Senekw/chronoflow/manuscript/chronoflow.pdf

## ChronoFlow: an electricity-free, volumetric, clockwork-governed syringe infusion driver for neonatal care in low-resource settings

Design-and-simulation study — October 6, 2026

Abstract
Hospitals without reliable electricity deliver intravenous fluids and drugs to newborns by gravity drip or by hand. The only non-electric infusion devices available meter flow by pushing fluid through a restriction, so the delivered rate depends on fluid viscosity (temperature, drug) and on downstream pressure; low-cost electric pumps still need batteries and cost hundreds of dollars. We present ChronoFlow, a wind-up syringe driver that meters volume rather than pressure: a constant-force spring pushes the plunger and a rack-and-pinion drives a 3D-printed step-up gear train into a clockwork escapement whose balance wheel sets the rate. Two design problems were identified and solved by simulation. First, the mechanical power available to the escapement varies 24× across syringe sizes, clinical rates and loads (17–416 µW); a conventional lever escapement, whose impulse scales with train torque, over-banks over most of this range. Adapting the gravity-escapement principle of tower clocks with springs—a constant-force spring-arm escapement—delivers a fixed impulse energy per beat and holds the balance amplitude constant over the full range with a period error below 0.06 %. Second, a cross-spring flexure pivot was shown by a beam-column finite-element model to change stiffness by 17 % under the balance’s own weight; it was replaced by a taut-band torsion suspension made from 0.0015 in (38.1 µm) feeler-gauge steel ribbon, giving a 1.20 Hz balance with ±0.19 % orientation sensitivity and no pivot friction. Colour-coded gear cassettes provide 1, 2, 5 and 10 mL/h on a 20 mL syringe (0.4–19.5 mL/h across 5–60 mL syringes) at 0.12–1.16 µL per beat. A 20 000-sample Monte-Carlo error budget predicts that 95 % of units deliver within ±1.14 % of the set rate, compared with +45 % at 37 ◦C and −33 % at 100 mmHg back-pressure for flow-restriction pumps. A trip spring whose preload is keyed to the syringe size stops the oscillator and raises a flag at 300 mmHg occlusion (280–320 to 202–398 mmHg across syringe sizes once plunger-friction uncertainty is included) and a syringe-latch interlock prevents free-flow boluses. The 95-part assembly was modelled parametrically, checked for interferences and exported for printing; the bill of materials is $40. No physical prototype has yet been built; a bench protocol following IEC 60601-2-24 [13] is provided.

## 1 Introduction

Neonates require maintenance fluids at 60–100 mL/(kg d) and drugs such as antibiotics, dextrose and inotropes at 0.5–10 mL/h; a 10 % rate error or an uncontrolled bolus of a few millilitres is clinically significant. Electronic syringe pumps meet this need where mains power, batteries and service infrastructure exist. Where they do not, three alternatives have been described. Low-cost electromechanical pumps such as AutoSyP combine a constant-force spring with a motor and battery and reach ±4 % accuracy at a cost of goods of about $500 [1]. Non-electric flow-restriction devices (elastomeric pumps, the Springfusor, and an adjustable air-over-oil design [2]) obey Q ∝ ∆P/µ and therefore drift with fluid viscosity, temperature and back-pressure. Clockwork metering has been reported four times: a gravity-driven neonatal driver regulated by a pendulum metronome, which must sit level and still [3]; a wind-up kitchen-timer movement adapted for microfluidics [4] and its fully 3D-printed successor with a hairspring balance [5, 6], both with fixed rates set by gear choice and about an hour of running time; and a spring-driven leadscrew pump whose escapement is actuated electrically for insulin dosing [7].

The gap is a non-electric device that meters volume, works in any orientation, offers selectable clinical rates, runs for a full syringe without re-winding and has mechanical occlusion detection and free-flow protection. ChronoFlow addresses it by returning to two solutions from precision mechanics: the constant-force escapement, introduced by Denison for tower clocks whose train torque varied with wind and ice on the hands [8], and the taut-band suspension of galvanometers, which removes pivot friction and most positional error.

## 2 Design

### 2.1 Architecture and metering principle

Figure 1a–b shows the machine. Two constant-force springs (44.5 N total, 2 × 5 lbf) pull a carriage toward the syringe nozzle. The plunger load—syringe friction of 1.5–4.5 N plus pressure times bore area, up to 26.9 N for a 60 mL syringe at the 300 mmHg trip—absorbs part of this force; the excess back-drives a module-1 rack and 12-tooth pinion through a 5 × 5 × 5 × 2.5 = 312.5 step-up train and a plug-in rate cassette to a 15-tooth escape wheel. The escapement releases one half-tooth per beat of the balance, so the plunger advance per beat is fixed by geometry:

∆x =

πmz0

2Ze Nfixed rc

=

π · 1 · 12
2 · 15 · 312.5 · rc
mm, | (1)

which is 4.0 µm (1.16 µL on a BD 20 mL syringe) for the unity cassette. Because the metered quantity is displacement, viscosity, temperature and downstream pressure do not enter the rate until the occlusion trip point (Fig. 1c–d). The spring force is constant over the 95 mm travel, so runtime is set only by syringe volume (2–20 h per 20 mL fill) and the device never needs re-winding mid-infusion. A one-way click on the rack-pinion shaft lets the carriage be pulled back freely, so loading a syringe is the winding action (4.2 J stored, about eleven times the 0.37 J the escapement dissipates in 20 h).

### 2.2 Constant-force spring-arm escapement

Power delivered to the escapement is P = Fexcess v. With Fexcess between 17.6 N (60 mL syringe at its 300 mmHg occlusion trip) and 43.0 N (free-running 5 mL syringe) and v spanning the 1–10 mL/h cassettes, P ranges from 17 µW to 416 µW; after a train efficiency of 0.95×0.92⁶ = 0.58 (seven meshes in total: the rack mesh at 0.95 and six printed gear meshes at 0.92—four step-up, two cassette; the escape wheel shares the cassette output shaft) the escape-wheel torque spans 19–476 µN m, a 24× range. In a lever escapement the impulse energy delivered to the balance is proportional to this torque, so the balance amplitude scales as √
Te; our dynamic model (Section 3) shows it exceeding the 1.2 rad banking limit over most of the operating range (Fig. 2b–c). Stalling at the low end or over-banking at the high end are both failures of rate.
The spring-arm escapement (Fig. 2a) separates the two energy flows. Each escape-wheel tooth cocks one of two impulse arms against a printed flexure until a latch engages (phases 1–2). The train is then locked and any excess torque simply sits on the lock. When the balance passes, its impulse pin trips the latch (phase 3) and the arm delivers a fixed energy Eimp = 1.2 µJ over a 15◦ arc; the wheel then advances one half-pitch, re-cocks the opposite arm and relocks, the surplus train energy being dissipated in the locking impact. Train torque only has to exceed the re-cock minimum Tmin = Eimp/(ηlift π/Ze) = 9.5 µN m. The simulation confirms constant amplitude (0.59 rad at Q = 150) and a period error of 0.06 % from the slightly asymmetric impulse window across the whole torque range (Fig. 2c–d). Because the balance’s air damping cannot be known before a prototype exists, Q was swept from 40 to 800: amplitude settles between 0.31 and 0.99 rad and the period error between 0.45 and 0.01 % (Fig. 2e), a fixed offset that trim calibration absorbs.
The beat-level model takes Eimp and the latch cost as given; a mechanism-level analysis (Fig. 3, analysis_arm_mechanism.py) now predicts both from the specified parts and follows the escape wheel through a beat. The impulse energy is computed forward: a music-wire torsion spring of


Figure 1: A spring-driven, clockwork-governed syringe driver meters volume, so the delivered rate is independent of fluid temperature and back-pressure. (a) Labelled render of the parametric CAD assembly with a BD 20 mL syringe at 85 % fill and the 10 mL/h cassette. (b) Energy and metering chain; the left arrow follows energy from the spring to the balance, the right arrow follows the rate constraint back from the balance to the plunger. (c) Steady-state flow error versus fluid temperature for a flow-restriction pump calibrated at 20 ◦C (water viscosity from the Vogel equation) and for ChronoFlow (oscillator temperature coefficient −1.8 × 10−4 K−1
). (d) Flow error versus downstream back-pressure; ChronoFlow stops and flags at the 300 mmHg trip point. Green band: ±5 % clinical tolerance.

k = 1 × 10−4 N m/rad on the arm pivot, pre-loaded to 26.3

- by the latch, drives the arm (pivot-totip 59 mm) against the impulse pin on the hub (r = 6.2 mm); integrating the tip force through the pin’s circular path over the 15◦
impulse arc, with the cos φ work factor and a sliding loss µ = 0.15, gives Eimp = 1.20 µJ for an arm unwinding of 27 mrad, consistent with the value the beat model had assumed. The force droops by 6 % over the arc (this is the sense in which the impulse is “constant”); the energy changes by 3.9 % per degree of preload, so a 0.1 mm latch-position tolerance biases it by 1.4 % per build, beat-to-beat release scatter (5 µm) by 0.07 %, and µ between 0 and 0.3 by ±1.3 %. The printed 0.8 mm PETG flexure of earlier revisions is unsuitable for the opposite reason to the one given in revision 4: its stiffness, 3EI/L³
r

2 = 0.0149 N m/rad, is 150× higher than the wire spring’s, so to deliver 1.2 µJ it would need a preload of only 17 mrad—less than the 27 mrad stroke—and its force would pass through zero before the end of the impulse; it cannot act as a constant-force element, and the CAD now carries wire springs on the arm pivots. Unlatching costs µN d with a latch load of 2.7 mN over 0.3 mm: 0.10–0.35 µJ for µ = 0.1–0.4 (9–29 % of the impulse; the beat-level model had assumed 0.12 µJ). Re-running the beat simulation about the forward value, over Eimp ± 10 % and this unlatch range, moves the period error only between 0.050 and 0.108 % (Fig. 3d), a bias within the trim range.
Two consequences for the wheel itself are less benign. First, the wheel force on the locked tooth, Te/rw = 1.6–40 mN, exceeds the 8.9 mN arm force at the pallet above 107 µN m, i.e. over most of


Figure 2: A constant-force spring-arm escapement keeps balance amplitude and rate independent of the 24× variation in train torque that defeats a conventional lever escapement. (a) Working principle: a wheel tooth cocks a spring-loaded impulse arm (1), a latch holds it while the wheel is locked (2), the balance pin trips the latch and receives a fixed impulse (3). (b) Simulated balance angle θ(t) for both escapements at the minimum and maximum operating torques (19 and 476 µN m; RK4, Q = 150); dashed lines mark the banking limit. (c) Steady amplitude and (d) period error relative to the free oscillator versus escape-wheel torque; shaded band: operating range. Ticks at zero mark torques below the spring-arm re-cock minimum. (e) Spring-arm amplitude and period error versus the balance quality factor Q.

the operating map, so the wheel cannot be held by the arm during impulse: a separate detent locks the wheel. Its release is now a drawn linkage (Fig. 7b): each arm carries a tail behind its pivot (16 and 14 mm, ending just beyond and just short of the wheel axis so that the two tails, which move in opposite directions, turn a common release star the same way); the star turns on a stub axle coaxial with the escape shaft below the wheel, and its third arm pushes the L-tail of the detent lever, whose pivot sits tangentially beside the locking pin so that the pin withdraws radially. First-order kinematics of the drawn proportions give a pin withdrawal of 0.83–0.94 mm against the 0.6 mm needed to clear the tooth tips—a margin of 1.4–1.6 that is a bench-tuning item. Second, the surplus energy per beat, Teπ/Ze − Eimp/ηlift, is 2–98 µJ and arrives at the detent as kinetic energy of the wheel and the cassette gears reflected to it (Jeff 825–3670 g mm²
). The timing budget is set by the single wheel, not by the alternating arms: although each arm has a full period to be re-cocked, the wheel must complete its half-pitch run—detent release at the end of the impulse, free arc, cocking arc, re-lock—before the next beat, 0.416 s later, so the budget is half a period minus the impulse time, 0.36 s (revision 4 had used the full period). Integrating the wheel through the free and cocking arcs gives a re-cock-and-lock time of 0.06–0.14 s, a margin of 2.5× at the 1 mL/h cassette minimum and 3.2–4.0× for the other cassettes (Fig. 3a). A rigid steel-pin-on-PETG detent would see 2–14 N per impact and Hertz stresses of 35–92 MPa, beyond the 50 MPa PETG yield over most of the range, 1.7 × 10⁵
times per 20 h infusion. The detent is therefore carried on a 0.8 × 4 × 8 mm PETG flexure (k ≈ 2000 N/m), which limits the impact to 0.09–0.63 N and 7–19 MPa with 0.09–0.31 mm of deflection (Fig. 3b–c). The restitution and friction of these contacts are the inputs the model cannot supply; protocol step 2 measures them.


Figure 3: Mechanism-level analysis of the spring-arm escapement over the 24× torque range.
(a) Time for the escape wheel to run half a pitch, re-cock the arm and lock, against the budget of one beat interval (half a period) minus the impulse time; thick segments mark each cassette’s own torque range, Jeff is the wheel plus reflected cassette inertia. (b) Surplus energy per beat arriving at the detent and the resulting peak lock force for a rigid steel-pin-on-PETG stop and for the 2000 N/m flexure detent. (c) Per-beat energy ledger at the minimum, a mid-range and the maximum torque. (d) Period error from the beat-level simulation about the forward-model impulse energy, for Eimp ± 10 % and unlatch work spanning µ = 0.1–0.4.

### 2.3 Taut-band balance

The oscillator (Fig. 4a) is a printed PETG ring (62 mm outer diameter, 7.4 g, I = 5.2 × 10−6 kg m² )
clamped at the midpoint of a 2 mm-wide spring-steel ribbon cut from a 0.0015 in (t = 38.1 µm) feeler-gauge blade, held at both ends and pre-tensioned to T0 = 1 N by a steel coil spring. Each 22 mm half-band is a torsion spring [9] of stiffness

khalf =

GJ
Lh

+

T w²

12Lh

, J =

1

3wt³

(
1 − 0.63 t
w

)
, | (2)

giving k = 2.95 × 10−4 N m/rad and f0 = 1.20 Hz. Because k ∝ t
3
, the ribbon thickness is the dominant uncertainty: feeler stock is held to about ±2.5 µm, which alone would move f0 by ±9 %, far beyond any trim-weight range (an earlier revision modelled a 40 µm ribbon, 6 % off the true stock). Regulation is therefore two-stage. Both end clamps are adjustable (Fig. 7e): the upper clamp block is screwed through two M3 slots in a steel hanger plate bolted through the deck, and the lower clamp slides on guide pins in matching slots of a bracket that also carries the screwed spring-seat block of the tensioner, so the two are moved symmetrically and each half-band length Lh can be set between 18 and 26.5 mm while the hub stays centred; with k = khalf(Lup)+khalf(Llow) evaluated with each half’s actual length, symmetric adjustment to 18.4–26.1 mm re-centres f0 for


Figure 4: A taut-band suspension gives a friction-free 1.2 Hz balance whose rate is insensitive to orientation, temperature and fatigue. (a) Construction: feeler-gauge ribbon clamped to the deck and to a spring-loaded tension clamp, balance ring clamped at mid-span. (b) Balance frequency versus radial position of the four trim nuts; the dashed line is the target for the unity cassette and the band is ±0.5 %.
(c) Frequency change between the band-horizontal and band-vertical positions for the taut band, compared with the computed first-order change of a 0.05 mm cross-spring flexure pivot under the same balance weight.
(d) Peak ribbon shear stress versus amplitude; shaded band: amplitudes reached for Q = 40–800. (e) Rate drift versus ambient temperature.

any ribbon between 35.6 and 40.6 µm (coarse, set once per ribbon). Adjusting one clamp alone would halve the sensitivity (1.1 % per mm against 2.2 %) and the same slot would then cover only 36.6–39.4 µm, so one-sided adjustment is not sufficient; four M3 brass nuts in radial slots (23–29 mm) then regulate the frequency by −2.4 to +3.1 % (Fig. 4b), exactly as a clock is regulated, with a nominal set point of 26.4 mm.
Gravity enters only through the tension term: with the band vertical, the fixed-clamp half-band carries T0 ± mg while the tensioner fixes the other at T0. Because the tension term is 10 % of k and mg ≪ T0, the frequency shifts by only ±0.19 % between the upright and inverted positions (Fig. 4c). An alternative two-leaf cross-spring flexure pivot [10], analysed with an Euler–Bernoulli beam-column finite-element model including geometric stiffness, changed rotational stiffness by 17 % under the same balance weight (the governing scale is EI/L² ≈ 0.1 N, not the Euler load) and was rejected. Peak shear stress at the 1.2 rad banking limit is 166 MPa against a conservative fully-reversed fatigue limit of 350 MPa (Fig. 4d), and the temperature coefficient, combining the shear-modulus drift of steel with the thermal expansion of the ring, is −1.8 × 10−4 K−1
(Fig. 4e).

### 2.4 Rate cassettes, safety functions and structure

A plug-in cassette carries two gear pairs with constant tooth sums (z1 + z2 = z3 + z4 = 66, 33 mm
centres): (33, 33, 33, 33), (44, 22, 33, 33), (33, 33, 55, 11) and (44, 22, 55, 11) give speed-up ratios of 1, 2, 5 and 10 and hence 10, 5, 2 and 1 mL/h on a 20 mL BD syringe; other syringe sizes scale with bore area (Fig. 5a). The cassette is a visible, colour-coded object, so the set rate can be confirmed at a glance and cannot drift. Because the carriage speed is set by the cassette alone, the escape-wheel torque depends only on the cassette and on the excess force Fspring − Fplunger; the operating map was therefore evaluated over every syringe size, cassette and back-pressure from zero to the trip (80 cells). The torque exceeds the re-cock minimum of 9.5 µN m by at least 2.0× in every cell, the worst being the 60 mL syringe on the 1 mL/h cassette at its 300 mmHg trip (Fig. 5b). This map is what forced the drive spring from the 30 N of the first revision to 44.5 N: at 30 N the 60 mL trip left only 3.1 N excess, 3.4 µN m at the slowest cassette, and the escapement would have stalled before the occlusion flag was raised (two cells stalled, four below 1.7×). The per-beat volume is 0.12–1.16 µL (Fig. 5c).
Three safety functions are mechanical. (i) The occlusion trip (Fig. 6; CAD in Fig. 7c–d) is snap-acting. The pusher head rides on a 8 mm steel stem backed by a 3 N/mm compression spring whose preload is set by a spacer keyed to each syringe cradle insert, so the setting follows the syringe size automatically. When the plunger reaction exceeds the preload the stem retracts; a trip pin on its end collar stands 0.15 mm behind the tail of a sear, a printed plate on a vertical pivot whose hook lip overlaps a collar on a separate flag rod by 0.9 mm. The sear’s lever ratio (hook arm 9, tail arm 2 mm) is 4.5, so the lip clears the collar after a further 0.20 mm: the sensing travel is 0.15 + 0.9/4.5 = 0.35 mm, and it is a geometric property of the modelled parts rather than an assumption. The flag rod, driven by its own 2 N spring, then rises 6 mm and does three things: it exposes the red flag; its lift collar frees a torsion-sprung rocker on the carriage top whose short end drives a 2 mm steel capture pin 2.2 mm down into a slot in the stem top; and its head lifts a frame-mounted rail that runs the length of the carriage travel on two parallel-motion cranks, so the rail translates by the same 6 mm wherever the carriage is. A drop rod from the rail passes through the deck and raises a two-pin fork (pins at 80 and 100◦
, r = 18 mm) around a balance spoke, confining the balance to ±0.05 rad—below the 6
- unlock angle—so the escapement cannot unlock, ticking stops and pressure cannot rise further. Defining the trip at 0.35 mm rather than at a full 3 mm of stem travel matters: over 3 mm the spring force would rise by 9 N (+235 mmHg on a 20 mL syringe, and enough to take the 60 mL case below the re-cock minimum before the flag appeared); over 0.35 mm it rises by 1.05 N, and the spacer preload is set 1.05 N below the intended trip force so that the sear releases at 300 mmHg × A + Ffriction: trip forces 6.1, 8.6, 14.5, 18.3 and 26.9 N from spacer preloads of 5.0, 7.6, 13.4, 17.2 and 25.8 N (1.7–8.6 mm) for the 5, 10, 20, 30 and 60 mL syringes. The operating-map margins above are therefore unchanged by the trip. The slot’s forward wall is cut 0.35 mm short of the pin, so that after the sensing travel it is flush with the pin and the 0.35 mm of spring compression stored at the trip (0.04–0.20 mL of syringe volume, 60 mL largest) cannot advance the plunger when the blockage clears; this is checked on the solids rather than asserted: posing the tripped assembly with the stem advanced by 0.1 and 0.2 mm produces pin–stem interference (0.08 and 0.24 mm³
), while the armed and tripped poses are interference-free, and rotating the balance by ±0.04 rad inside the raised fork is free but ±0.08 rad is blocked. Ideally, then, the captured stem prevents release of the trip-spring displacement; the Boolean tests establish geometric restraint in the checked poses, not zero displacement under pin– slot clearance, deformation, wear or capture delay, so the residual displacement and the total release bolus (including the elastic volume stored in the line and syringe at 300 mmHg) require measurement against the 0.2 mL target (protocol step 5). Reset is part of loading (Fig. 7c): the LOAD/RUN lever lifts the rack-pinion click so the carriage can be pulled fully back to receive the new syringe, and in the last 12 mm of that travel the flag head runs under a frame-mounted reset ramp (6 mm drop over 6 mm, then flat) that presses the rod down: the chamfered hook collar pushes the sear lip aside and the sear snaps back over it on its return spring, the lift collar turns the rocker back and raises the capture pin out of the stem slot, and the rail settles onto the head. The Boolean check confirms the geometry: at the loading position the tripped flag head intersects the ramp (the ramp drives it down) while the armed head is clear. A force trip senses friction as well as pressure, so the pressure at which it fires carries the friction uncertainty: for ±1.5 N of plunger glide-force variation (lot, speed, dwell) the 300 mmHg setting fires between 280 and 320 mmHg on the 60 mL syringe but between 202 and 398 mmHg on the 5 mL syringe, whose bore is five times smaller. These bands are the disclosed occlusion-alarm range; tightening them for the small syringes requires measuring glide force per syringe lot and shimming the spacer, which the validation protocol includes. (ii) The LOAD/RUN lever opens the syringe flange latch and lifts the rack-pinion click together, so the carriage can only be moved by hand when the syringe is unlatched and a fast-forwarded pusher

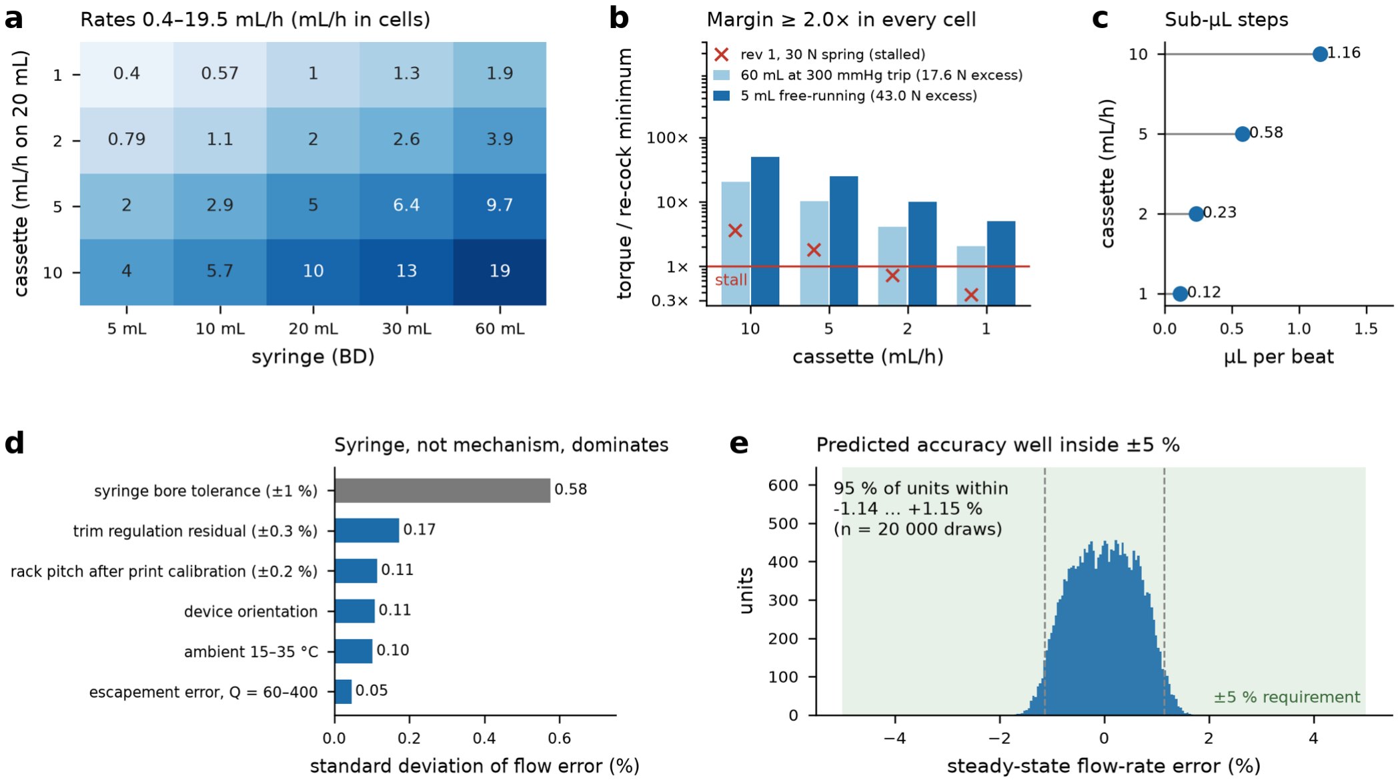
[picture p8: figure]

Figure 5: Four plug-in cassettes cover neonatal rates with torque margin and sub-microlitre resolution; the predicted error is dominated by the syringe, not the mechanism. (a) Flow rate for each cassette and BD syringe size. (b) Escape-wheel torque relative to the arm re-cock minimum at the two extremes of the syringe × cassette × pressure map (60 mL syringe at its 300 mmHg trip; 5 mL syringe free-running); crosses show the first revision’s 30 N spring, which stalled. (c) Volume delivered per beat. (d) Standard deviation of flow error contributed by each Monte-Carlo input. (e) Distribution of steady-state flow error over 20 000 draws; dashed lines mark the central 95 %.

slides the whole syringe rather than expelling fluid. (iii) The balance beats behind a window at 1.2 Hz; silence means stopped.
The most heavily loaded teeth are the rack and 12-tooth pinion: Lewis bending stress [11] at 44.5 N on an 8 mm face is 22.7 MPa against about 50 MPa PETG yield (safety factor 2.2; widening the stage-1 face to 10 mm would restore 2.75). Torque falls 5× per stage (267, 49, 9.0, 1.7 mN m), so the remaining printed gears are lightly loaded; shafts are 3 mm steel pins in printed bores.

## 3 Methods

Parametric design. All dimensions, tooth counts and oscillator parameters live in one module (design_params.py); the CAD (cad_model.py, CadQuery 2.8) derives shaft positions from gear centre distances, phases every mesh so that a wheel tooth faces a pinion gap, and exports STEP, glTF and per-part STL. The gear train is posed with the carriage: every gear is rotated by the rack displacement through the seven meshes (the displacement being trimmed by < 0.03 mm so that the escape wheel sits at a locked tooth). A pairwise interference check (bounding-box prefilter, OpenCascade Boolean common) is run over all 4 465 part pairs in twelve poses—carriage at full, half and empty syringe, armed and tripped, balance at rest and at ±0.6 rad. Overlaps are compared against an explicit list of 28 named part pairs, each with a physical reason and a volume cap (pressfit pins, threaded screws, the drawn 0.1 mm penetration of a locked tooth, the tooth-tip overlap of the unshifted 12-tooth pinions, ≤ 0.7 mm³

); anything else above 0.05 mm³ is a fault. The earlier
keyword whitelist (any pair containing “pin”, “shaft” or “axle”) and single pose were replaced in this revision; the multi-pose check found and fixed three real collisions in revision 4 (rack against the cradle at the empty-syringe position, the trip rail’s rear post against the carriage at full travel, and the capture-pin rocker against its boss in the tripped pose) and, in this revision, placed the


Figure 6: Snap-action occlusion trip: the trip force is defined by a 0.35 mm sensing travel set by the sear geometry, and the stem is captured so stored spring compression cannot become a bolus. (a) Armed, sensing and tripped states (schematic; the modelled parts are in Fig. 7c–d): spacer-set preload, 0.35 mm stem retraction turns the sear, 6 mm flag-rod release drops the capture pin into the stem slot and lifts the rail and balance fork. (b) Trip-spring force versus stem travel for three syringe sizes; the sear releases at 0.35 mm (+1.05 N, pre-compensated in the spacer); the grey band is the 3 mm direct-travel design of the previous revision. (c) Per-syringe spacer preload, trip force, firing band for ±1.5 N plunger-friction uncertainty, and the displacement stored at the sear if the stem were not captured.

detent-release and reset parts (the tripped pose is taken at 85 % fill, since at the fully retracted loading position the ramp has by construction reset the trip); the last run reports zero faults in all twelve poses (results/interference_report.json). All 95 exported STL meshes are watertight (the carriage rack previously ran a partial last tooth past its end and produced a self-intersecting profile).

Escapement dynamics. The balance obeys I

¨θ = −kθ − c

˙θ + τ (θ, ˙θ) with c = Iω0/Q, integrated by fourth-order Runge–Kutta at ∆t = 0.2 ms. For the lever model the per-beat wheel energy Teπ/Ze is split into an impulse fraction (0.70) applied over a 30◦
lift arc and an unlocking fraction
(0.12) opposing motion over 6

◦
. For the spring-arm model the impulse energy is fixed at Eimp over 15◦
starting 3
- before equilibrium, with a fixed 0.12 µJ latch-tripping cost; the escapement stalls if Te < Tmin. A reversal of the balance while the pin is inside the engagement window is treated as a fault. Period is measured over steady-state zero crossings. The mechanism-level model (analysis_arm_mechanism.py) integrates the wheel, Jeffφ¨ = Te − Tcock(φ) − cφ˙, from the unlock to the lock over the free arc and a 0.1 rad cocking arc, with Jeff the wheel plus every upstream gear reflected by its speed ratio squared; lock forces use F =

√
2Ekstop and Hertz line contact for a 1 mm steel pin on PETG (E∗ = 2.2 GPa).

Table 1: Predicted performance of ChronoFlow (BD 20 mL syringe unless stated) and bill of materials.

Quantity | Value
Rates (cassettes 1/2/5/10) | 1, 2, 5, 10 mL/h; 0.4–19.5 mL/h across 5–60 mL syringes
Resolution | 0.12–1.16 µL per beat, 2.4 beats s−1
Oscillator | 1.2017 Hz; coarse Lh 18–26.5 mm, trim −2.4/+3.1 %; orientation ±0.19 %;
| −1.8 × 10−4 K−1
Escapement | amplitude 0.59 rad (Q = 150), period error 0.06 % (0.05–0.11 % over Eimp ±
| 10 %, µ 0.1–0.4); torque margin ≥ 2.0× over 5 syringes × 4 cassettes × 0–
| 300 mmHg; forward-model impulse 1.20 µJ; re-cock + lock ≤ 0.14 s vs 0.36 s
| beat budget (≥ 2.5×); detent impact ≤ 0.63 N, 19 MPa, 0.31 mm with flexure
| detent
Accuracy (Monte-Carlo, n = 20 000) | 95 % of units within −1.14 to +1.15 %; 99th percentile |error| 1.36 %
Restriction-pump compara- tor | +45 % at 37 ◦C; −23 % at 10 ◦C; −33 % at 100 mmHg back-pressure
Occlusion trip | 300 mmHg nominal; snap-action sear at 0.35 mm sensing travel (from the sear
| geometry), spacer preload keyed to cradle insert (5.0–25.8 N, trip 6.1–26.9 N);
| fires at 280–320 (60 mL) to 202–398 mmHg (5 mL) for ±1.5 N friction; stem
| captured by a pin in a slot (geometric restraint verified by solid Booleans;
| residual displacement to be measured)
Energy | 4.2 J stored per wind; 0.37 J consumed in 20 h
Structure | rack-pinion tooth stress 22.7 MPa (SF 2.2); band stress 166 MPa vs 350 MPa
| limit
Parts, cost | 95 parts, ≈420 g PETG, BOM ≈ $40; zero interference faults in 12 poses;
| 95/95 STL meshes watertight

Oscillator. Band stiffness follows Timoshenko’s thin-strip torsion with the tension term; the cross-spring pivot comparison uses a 60-element Euler–Bernoulli beam-column model per leaf (elastic plus geometric stiffness), with the balance rotating rigidly about the crossing point and gravity resolved onto the two leaves.

Error budget. 20 000 Monte-Carlo draws combine a uniform syringe bore-area spread of ±1 % (an assumption: ISO 7886-1 [14] specifies the capacity tolerance of the finished syringe, not the within-lot bore distribution, and manufacturer bore data were not available to us; systematic differences between syringe models and design revisions are absorbed by the per-model cradle insert and calibration, and the protocol measures the within-lot bore spread of ten syringes per lot—with ±2 or ±3 % spread the central 95 % band would widen to about ±2.1 and ±3.2 %, still inside the ±5 % requirement), trim regulation residual (±0.3 %), rack pitch after print-scale calibration (±0.2 %), ambient temperature (15–35 ◦C), orientation (±0.19 %) and the escapement error for Q uniformly in 60–400 after calibration at the mean.

Comparators. Flow-restriction pumps are modelled as Q ∝ (Pdrive −Pback)/µ(T) with water viscosity from the Vogel equation [12] (µ = 0.02939 exp[507.88/(T −149.3)] mPa s) and drive pressures of 300 and 500 mmHg.

## 4 Results

Table 1 collects the predicted performance. Two results carry the design. First, the escapement study (Fig. 2) shows that the conventional lever escapement is unusable across the clinical range—its amplitude passes the banking limit at about 40 µN m, below the mid-point of the operating band— whereas the spring-arm escapement holds 0.59 rad from the re-cock minimum upward with a period error of 0.06 %. Second, the suspension study (Fig. 4) shows that the taut band reduces orientation sensitivity by a factor of about forty relative to a cross-spring pivot of the same leaf stock, while keeping the ribbon stress at 47 % of the fatigue limit at the banking amplitude. The system-level consequences (Fig. 5) are a rate set entirely by integers (tooth counts) and one calibrated frequency, a torque margin above the re-cock threshold at every rate, and a predicted accuracy distribution whose width is set mainly by the syringe bore tolerance that every syringe pump shares.
Against flow-restriction pumps the difference is categorical rather than incremental (Fig. 1c–d): a restriction pump calibrated at 20 ◦C over-delivers by 45 % at body temperature and loses a third of its rate against 100 mmHg of venous or catheter back-pressure, whereas ChronoFlow drifts by less than 0.4 % over 10–40 ◦C and is unaffected by back-pressure until it trips.
The CAD model (Fig. 7) is complete at the part level: deck and bottom plates, pillars, rails, cradle with flange latch and barrel clamp, carriage with integrated rack, the pusher stem with keyed spacer, trip spring, sear, flag rod, rocker and capture pin, the trip rail with its cranks, drop rod and balance fork, the reset ramp, spring drum, the four-stage train, cassette, escape wheel, two impulse arms with wire torsion springs, release tails and latch, the release star and the radially acting wheel detent, and the balance with band, slotted clamps and tensioner. The model is built in two states (armed and tripped), the capture function and the reset are demonstrated on the solids (Fig. 7c–d), and the two operating links that revision 4 left undrawn—arm-to-detent release and the trip reset—are now parts.

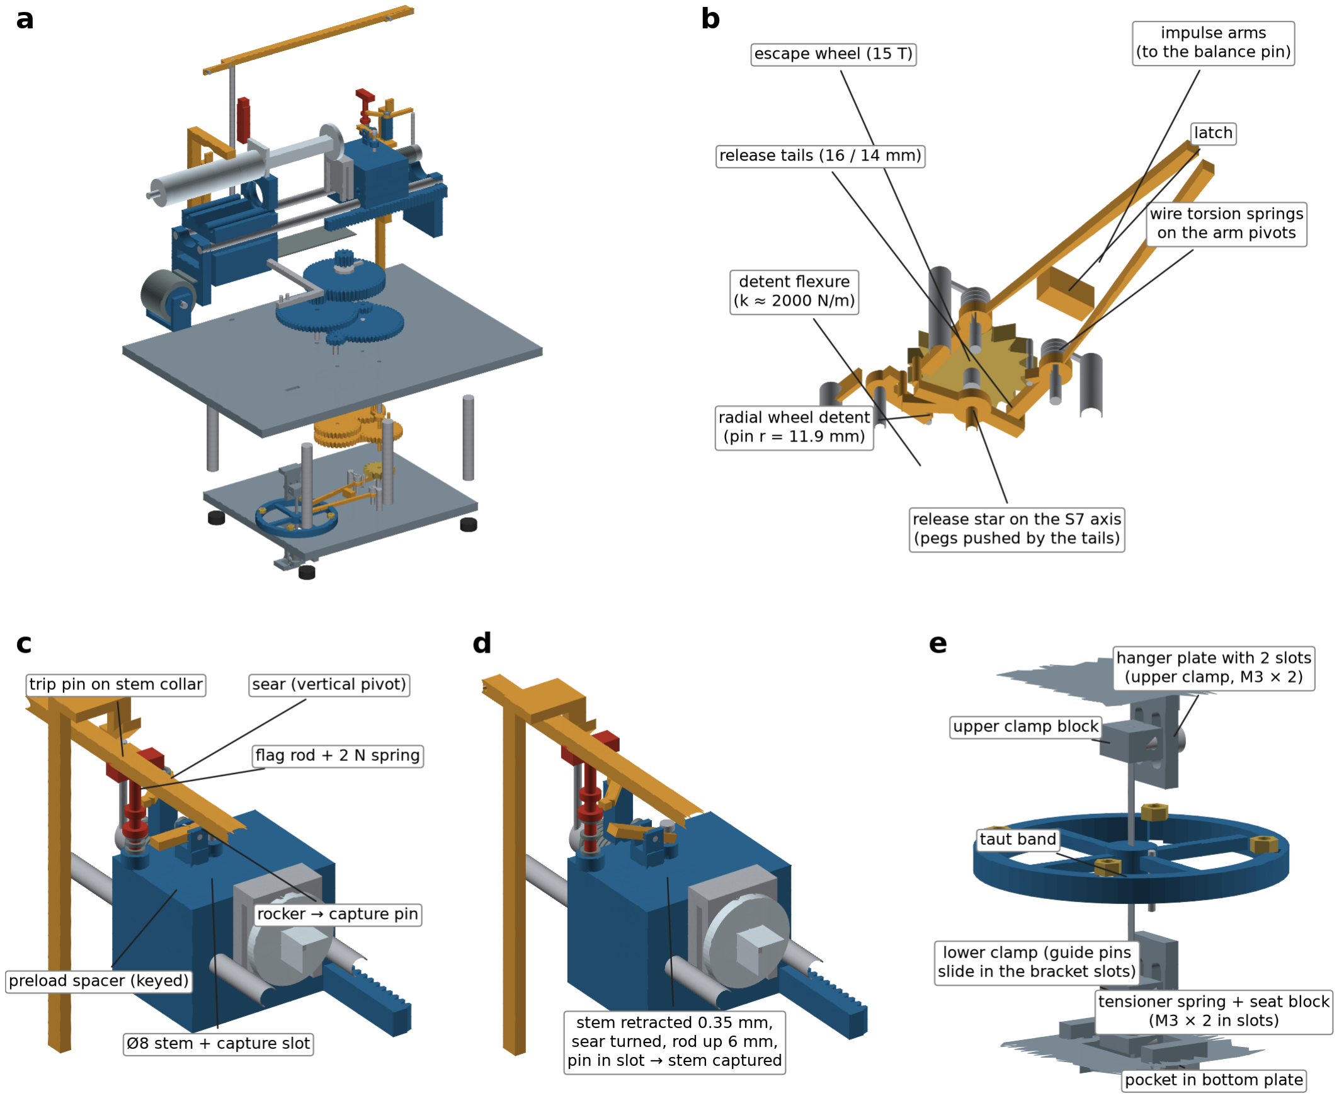
[picture p9: figure]

Figure 7: The 95-part assembly, including the snap-action occlusion trip with its reset ramp, the detent-release linkage and the adjustable band clamps, is modelled and interference-checked in twelve poses. (a) Exploded view with parts separated along the vertical axis. (b) Escapement module with the deck removed: cassette, escape wheel, impulse arms with wire torsion springs and release tails, release star on the escape axis, radially acting compliant wheel detent, balance with stop fork and slotted clamp hanger. (c) Occlusion trip on the carriage, armed: keyed spacer and trip spring behind the stem, trip pin on the end collar, sear on its vertical pivot holding the flag-rod collar, rocker and capture pin over the stem; the reset ramp is visible ahead of the flag head. (d) The same parts in the tripped pose: stem retracted 0.35 mm, sear turned, flag rod up 6 mm, capture pin in the stem slot, rail lifted. (e) Band clamps: slotted hanger plate with M3 screws for the upper clamp, slotted bracket with guide pins and screwed spring-seat block for the tensioner, both covering Lh 18–26.5 mm.

## 5 Discussion

ChronoFlow converts two precision-mechanics solutions—the constant-force escapement and the taut-band suspension—into a printable, electricity-free infusion driver whose predicted accuracy is limited by the syringe rather than by the fluid, the temperature, the back-pressure or the orientation of the device. Every safety function is mechanical and visible, and the rate is a physical object a nurse can hold and verify.
Several limitations follow from the fact that this is a design-and-simulation study. All performance figures are model predictions; the models are physics-based but unvalidated until the bench protocol below is executed. The balance quality factor in air and the efficiency of printed gear meshes are the least certain inputs; both were swept and both affect margin rather than rate. The spring-arm escapement geometry in the CAD is a representative embodiment whose latch, arm and detent proportions will need iteration on the bench, as horological escapements invariably do; the detent-release linkage and the reset ramp are drawn but their first-order kinematic margins (1.4–1.6 on pin withdrawal) are small. The mechanism-level analysis predicts the impulse energy from a specified spring rather than assuming it, but its contact parameters (latch and tip friction, detent restitution) are inputs the bench must supply, and the stem capture is a geometric restraint whose residual displacement under clearance, deformation and wear is unmeasured. Standalone reproduction of every figure was re-tested in this revision: the analysis scripts fall back to a bundled copy of the plotting helpers when the authoring environment is absent. The occlusion trip must be set per syringe size, which is a training requirement, and rates between cassettes require an additional printed cassette (any tooth set with sums of 66 can be made). The 0.12–1.16 µL pulsatility is small compared with a 50 µL gravity-drip drop, but very low-rate inotrope infusions below 0.5 mL/h would be better served by a 5 mL syringe.

Validation protocol. (1) Measure the ribbon thickness with a micrometer (±1 µm) and set the clamp post to the Lh the stiffness model gives for that thickness; print the balance, clamp the ribbon and measure f0 with a 240 fps camera or light gate; set trims; measure Q from the free-decay envelope; repeat band-horizontal, clamp-up and clamp-down (acceptance ±0.3 %). (2) Drive the escape wheel through the cassette with hanging weights emulating 17.6 and 43 N excess (the 60 mLat-trip and 5 mL-free-running corners of the operating map); verify re-cocking within one beat interval at the 1 mL/h cassette and constant amplitude by video tracking; measure the impulse energy from the balance’s amplitude decay with the arm disengaged versus engaged, and the detent-release margin by shimming the arm tails; tune the torsion-spring preload (latch position) and the detent pin radius. (3) Gravimetric flow test per IEC 60601-2-24 on a 1 mg balance logged every 30 s for 2 h per cassette; compute trumpet curves (acceptance: mean error ±5 %, trumpet ±10 % at 2 min). (4) Repeat at 0, 100 and 200 mmHg back-pressure and with 10 % dextrose at 20 and 37 ◦C (expected change < 1 %). (5) Occlusion, for each syringe size with its cradle insert: measure plunger glide force on a load cell at the cassette speed (five syringes per lot), then clamp the line and record trip pressure against the predicted band (280–320 to 202–398 mmHg for 60 mL to 5 mL; shim the spacer if the lot’s glide force differs from nominal by more than 0.5 N), time to trip, the stem position after trip (dial gauge: residual creep of the captured stem under clearance and deformation), the total bolus on release (< 0.2 mL, line compliance plus any residual stem displacement), and the reset at full retraction. Measure the bore of ten syringes per lot (bore gauge) to replace the assumed ±1 % area spread. (6) Orientation and vibration (expected < 0.5 %). (7) Seven-day continuous run and 200 load/unload cycles.

## Data and code availability

The parametric CAD (STEP, glTF, STL), the analysis code that reproduces every figure and number in this paper, the interference checker and the interactive viewer are provided in the accompanying repository.

## References

[1] Juarez A, Maynard K, Skerrett E, Molyneux E, Richards-Kortum R, Dube Q, Oden ZM. AutoSyP: a low-cost, low-power syringe pump for use in low-resource settings. Am J Trop Med Hyg 2016;95(4):964–969. doi:10.4269/ajtmh.16-0285.
[2] Guelig D, Bauer J, Wollen A, Schiller C, Sherman-Konkle J, Roche A, Weyrauch K, Eisenstein
M. Design of a novel, adjustable flow rate, reusable, electricity-free, low-cost syringe infusion pump. ASME J Med Devices 2017;11(4):041006. doi:10.1115/1.4037935.
[3] Sung C, Kamath RR, Cui Y, Ouyang C, Carstens E, Ramos RF, Oden ZM. Design of a novel mechanical syringe pump for neonatal care in low-resource settings. In: 2011 IEEE Global Humanitarian Technology Conference; 2011. p. 78–83. doi:10.1109/GHTC.2011.21.
[4] Han W, Kim S, Shin S, Yang SY, Choi S, Shin JH. Wind-up precision pump for portable microfluidics. Sens Actuators B Chem 2021;347:130592. doi:10.1016/j.snb.2021.130592.
[5] Park SB, Shin JH. Fully 3D-printed, nonelectric, spring-powered syringe pump for operating microfluidic devices. Sens Actuators B Chem 2024;405:135289. doi:10.1016/j.snb.2024.135289.
[6] Park SB, Shin JH. Open-source spring-driven syringe pump with 3D-printed components for microfluidic applications. HardwareX 2024;19:e00550. doi:10.1016/j.ohx.2024.e00550.
[7] Pooke F, Payne M, Holder-Pearson L, Heaton D, Campbell J, Chase JG. Low-cost, low-power, clockwork syringe pump. HardwareX 2023;16:e00469. doi:10.1016/j.ohx.2023.e00469.
[8] Denison EB. A Rudimentary Treatise on Clocks, Watches and Bells. London: John Weale; 1850 (gravity escapement, ch. on remontoires and gravity escapements).
[9] Timoshenko SP, Goodier JN. Theory of Elasticity, 3rd ed. New York: McGraw-Hill; 1970. § 109, torsion of a thin rectangular strip.
[10] Haringx JA. The cross-spring pivot as a constructional element. Appl Sci Res 1949;A1:313–332. doi:10.1007/BF02120338.
[11] Lewis W. Investigation of the strength of gear teeth. Proc Engineers’ Club of Philadelphia 1893;10:16–23.
[12] Vogel H. Das Temperaturabhängigkeitsgesetz der Viskosität von Flüssigkeiten. Phys Z 1921;22:645–646.
[13] IEC 60601-2-24:2012. Medical electrical equipment — Part 2-24: Particular requirements for the basic safety and essential performance of infusion pumps and controllers. Geneva: International Electrotechnical Commission; 2012.
[14] ISO 7886-1:2017. Sterile hypodermic syringes for single use — Part 1: Syringes for manual use. Geneva: International Organization for Standardization; 2017.
