Senekw/chronoflow/figures/analysis/fig2_escapement.png

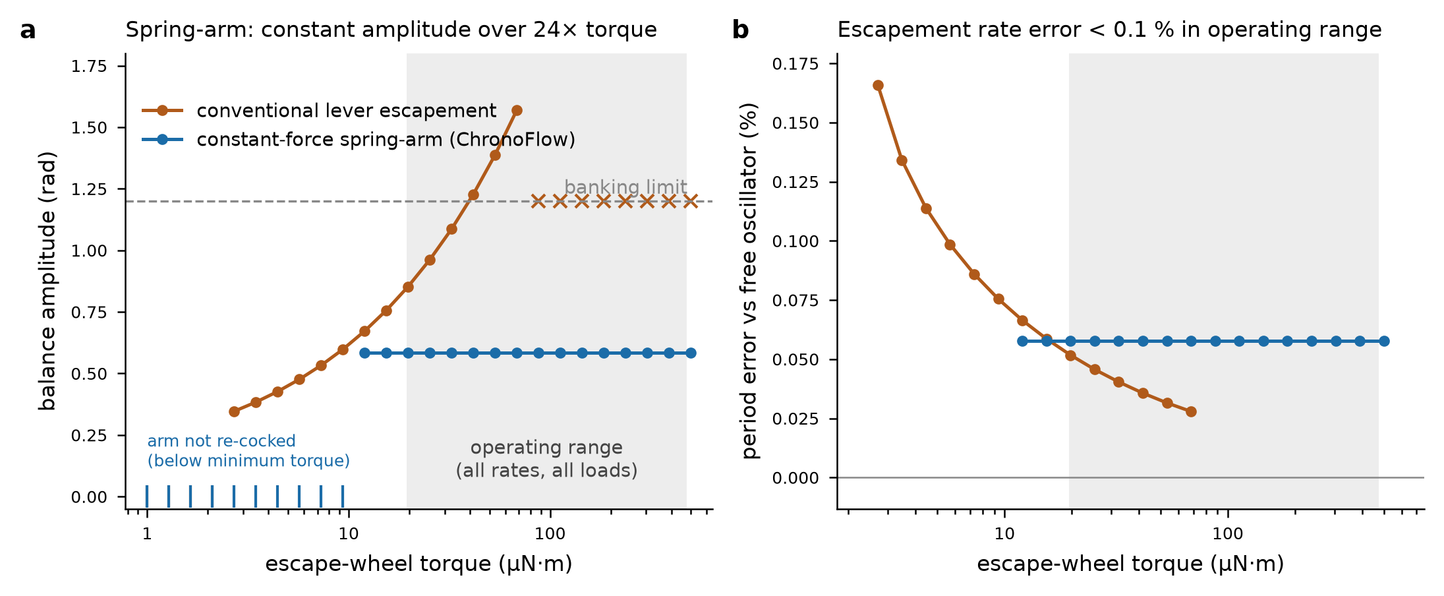
figures/analysis/fig2_escapement.png
