Senekw/chronoflow/figures/analysis/fig3_accuracy_comparison.png

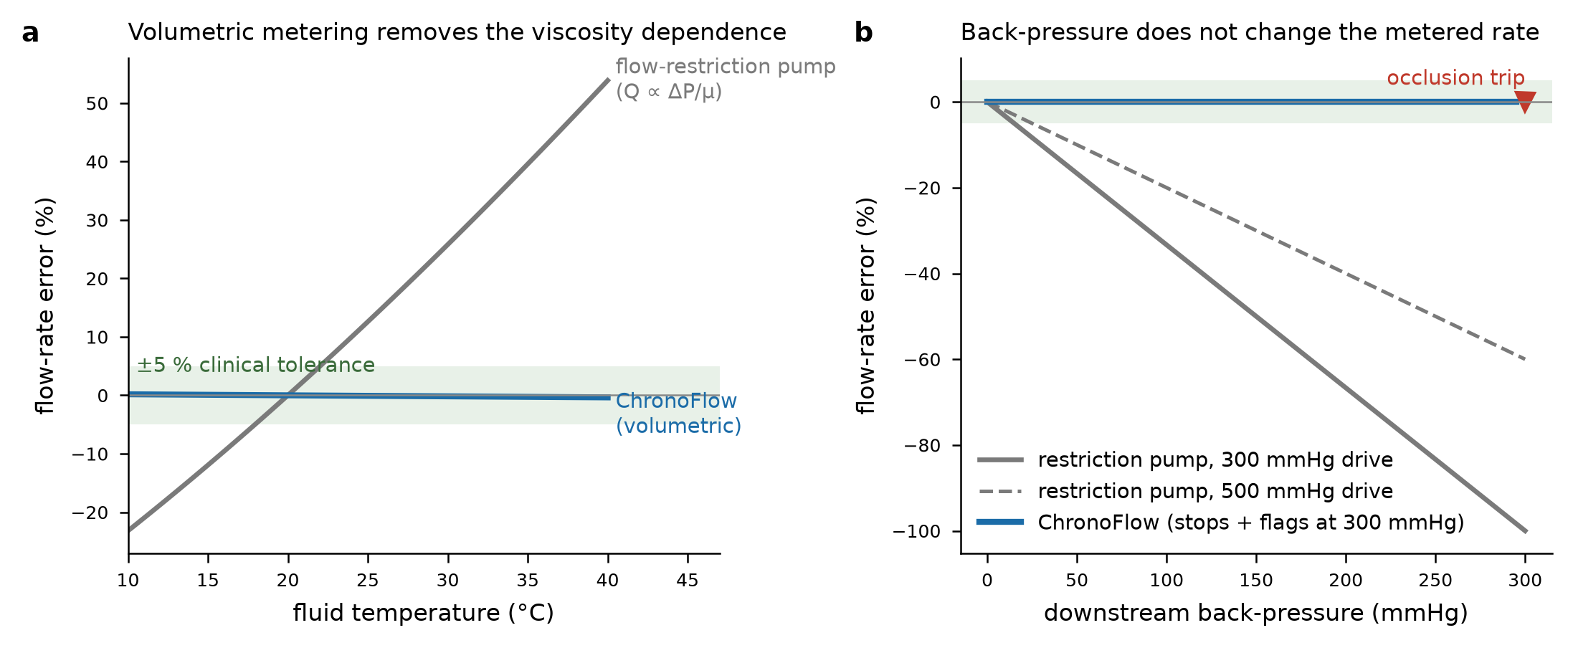
figures/analysis/fig3_accuracy_comparison.png
