Senekw/chronoflow/figures/analysis/fig4_error_budget.png

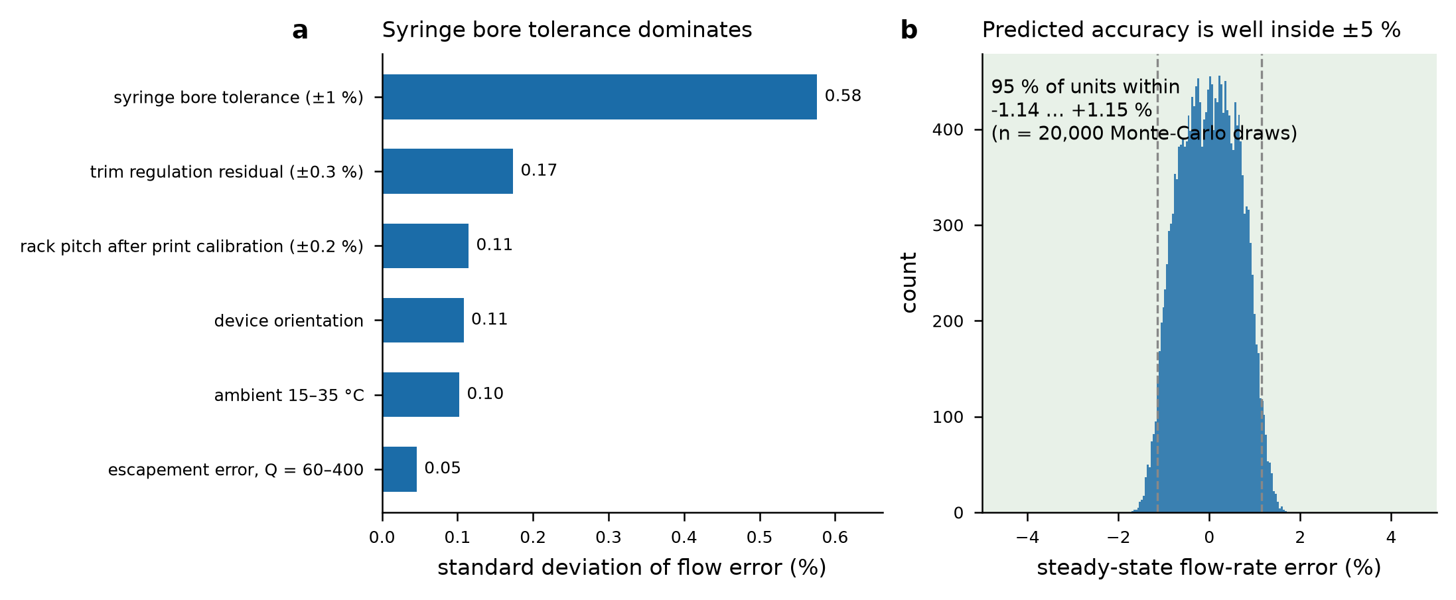
figures/analysis/fig4_error_budget.png
