Senekw/chronoflow/figures/renders/escapement_closeup.png

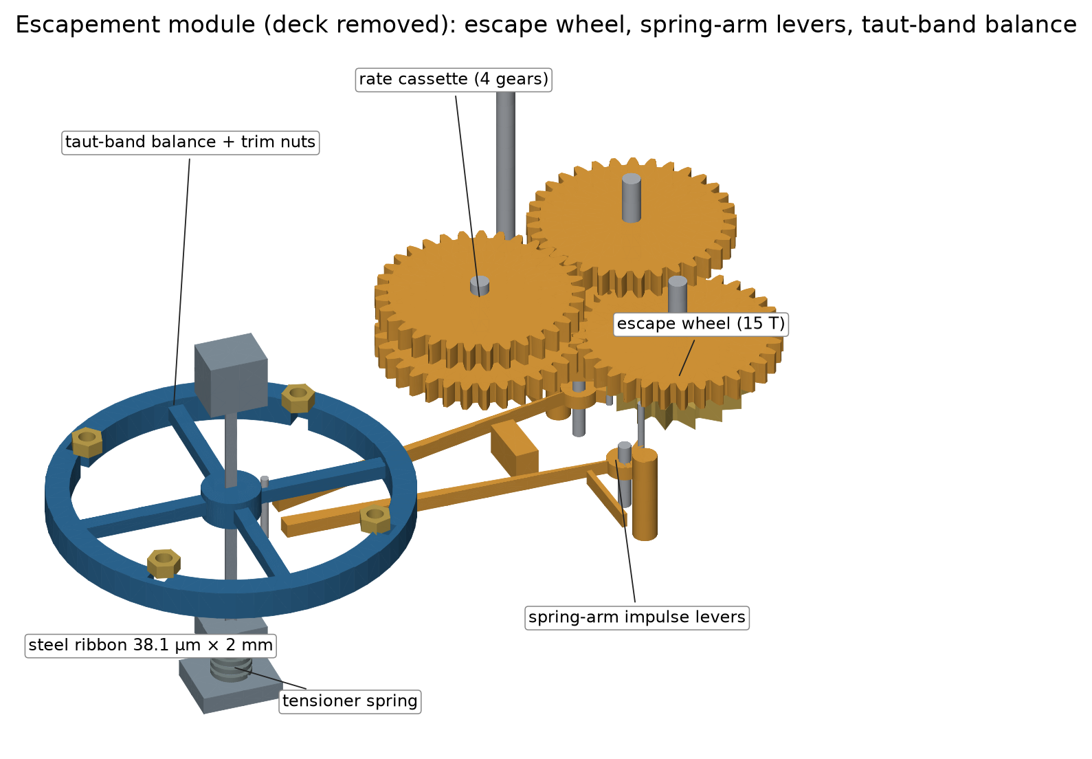
figures/renders/escapement_closeup.png
