Senekw/chronoflow/figures/renders/exploded_view.png

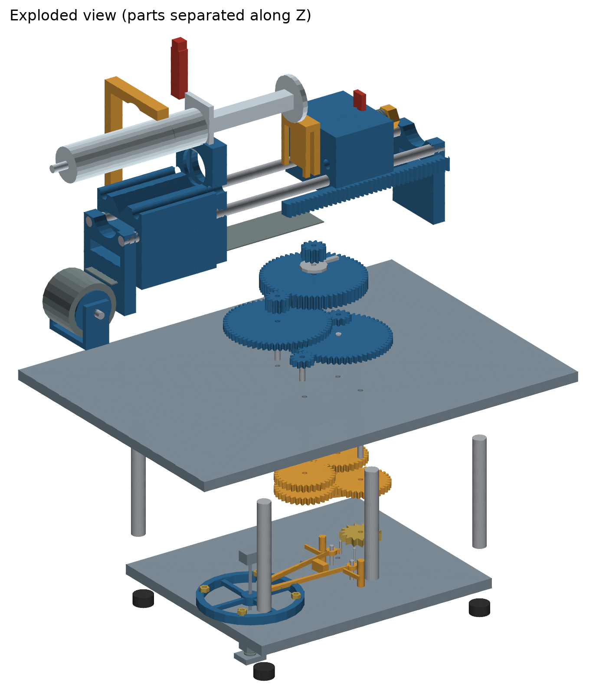
figures/renders/exploded_view.png
