Senekw/chronoflow/figures/renders/fig1_a.png

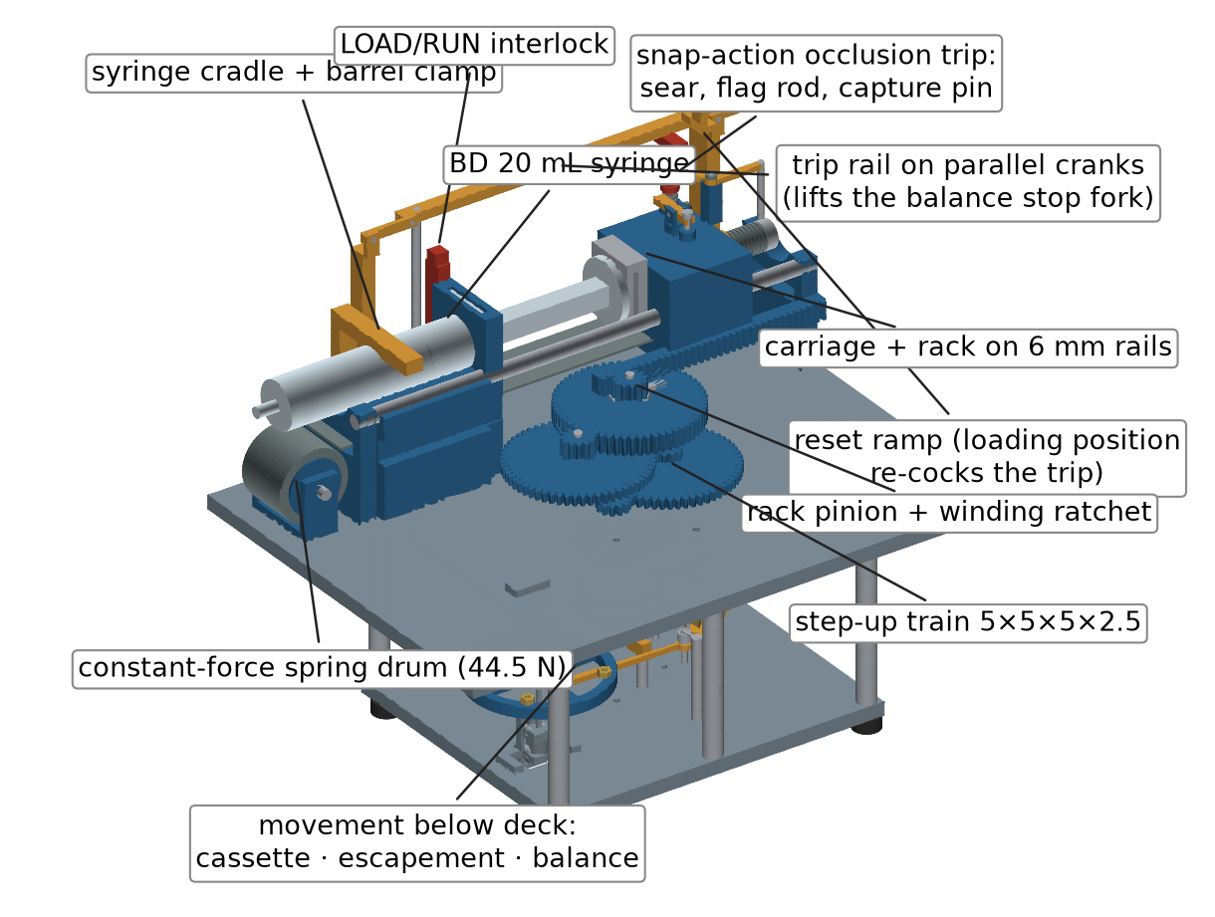
figures/renders/fig1_a.png
