Senekw/chronoflow/figures/renders/fig1_labeled_overview.png

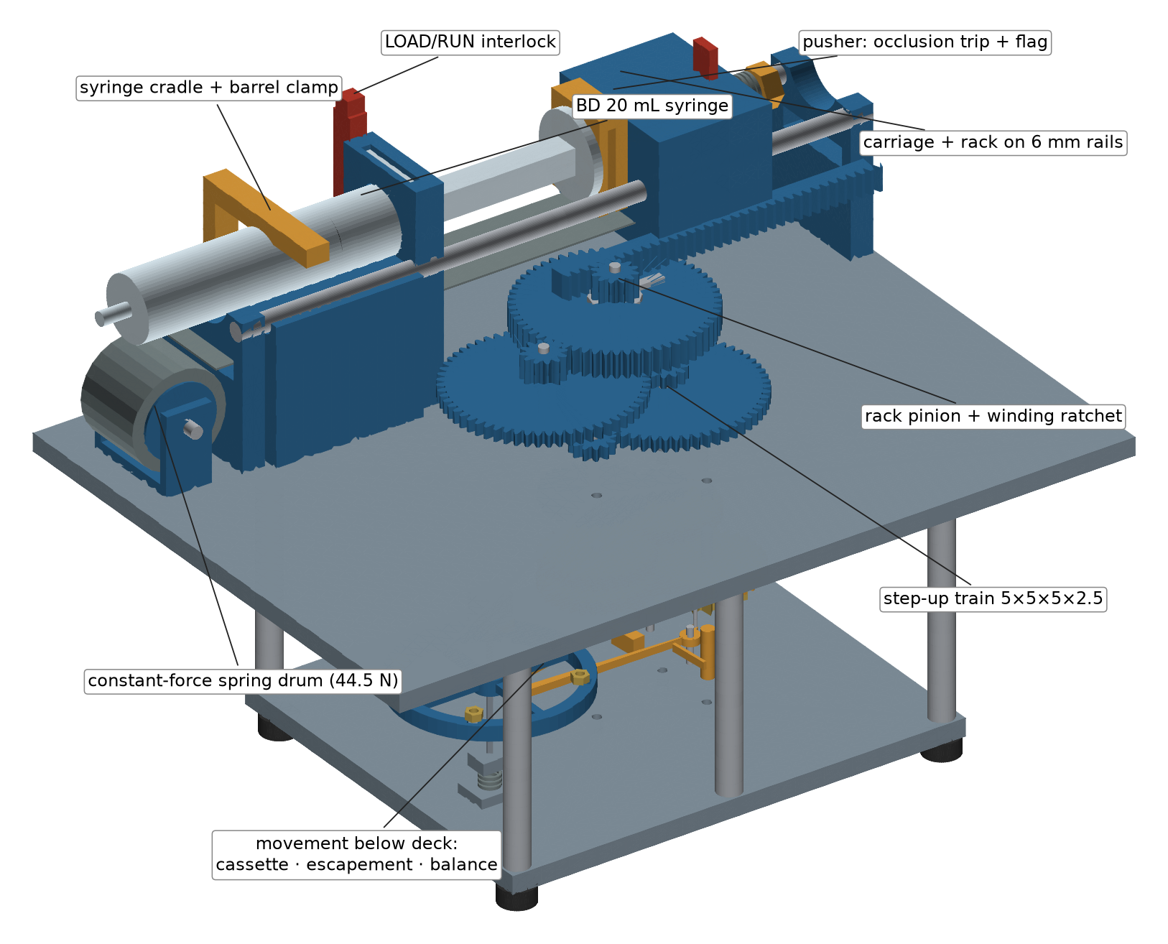
figures/renders/fig1_labeled_overview.png
