Senekw/chronoflow/figures/renders/fig5_a.png

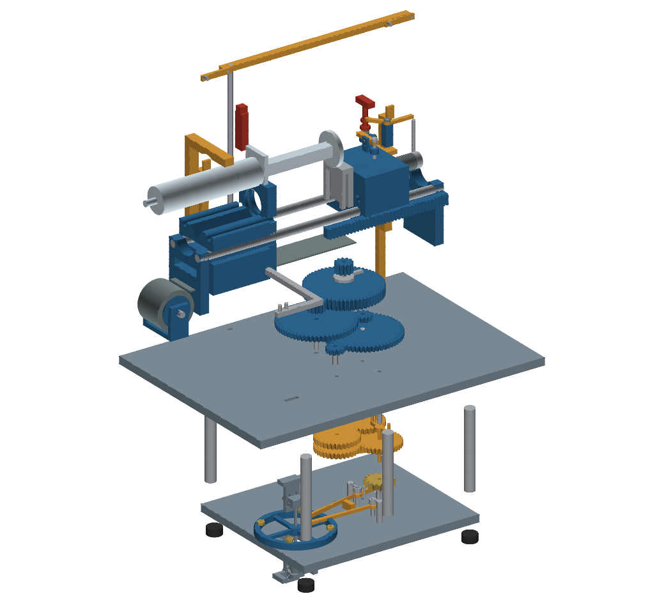
figures/renders/fig5_a.png
