Senekw/chronoflow/figures/renders/fig5_b.png

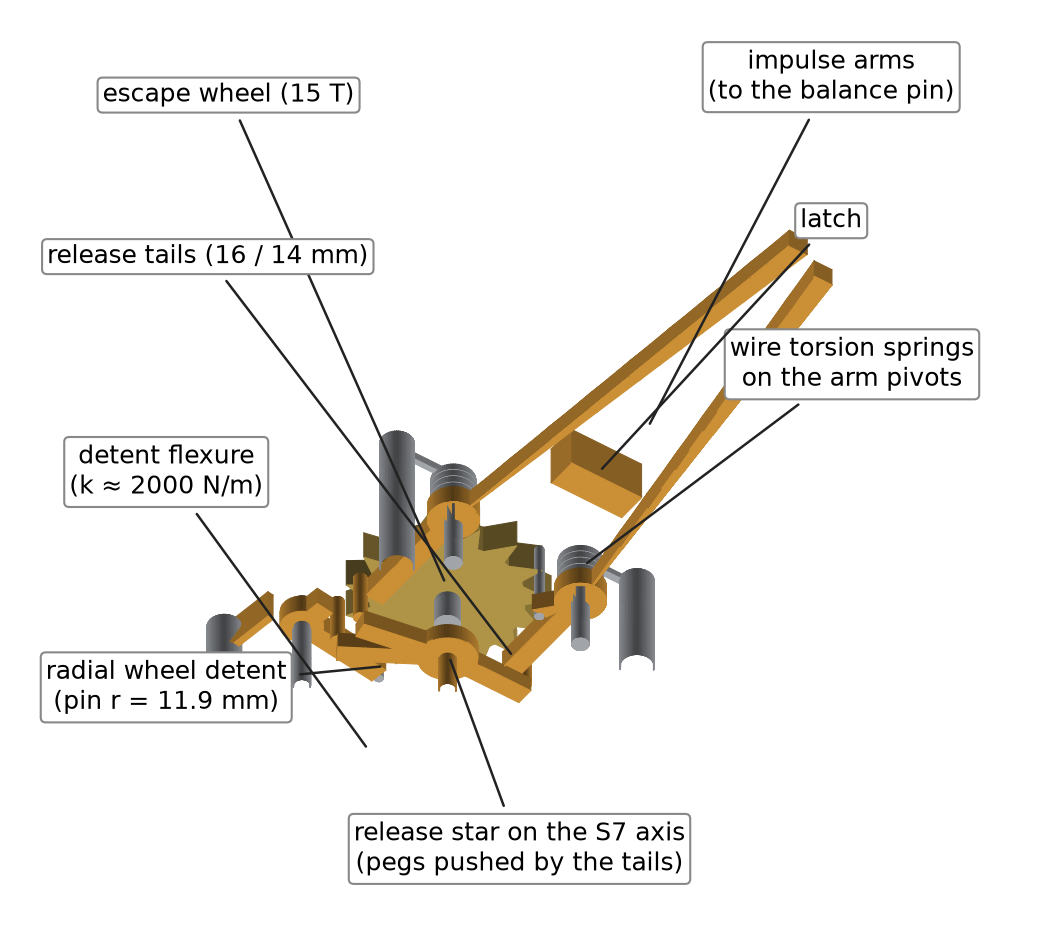
figures/renders/fig5_b.png
