Senekw/chronoflow/figures/renders/fig5_c.png

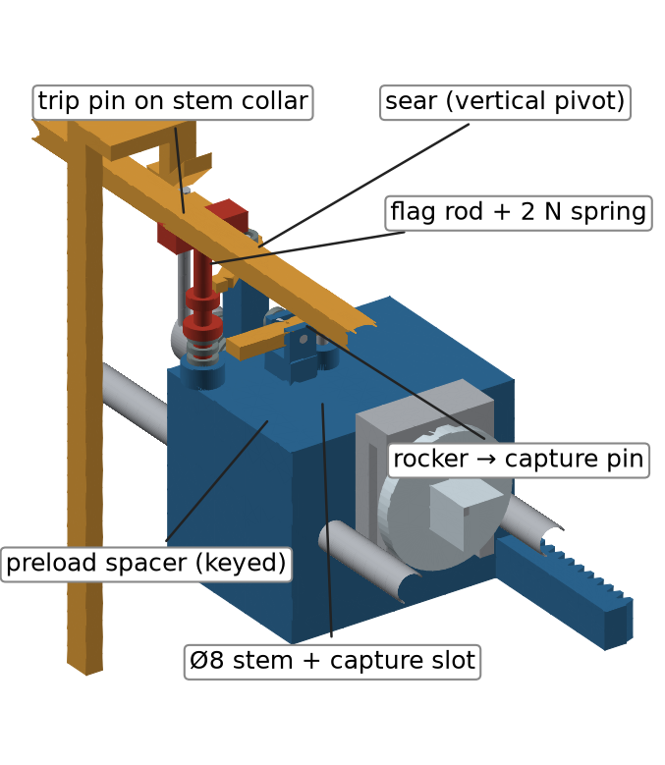
figures/renders/fig5_c.png
