Senekw/chronoflow/figures/renders/fig5_d.png

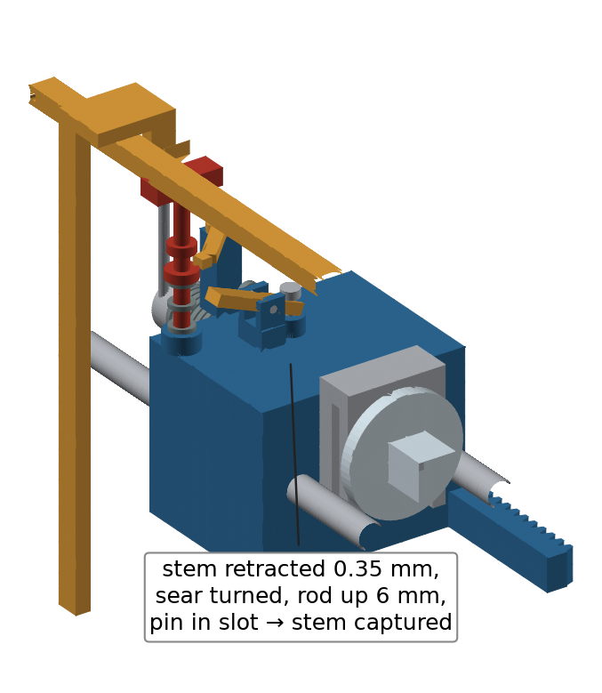
figures/renders/fig5_d.png
