Senekw/chronoflow/figures/renders/fig5_e.png

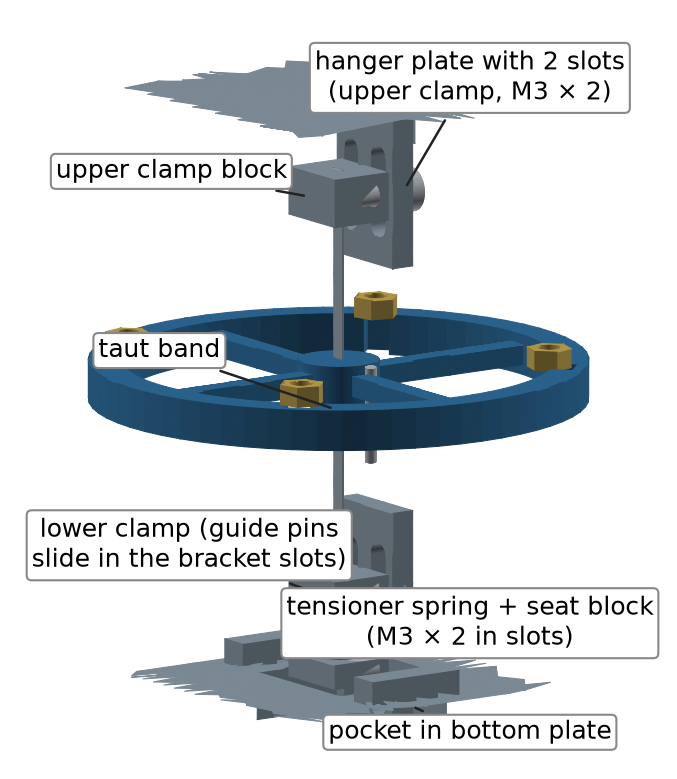
figures/renders/fig5_e.png
