Senekw/chronoflow/figures/renders/iso_overview.png

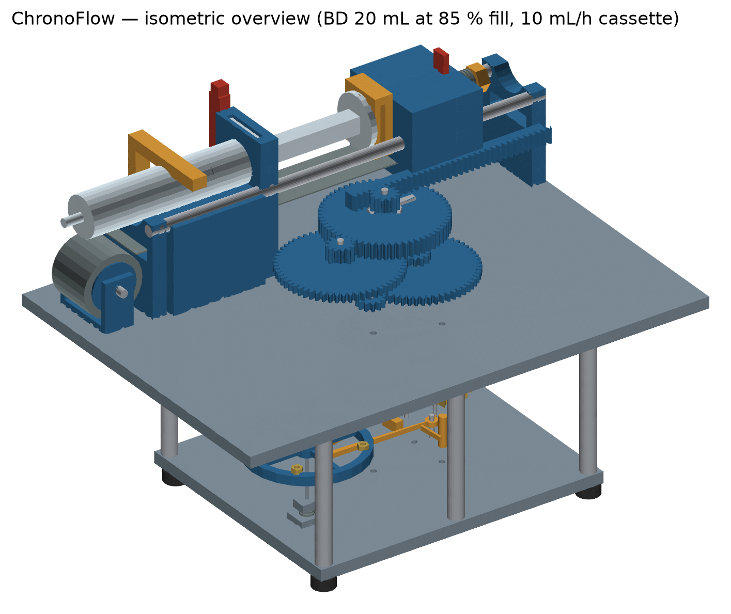
figures/renders/iso_overview.png
