Senekw/chronoflow/figures/renders/iso_rear.png

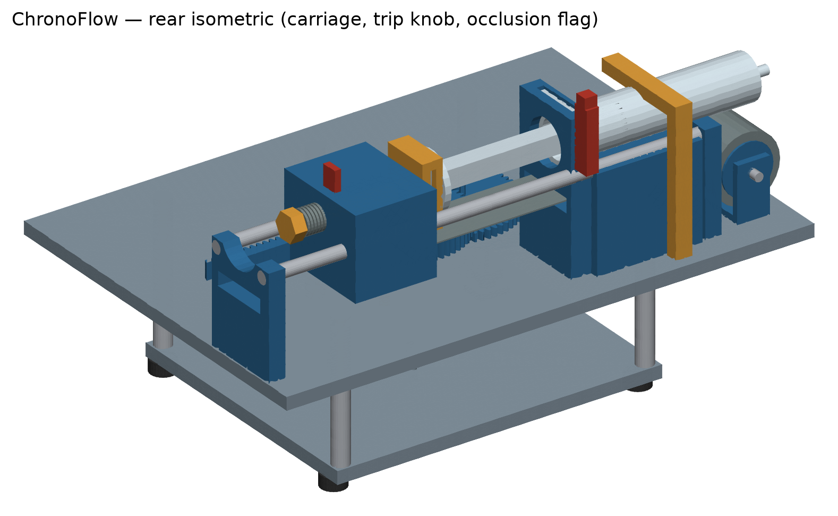
figures/renders/iso_rear.png
