Senekw/chronoflow/figures/renders/movement_front.png

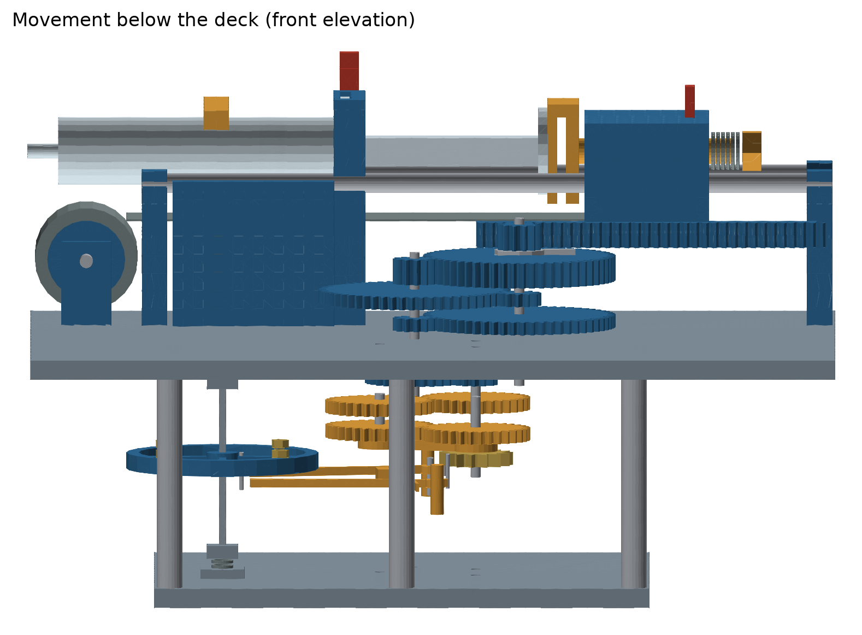
figures/renders/movement_front.png
