Senekw/chronoflow/figures/renders/movement_side.png

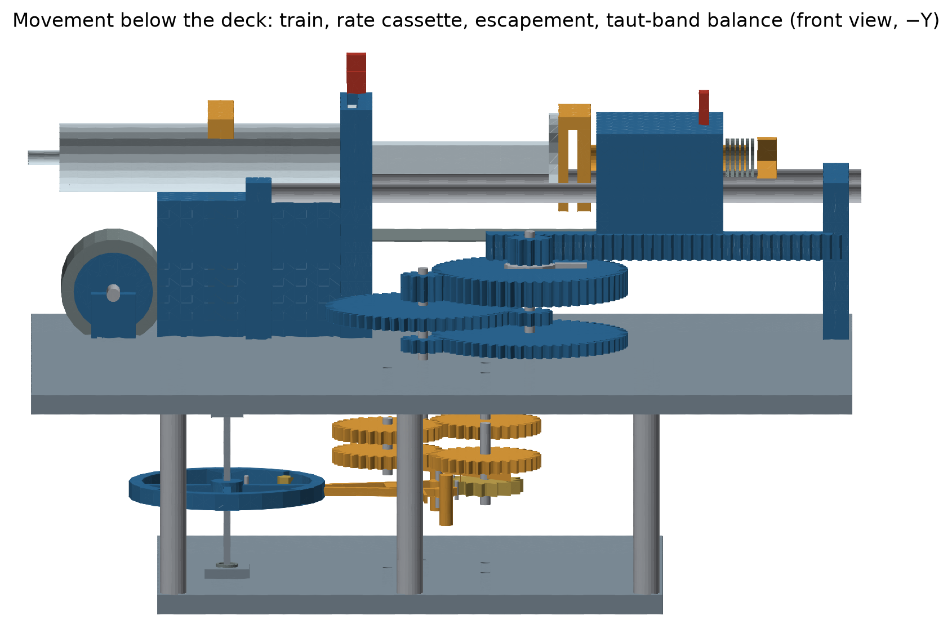
figures/renders/movement_side.png
