Senekw/chronoflow/figures/renders/top_view.png

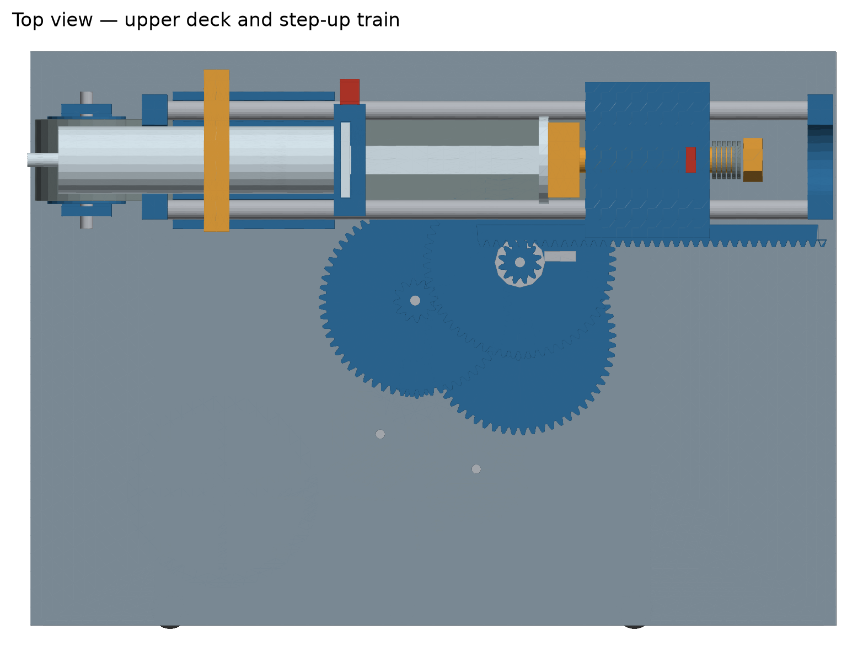
figures/renders/top_view.png
