Senekw/chronoflow/cad/stl/wheel_detent_flexure.stl

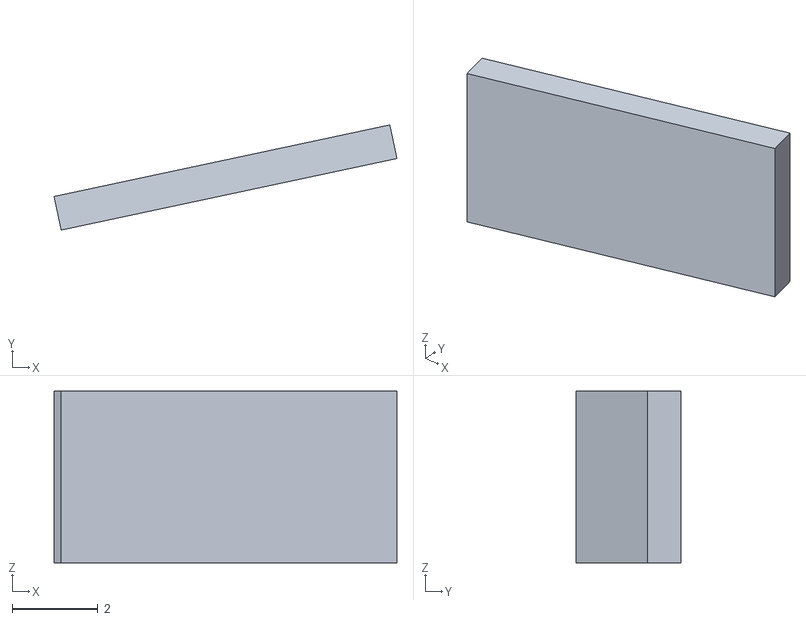
[picture p27: CAD file, 2026-10-06]
cad/stl/wheel_detent_flexure.stl
7.99 x 2.45 x 4.00
