Senekw/chronoflow/cad/stl_tripped/wheel_detent_post.stl

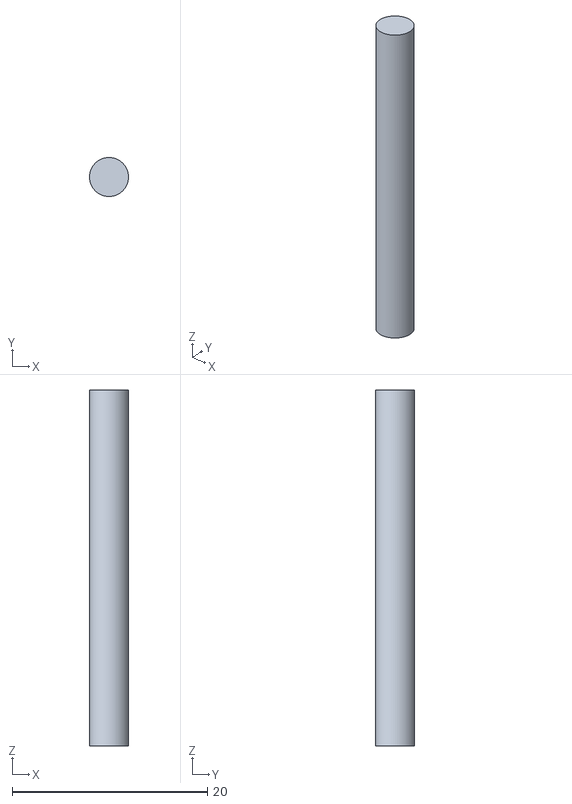
[picture p28: CAD file, 2026-10-06]
cad/stl_tripped/wheel_detent_post.stl
4.00 x 4.00 x 36.5
