Senekw/chronoflow/cad/stl/release_star_axle.stl

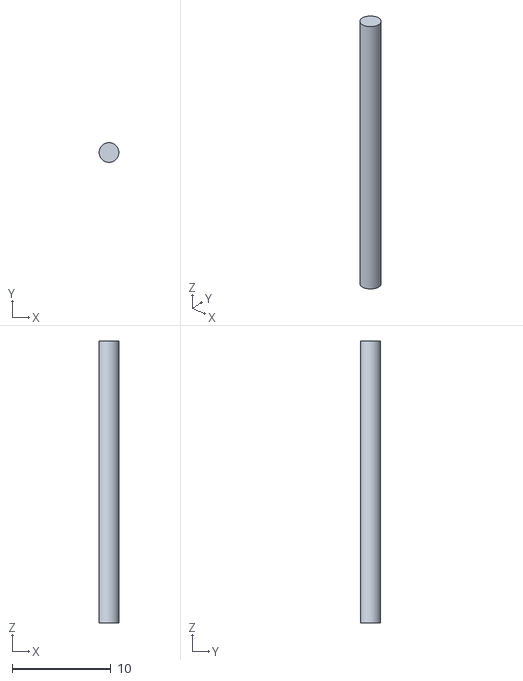
[picture p29: CAD file, 2026-10-06]
cad/stl/release_star_axle.stl
2.00 x 2.00 x 28.5
