Senekw/chronoflow/cad/stl_tripped/trip_reset_ramp.stl

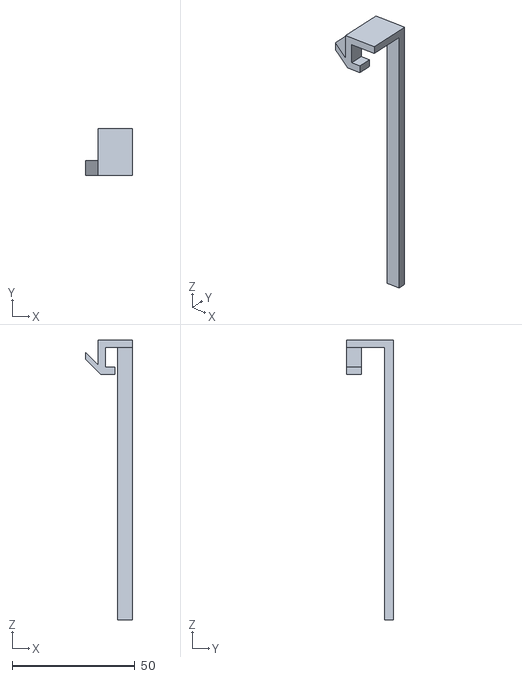
[picture p30: CAD file, 2026-10-06]
cad/stl_tripped/trip_reset_ramp.stl
19.0 x 19.0 x 114.0
