Senekw/chronoflow/cad/stl/wheel_detent.stl

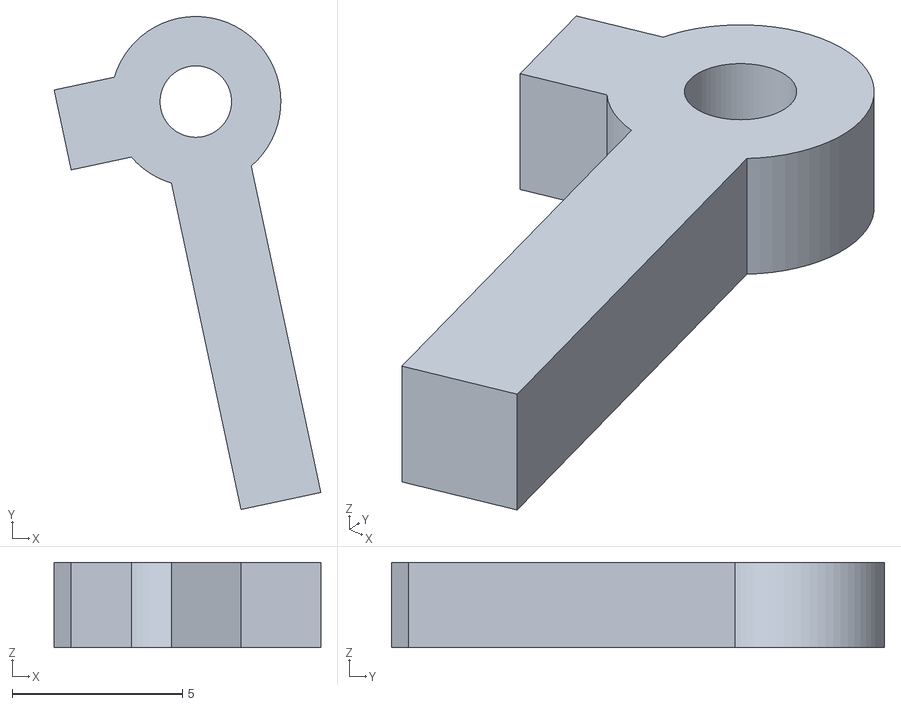
[picture p31: CAD file, 2026-10-06]
cad/stl/wheel_detent.stl
7.84 x 14.5 x 2.50
