Senekw/chronoflow/cad/stl_tripped/release_star_pegs.stl

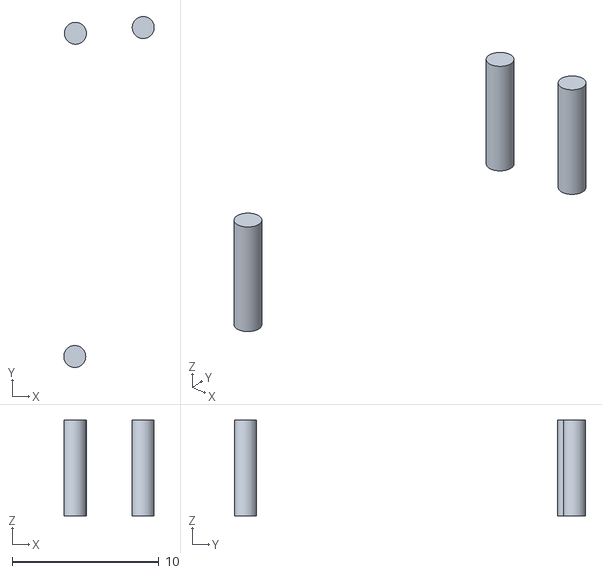
[picture p32: CAD file, 2026-10-06]
cad/stl_tripped/release_star_pegs.stl
6.16 x 23.9 x 6.50
