Senekw/chronoflow/cad/stl/impulse_arm_B.stl

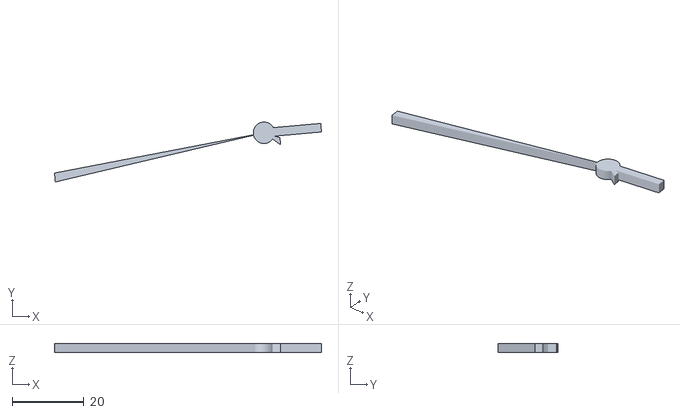
[picture p33: CAD file, 2026-10-06]
cad/stl/impulse_arm_B.stl
74.5 x 16.7 x 2.50
