Senekw/chronoflow/cad/stl_tripped/release_star.stl

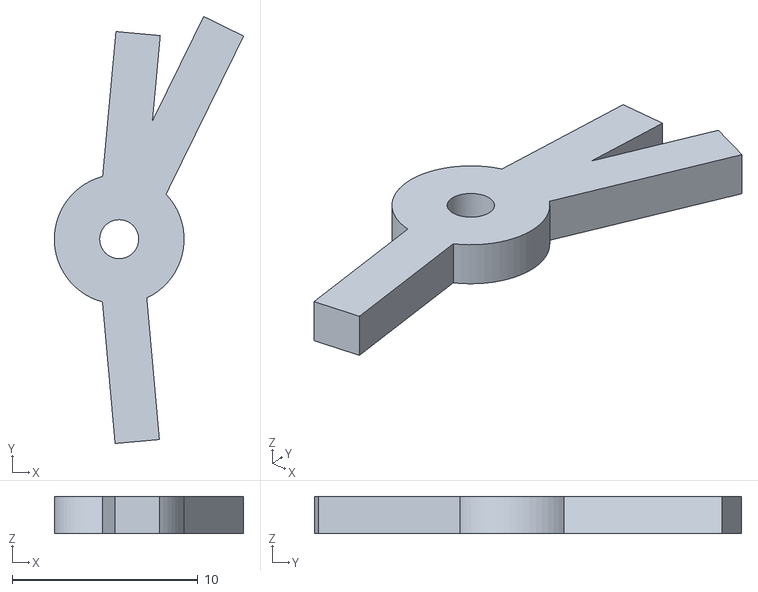
[picture p34: CAD file, 2026-10-06]
cad/stl_tripped/release_star.stl
10.2 x 23.0 x 2.00
