Senekw/chronoflow/cad/stl/flag_rod_occlusion_flag.stl

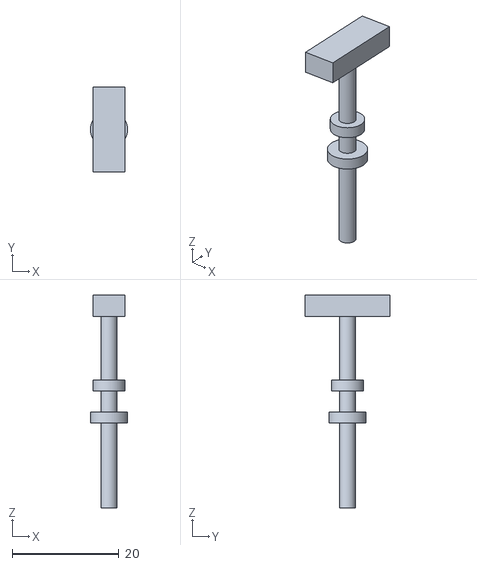
[picture p35: CAD file, 2026-10-06]
cad/stl/flag_rod_occlusion_flag.stl
7.00 x 16.0 x 40.0
