Senekw/chronoflow/cad/stl_tripped/impulse_arm_B_torsion_spring.stl

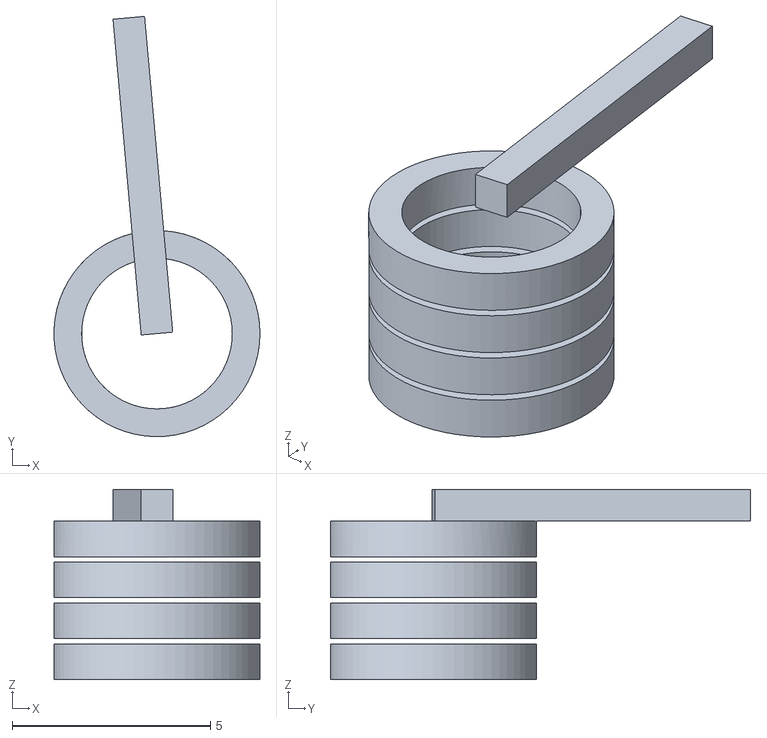
[picture p36: CAD file, 2026-10-06]
cad/stl_tripped/impulse_arm_B_torsion_spring.stl
5.20 x 10.6 x 4.80
