Senekw/chronoflow/cad/stl/wheel_detent_pin.stl

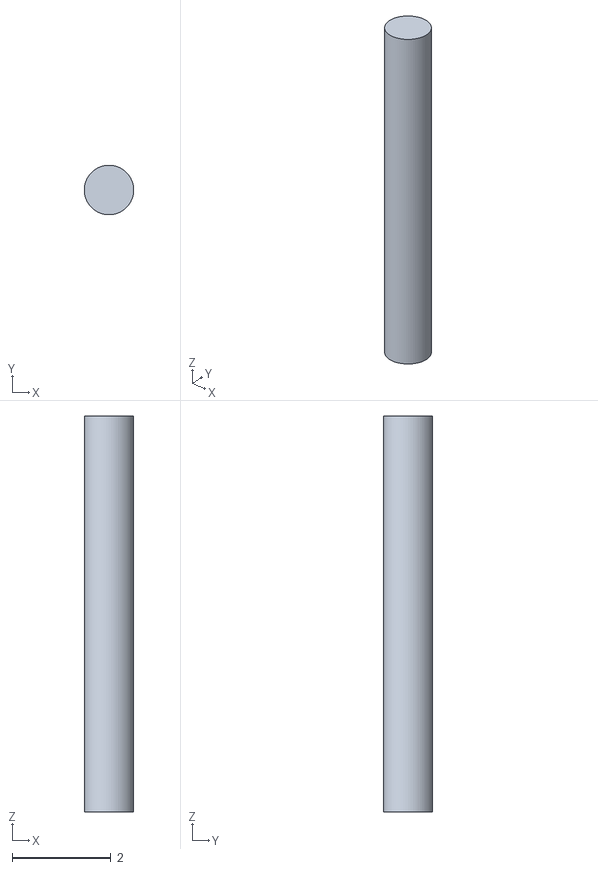
[picture p37: CAD file, 2026-10-06]
cad/stl/wheel_detent_pin.stl
0.999 x 1 x 8.00
