Senekw/chronoflow/cad/stl/impulse_arm_A.stl

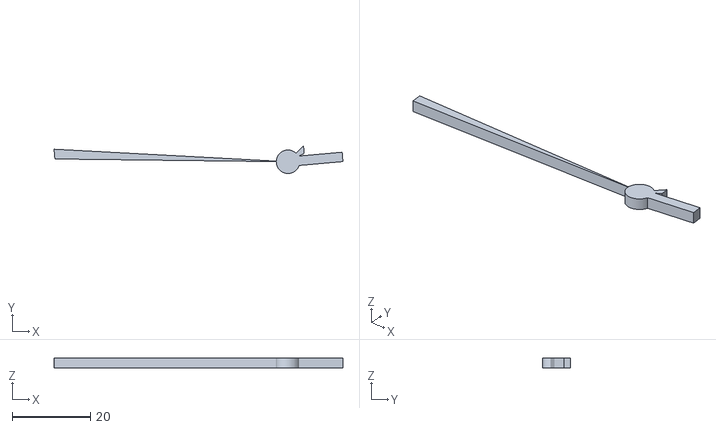
[picture p38: CAD file, 2026-10-06]
cad/stl/impulse_arm_A.stl
73.8 x 7.15 x 2.50
