Senekw/chronoflow/cad/stl_tripped/impulse_arm_A_post.stl

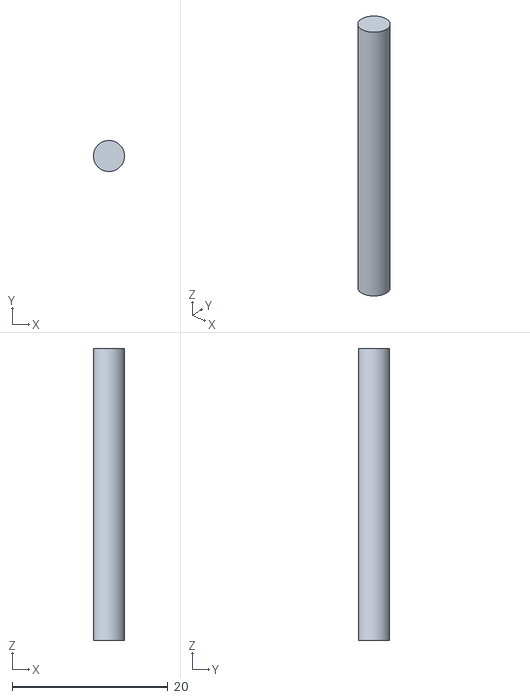
[picture p39: CAD file, 2026-10-06]
cad/stl_tripped/impulse_arm_A_post.stl
4.00 x 4.00 x 37.5
