Senekw/chronoflow/cad/stl_tripped/wheel_detent_pivot_pin.stl

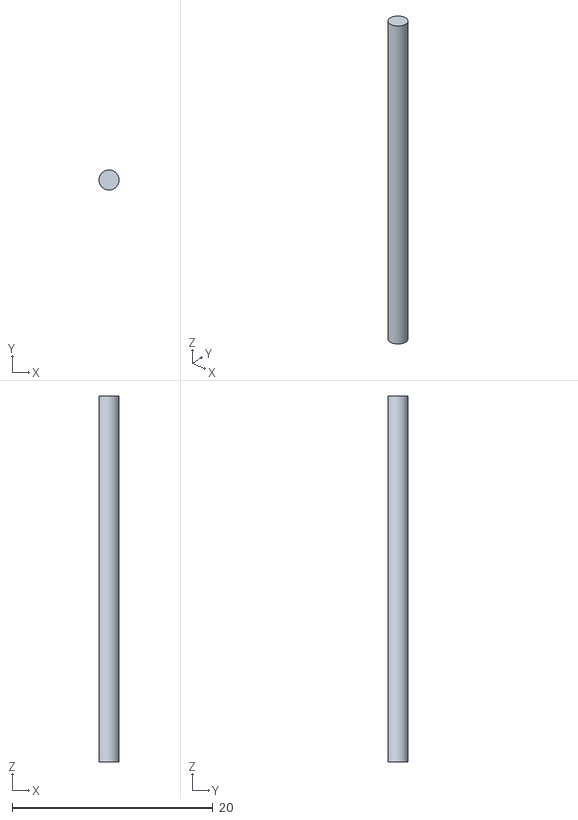
[picture p40: CAD file, 2026-10-06]
cad/stl_tripped/wheel_detent_pivot_pin.stl
2.00 x 2.00 x 36.5
