Senekw/chronoflow/cad/stl/impulse_arm_B_post.stl

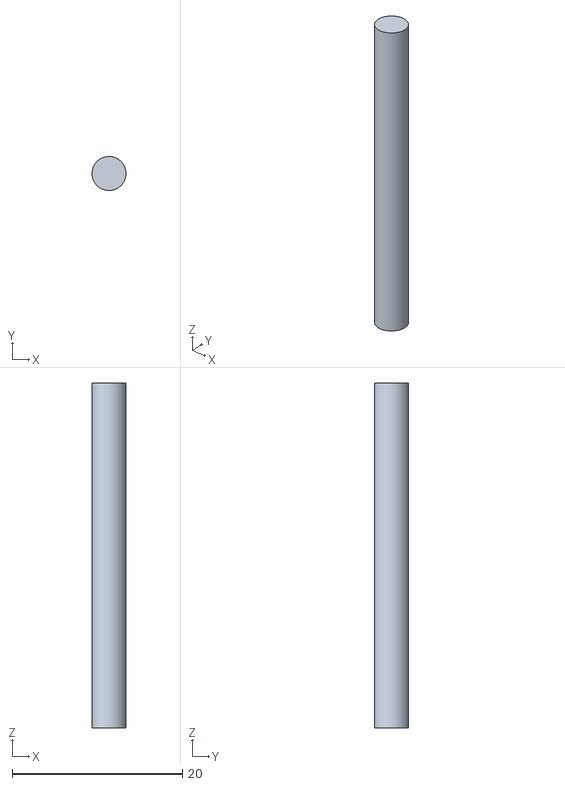
[picture p41: CAD file, 2026-10-06]
cad/stl/impulse_arm_B_post.stl
4.00 x 4.00 x 40.5
