Senekw/chronoflow/cad/stl/cassette_g1_33T.stl

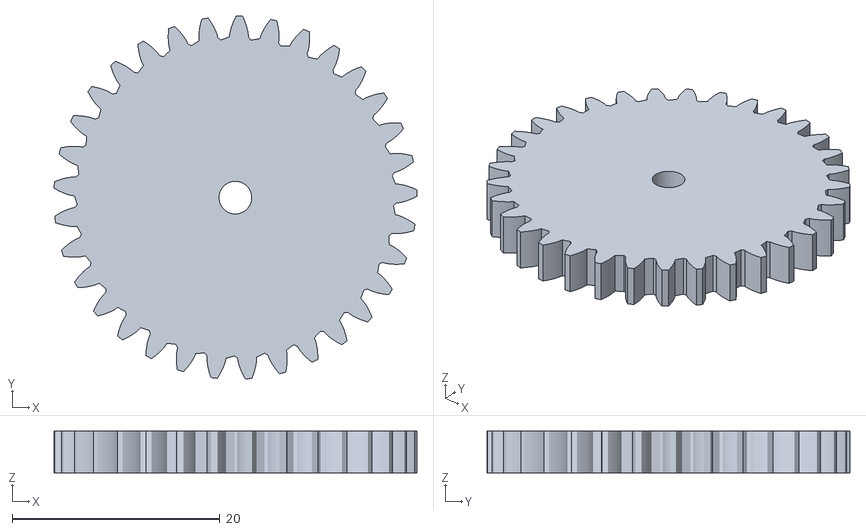
[picture p42: CAD file, 2026-10-03]
cad/stl/cassette_g1_33T.stl
35.0 x 35.0 x 4.00
