Senekw/chronoflow/cad/stl_tripped/W3_60T.stl

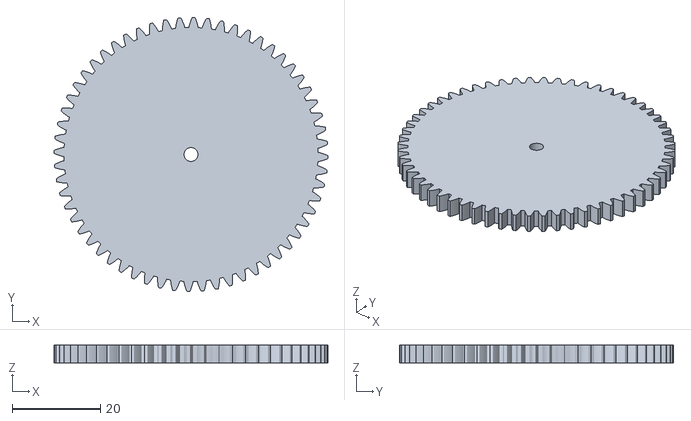
[picture p43: CAD file, 2026-10-03]
cad/stl_tripped/W3_60T.stl
62.0 x 62.0 x 4.00
