Senekw/chronoflow/cad/stl/balance_tensioner_seat.stl

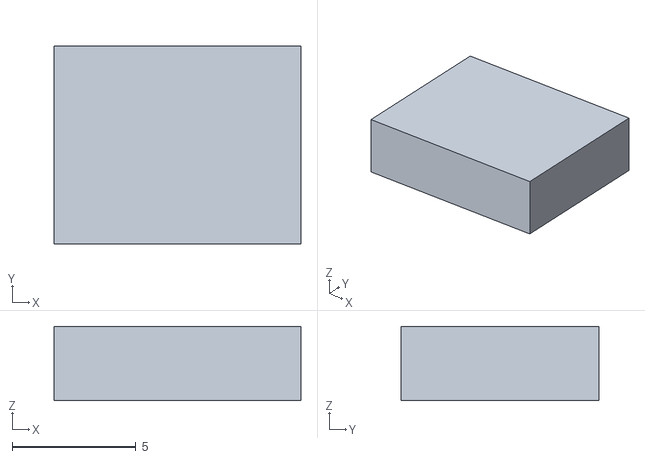
[picture p44: CAD file, 2026-10-03]
cad/stl/balance_tensioner_seat.stl
10.0 x 8.00 x 3.00
