Senekw/chronoflow/cad/stl_tripped/rocker_boss.stl

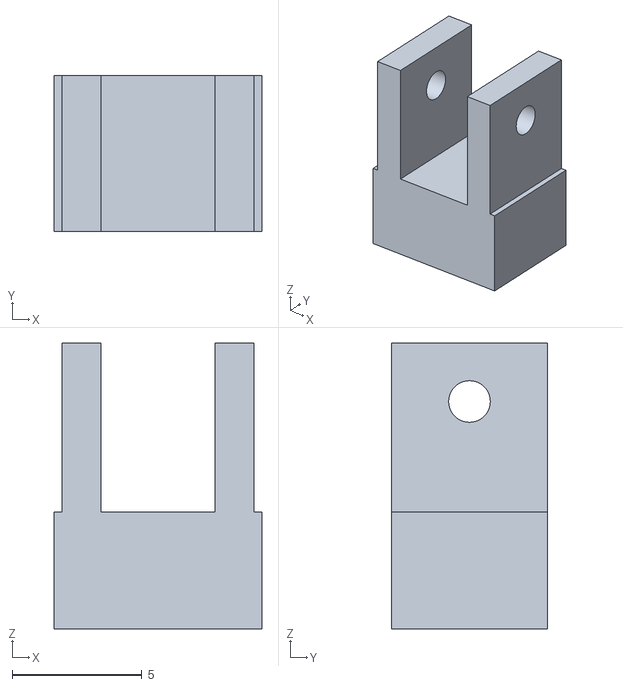
[picture p45: CAD file, 2026-10-03]
cad/stl_tripped/rocker_boss.stl
8.00 x 6.00 x 11.0
