Senekw/chronoflow/cad/stl/trip_rail_cranks.stl

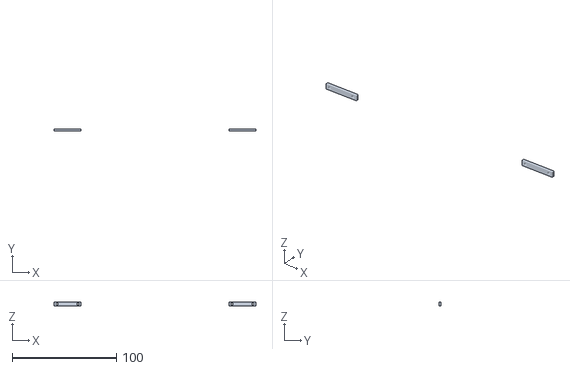
[picture p46: CAD file, 2026-10-03]
cad/stl/trip_rail_cranks.stl
194.0 x 2.00 x 4.00
