Senekw/chronoflow/cad/stl/P3_12T.stl

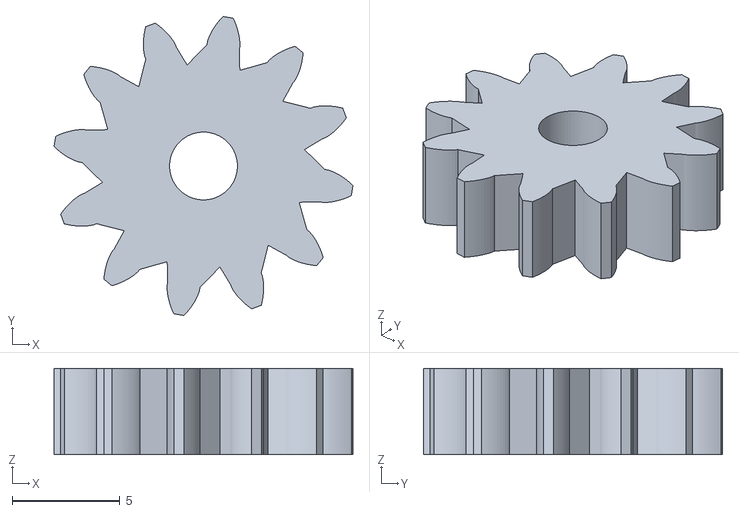
[picture p47: CAD file, 2026-10-03]
cad/stl/P3_12T.stl
13.9 x 13.9 x 4.00
