Senekw/chronoflow/cad/stl_tripped/sear_pivot_pin.stl

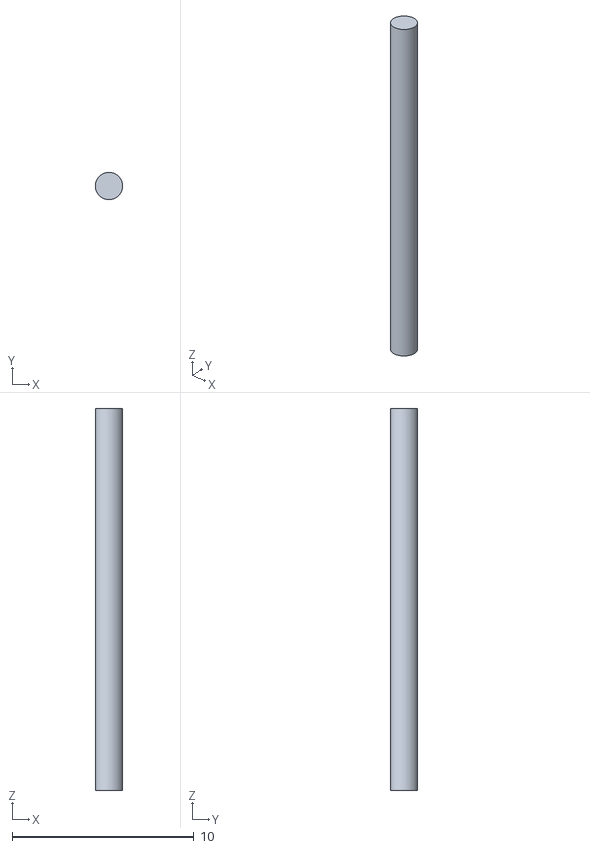
[picture p48: CAD file, 2026-10-03]
cad/stl_tripped/sear_pivot_pin.stl
1.50 x 1.50 x 21.0
