Senekw/chronoflow/cad/stl/occlusion_trip_spring.stl

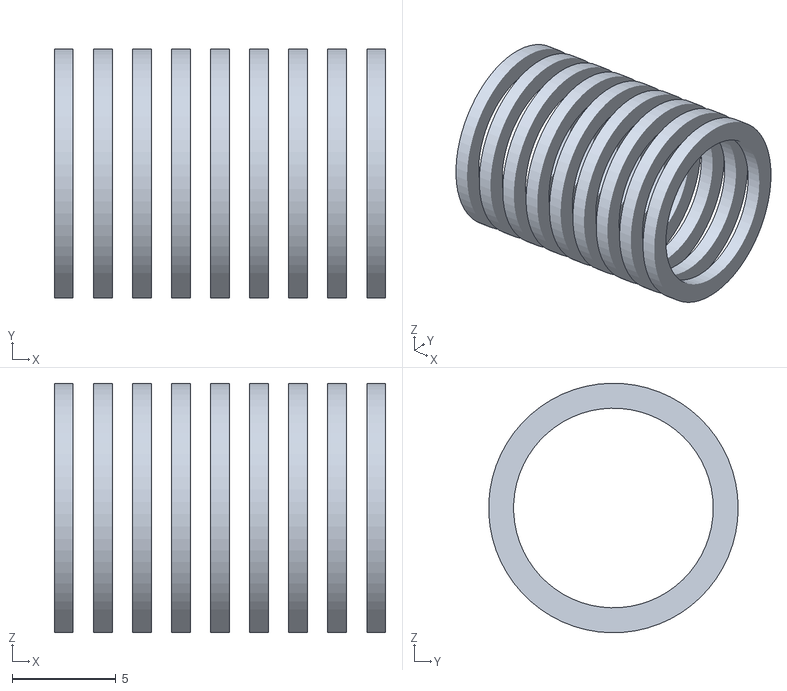
[picture p49: CAD file, 2026-10-03]
cad/stl/occlusion_trip_spring.stl
15.9 x 12.0 x 12.0
