Senekw/chronoflow/cad/stl_tripped/trip_rail.stl

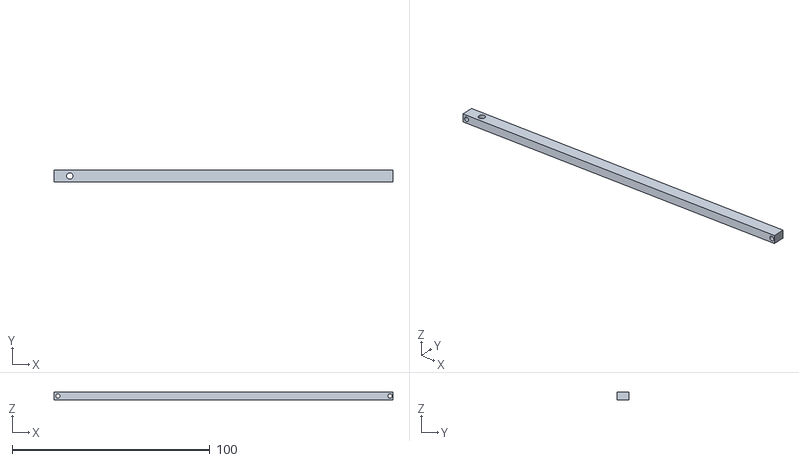
[picture p50: CAD file, 2026-10-03]
cad/stl_tripped/trip_rail.stl
171.5 x 6.00 x 4.00
