Senekw/chronoflow/cad/stl/sear_boss.stl

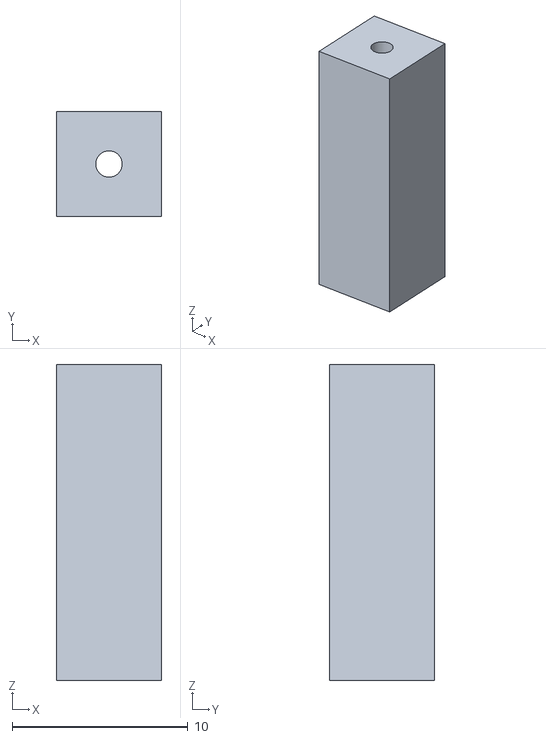
[picture p51: CAD file, 2026-10-03]
cad/stl/sear_boss.stl
6.00 x 6.00 x 18.0
