Senekw/chronoflow/cad/stl_tripped/balance_tensioner_guide.stl

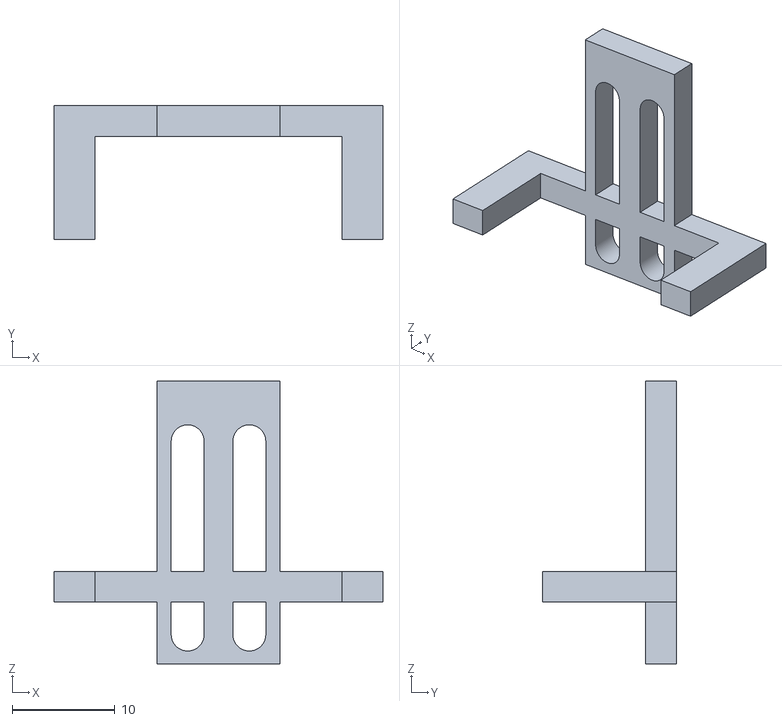
[picture p52: CAD file, 2026-10-03]
cad/stl_tripped/balance_tensioner_guide.stl
32.0 x 13.0 x 27.5
