Senekw/chronoflow/cad/stl_tripped/sear_return_spring.stl

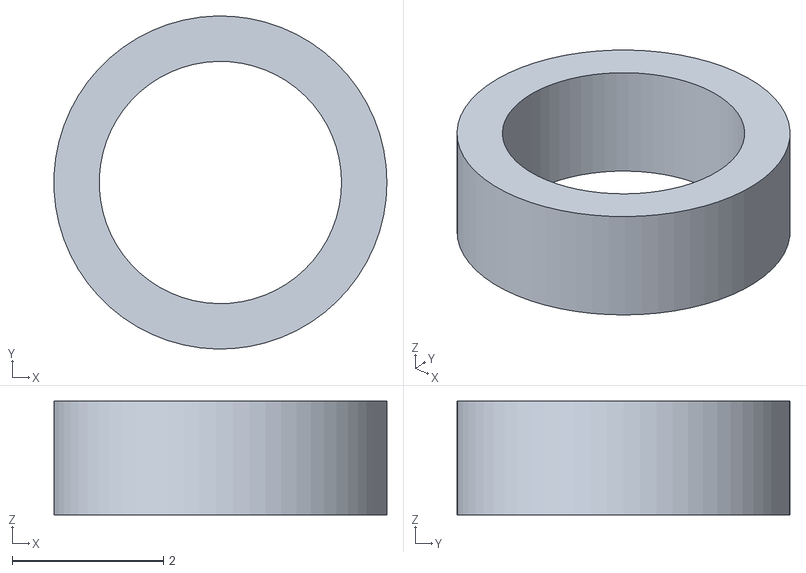
[picture p53: CAD file, 2026-10-03]
cad/stl_tripped/sear_return_spring.stl
4.40 x 4.40 x 1.50
