Senekw/chronoflow/cad/stl_tripped/trip_rail_posts.stl

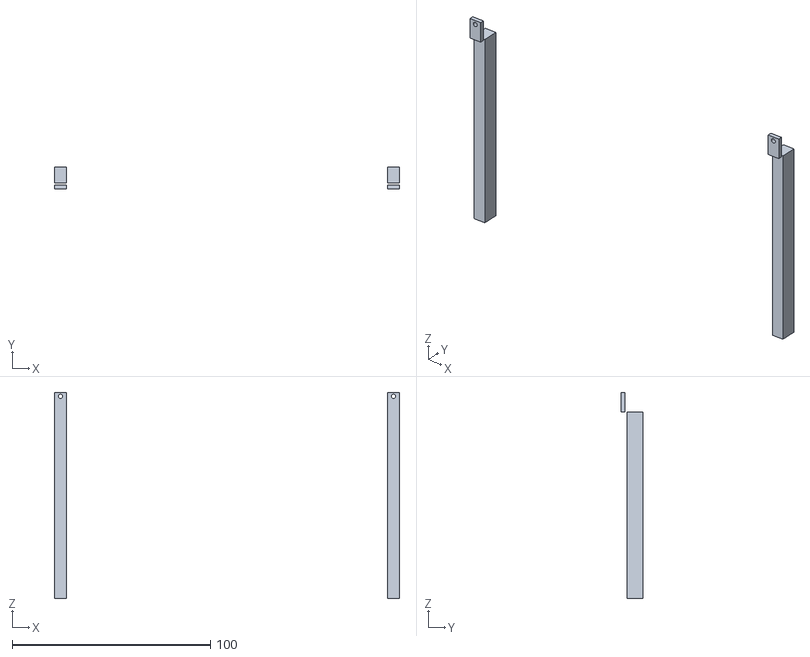
[picture p54: CAD file, 2026-10-03]
cad/stl_tripped/trip_rail_posts.stl
174.0 x 11.0 x 104.0
