Senekw/chronoflow/cad/stl/escape_wheel_15T.stl

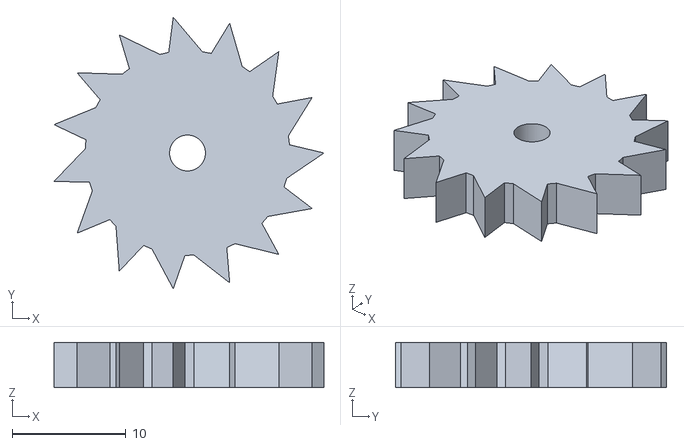
[picture p55: CAD file, 2026-10-03]
cad/stl/escape_wheel_15T.stl
23.7 x 23.9 x 4.00
