Senekw/chronoflow/cad/stl_tripped/stem_capture_pin.stl

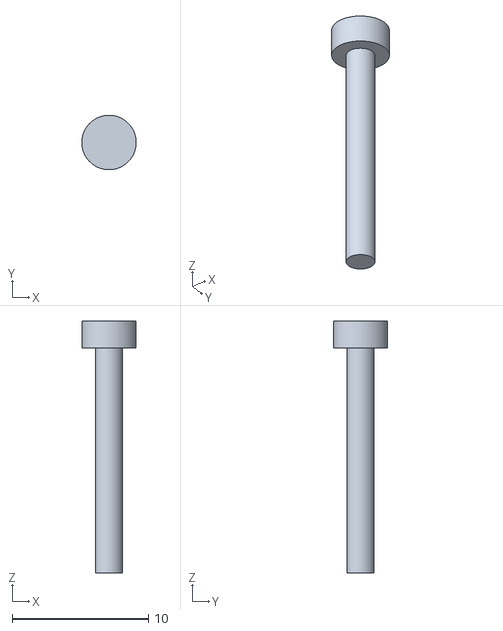
[picture p56: CAD file, 2026-10-03]
cad/stl_tripped/stem_capture_pin.stl
4.00 x 4.00 x 18.5
