Senekw/chronoflow/cad/stl_tripped/rocker_pivot_pin.stl

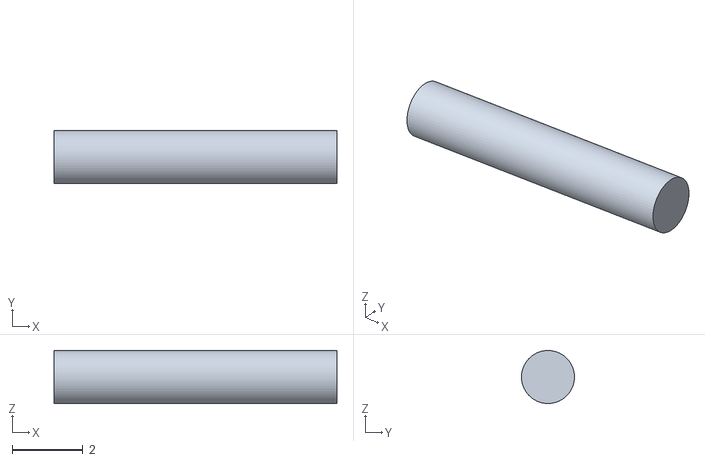
[picture p57: CAD file, 2026-10-03]
cad/stl_tripped/rocker_pivot_pin.stl
8.00 x 1.50 x 1.50
