Senekw/chronoflow/cad/stl_tripped/drop_rod_balance_stop_fork.stl

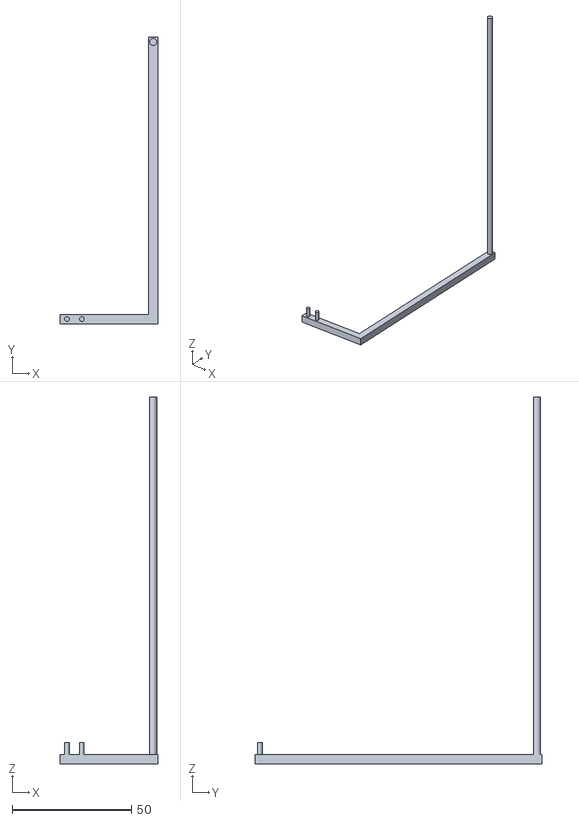
[picture p58: CAD file, 2026-10-03]
cad/stl_tripped/drop_rod_balance_stop_fork.stl
41.1 x 120.3 x 154.0
