Senekw/chronoflow/cad/stl/balance_lower_clamp.stl

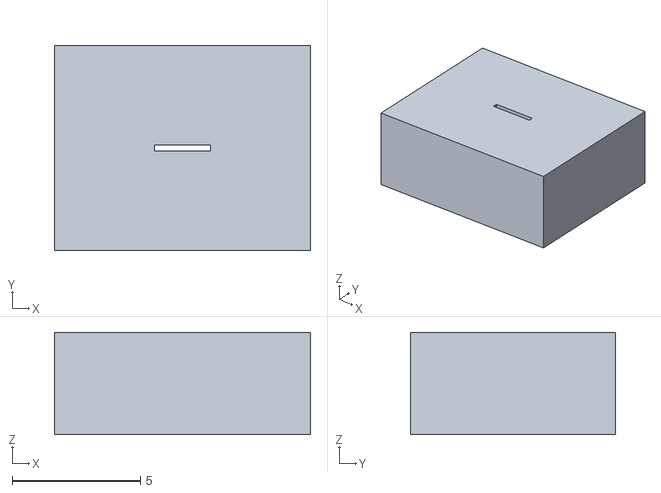
[picture p59: CAD file, 2026-10-03]
cad/stl/balance_lower_clamp.stl
10.0 x 8.00 x 4.00
