Senekw/chronoflow/cad/stl_tripped/balance_upper_post.stl

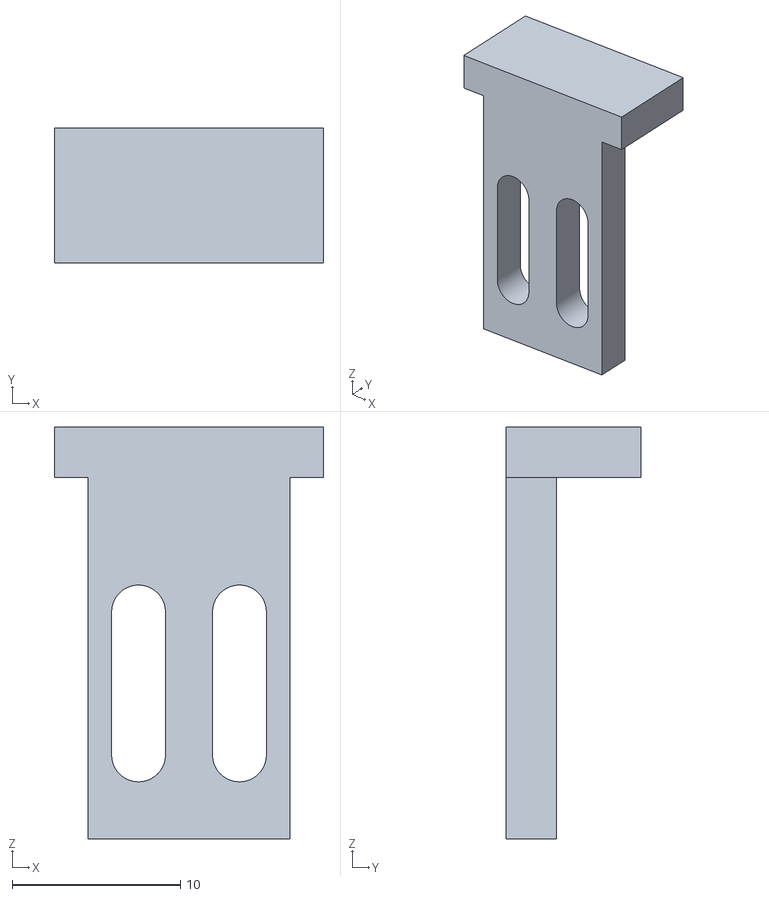
[picture p60: CAD file, 2026-10-03]
cad/stl_tripped/balance_upper_post.stl
16.0 x 8.00 x 24.5
