Senekw/chronoflow/cad/stl_tripped/trip_rail_cranks.stl

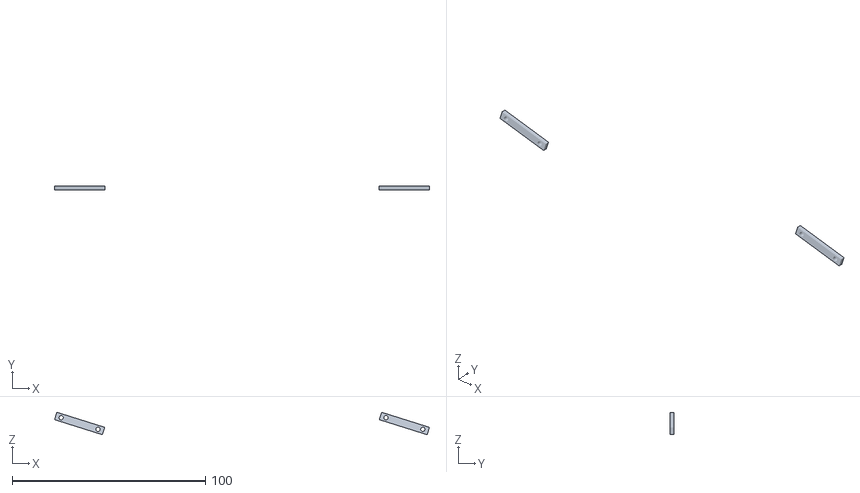
[picture p61: CAD file, 2026-10-03]
cad/stl_tripped/trip_rail_cranks.stl
194.0 x 2.00 x 11.6
