Senekw/chronoflow/cad/stl_tripped/rocker_torsion_spring.stl

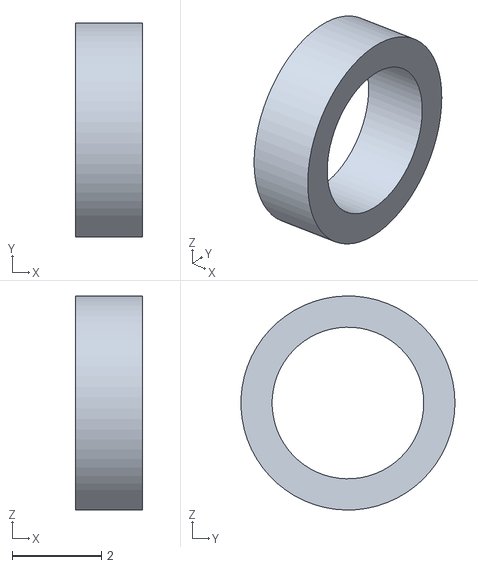
[picture p62: CAD file, 2026-10-03]
cad/stl_tripped/rocker_torsion_spring.stl
1.50 x 4.80 x 4.80
