Senekw/chronoflow/cad/stl/flag_rod_guide.stl

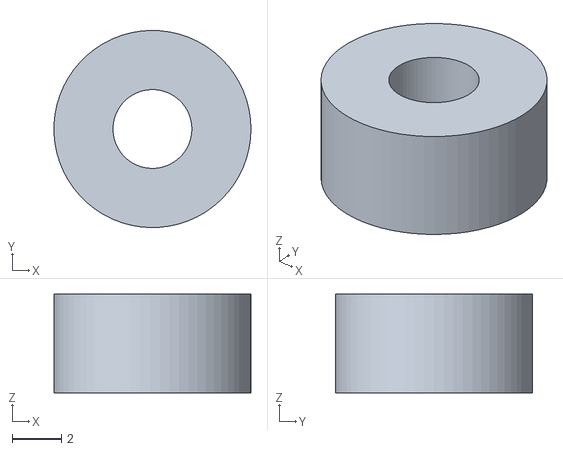
[picture p63: CAD file, 2026-10-03]
cad/stl/flag_rod_guide.stl
8.00 x 8.00 x 4.00
