Senekw/chronoflow/cad/stl_tripped/balance_tensioner.stl

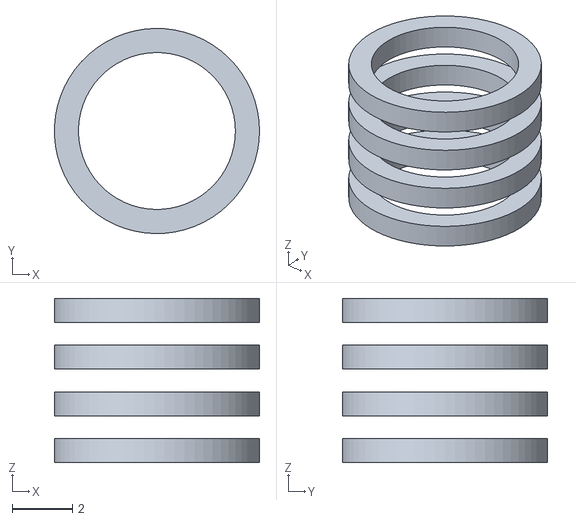
[picture p64: CAD file, 2026-10-03]
cad/stl_tripped/balance_tensioner.stl
6.80 x 6.80 x 5.45
