Senekw/chronoflow/cad/stl/W1_60T.stl

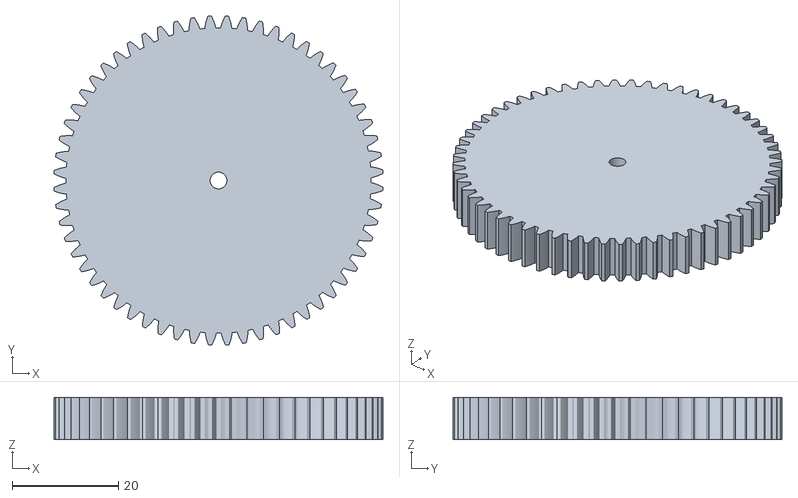
[picture p65: CAD file, 2026-10-03]
cad/stl/W1_60T.stl
61.9 x 61.9 x 8.00
