Senekw/chronoflow/cad/stl_tripped/trip_rail_pivot_pins.stl

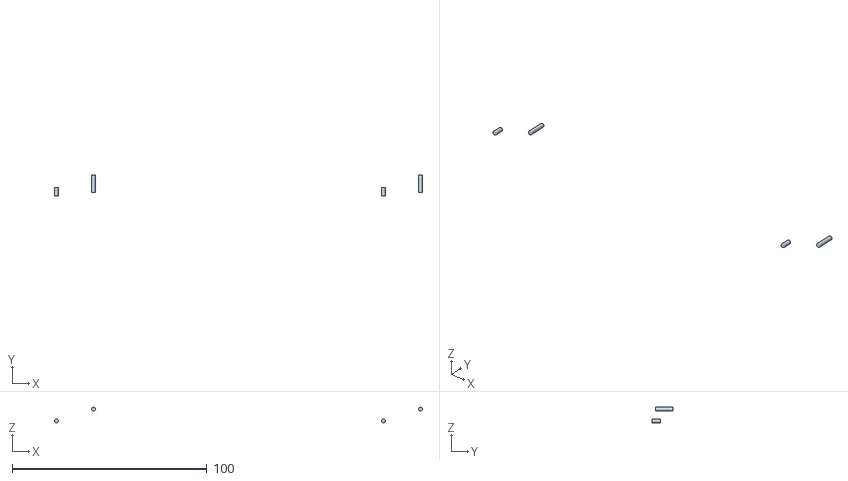
[picture p66: CAD file, 2026-10-03]
cad/stl_tripped/trip_rail_pivot_pins.stl
189.1 x 11.0 x 8.00
