Senekw/chronoflow/cad/stl/P1_12T.stl

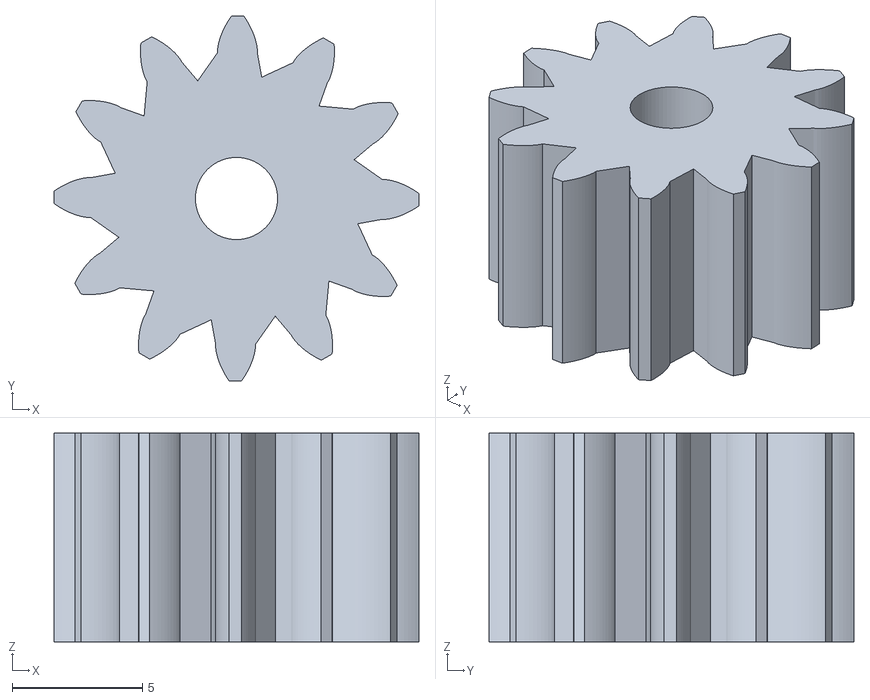
[picture p67: CAD file, 2026-10-03]
cad/stl/P1_12T.stl
14.0 x 14.0 x 8.00
