Senekw/chronoflow/cad/stl/deck_plate.stl

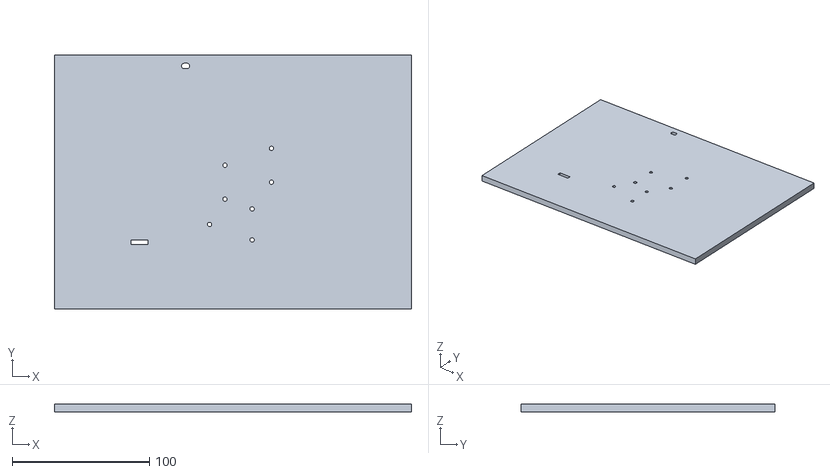
[picture p68: CAD file, 2026-10-03]
cad/stl/deck_plate.stl
260.0 x 185.0 x 6.00
