Senekw/chronoflow/cad/stl/bottom_plate.stl

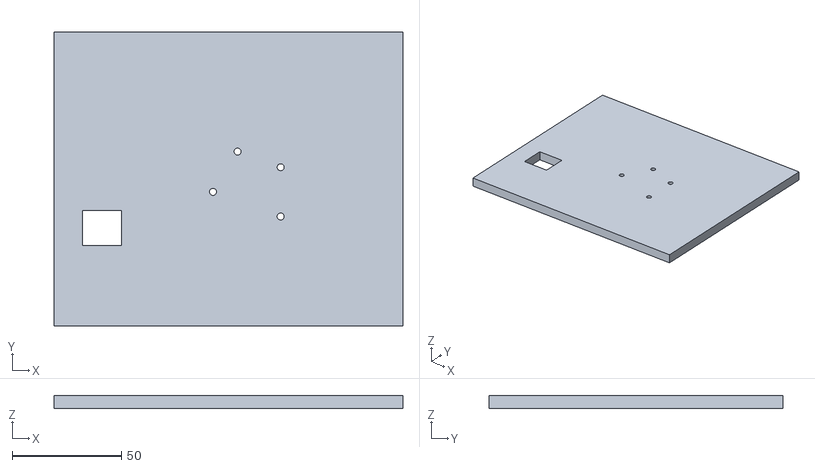
[picture p69: CAD file, 2026-10-03]
cad/stl/bottom_plate.stl
160.0 x 135.0 x 6.00
