Senekw/chronoflow/cad/stl/trip_sear.stl

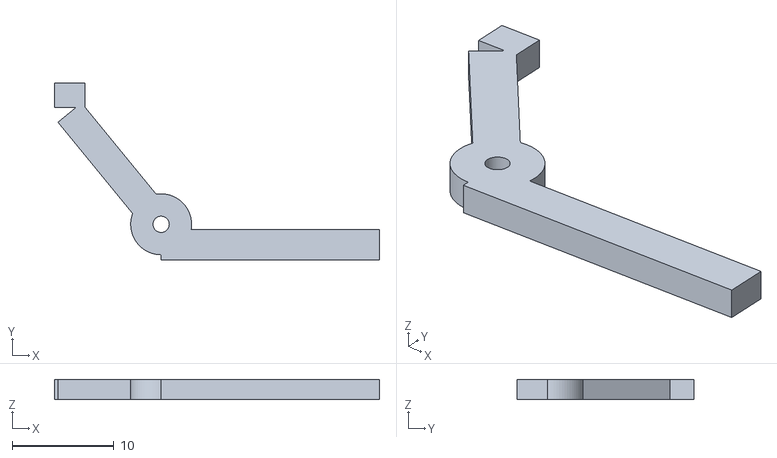
[picture p70: CAD file, 2026-10-03]
cad/stl/trip_sear.stl
32.0 x 17.4 x 2.00
