Senekw/chronoflow/cad/stl/carriage_rack.stl

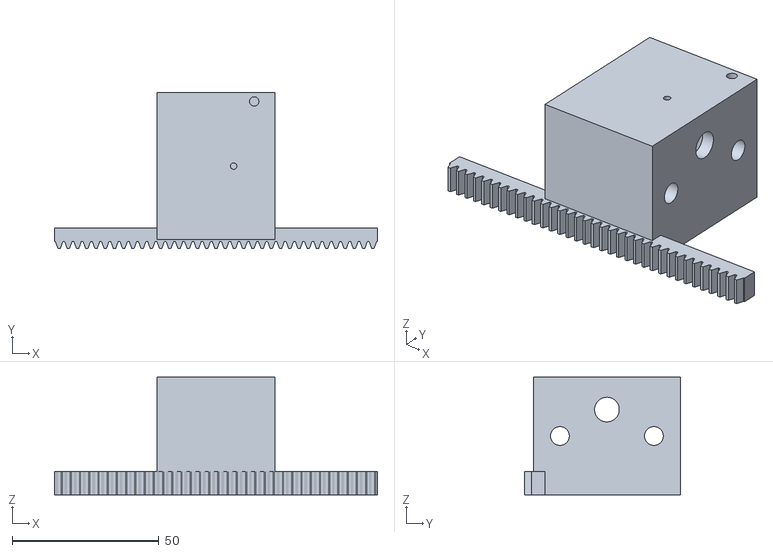
[picture p71: CAD file, 2026-10-03]
cad/stl/carriage_rack.stl
110.0 x 53.0 x 40.0
