Senekw/chronoflow/cad/stl/trip_preload_spacer_4_5_mm.stl

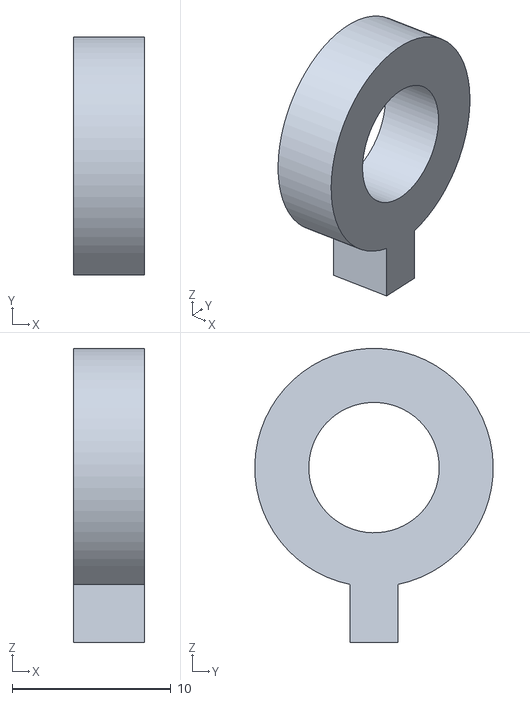
[picture p72: CAD file, 2026-10-03]
cad/stl/trip_preload_spacer_4_5_mm.stl
4.48 x 15.0 x 18.5
