Senekw/chronoflow/cad/stl_tripped/flag_spring.stl

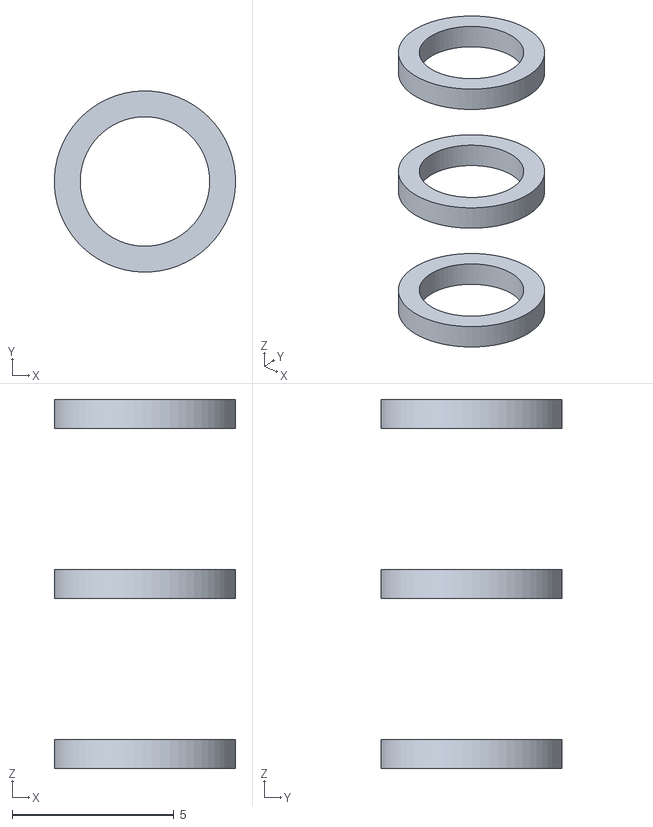
[picture p73: CAD file, 2026-10-03]
cad/stl_tripped/flag_spring.stl
5.60 x 5.60 x 11.4
