Senekw/chronoflow/cad/stl_tripped/plunger.stl

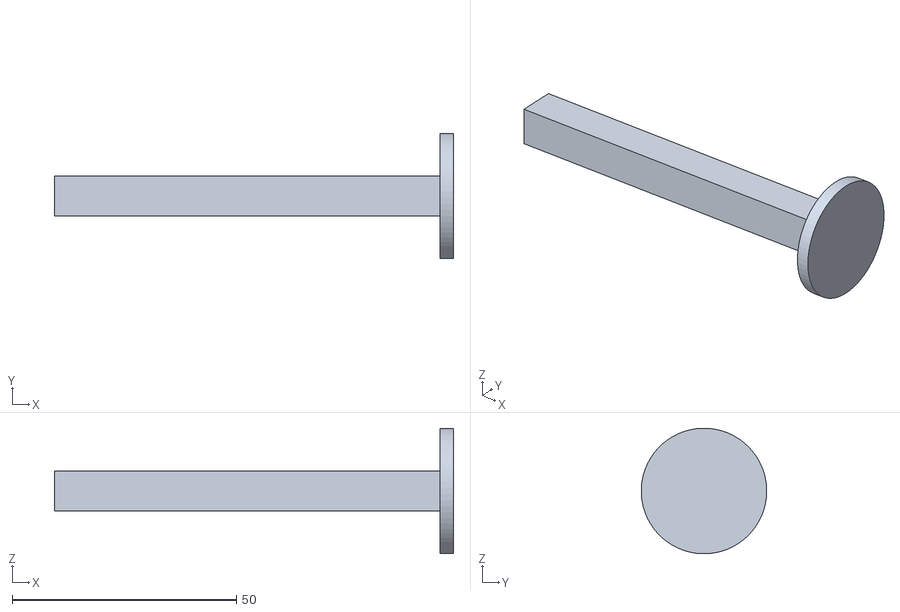
[picture p74: CAD file, 2026-10-03]
cad/stl_tripped/plunger.stl
89.0 x 28.0 x 28.0
