Senekw/chronoflow/cad/stl_tripped/spring_tape.stl

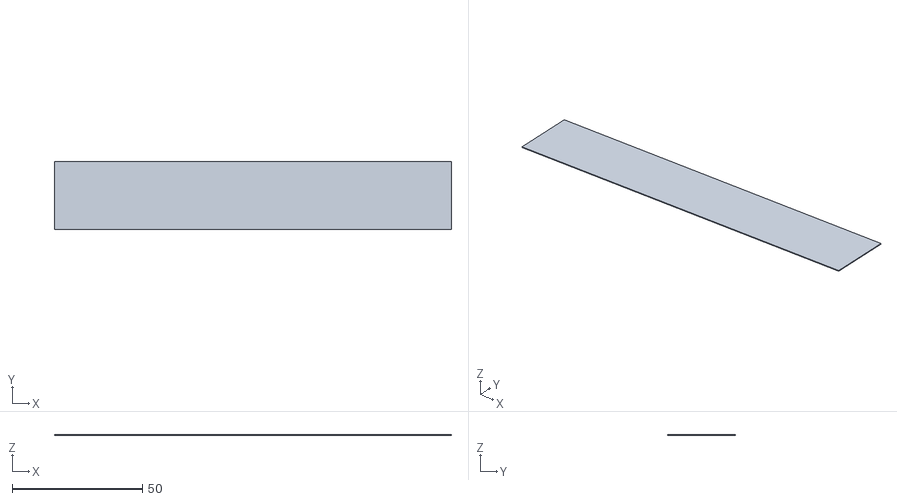
[picture p75: CAD file, 2026-10-03]
cad/stl_tripped/spring_tape.stl
152.1 x 26.0 x 0.3
