Senekw/chronoflow/cad/stl/syringe_cradle_flange_latch.stl

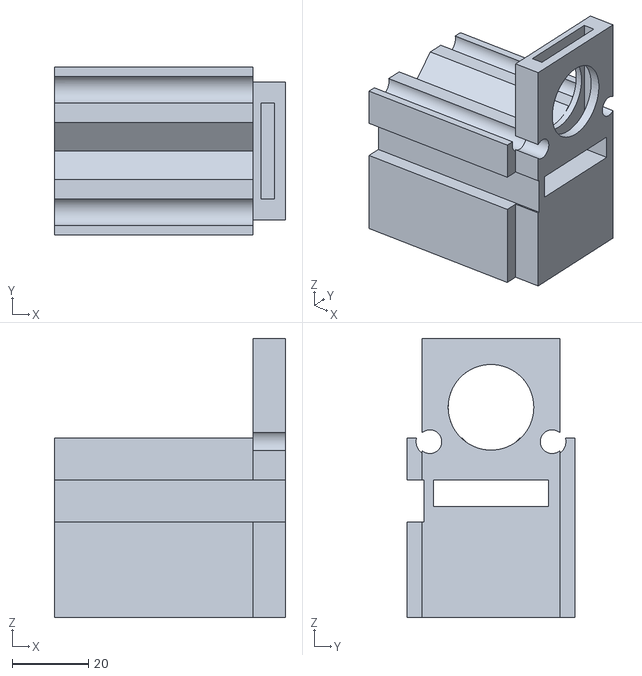
[picture p76: CAD file, 2026-10-03]
cad/stl/syringe_cradle_flange_latch.stl
60.5 x 44.0 x 73.0
