Senekw/chronoflow/cad/stl/pusher_head_trip_stem.stl

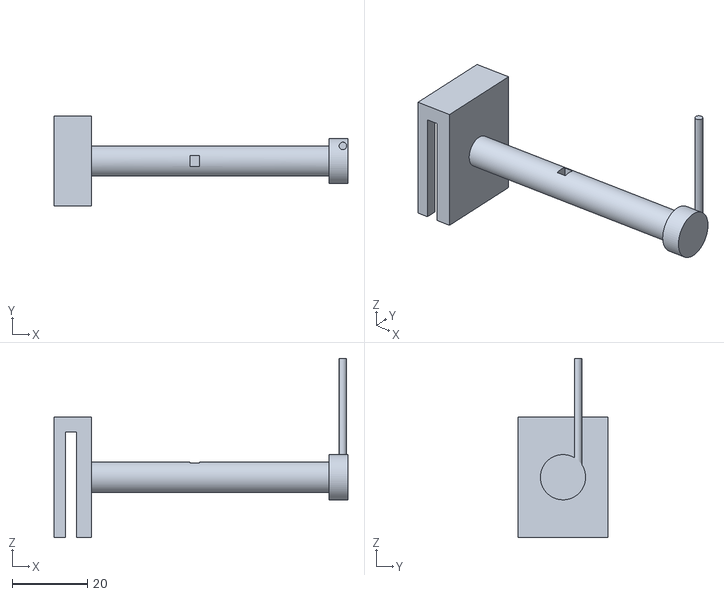
[picture p77: CAD file, 2026-10-03]
cad/stl/pusher_head_trip_stem.stl
78.0 x 24.0 x 47.5
