Senekw/chronoflow/cad/stl_tripped/balance_upper_clamp.stl

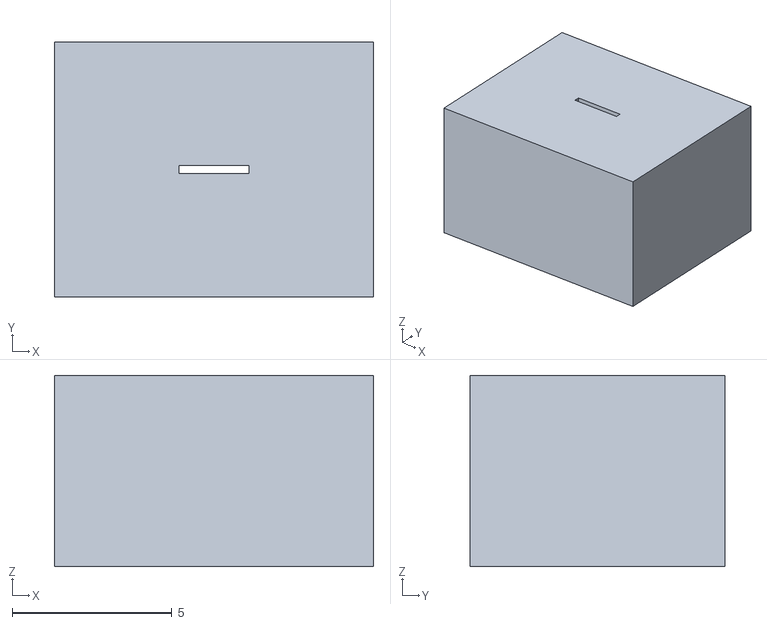
[picture p78: CAD file, 2026-10-03]
cad/stl_tripped/balance_upper_clamp.stl
10.0 x 8.00 x 6.00
