Senekw/chronoflow/cad/stl_tripped/occlusion_trip_spring.stl

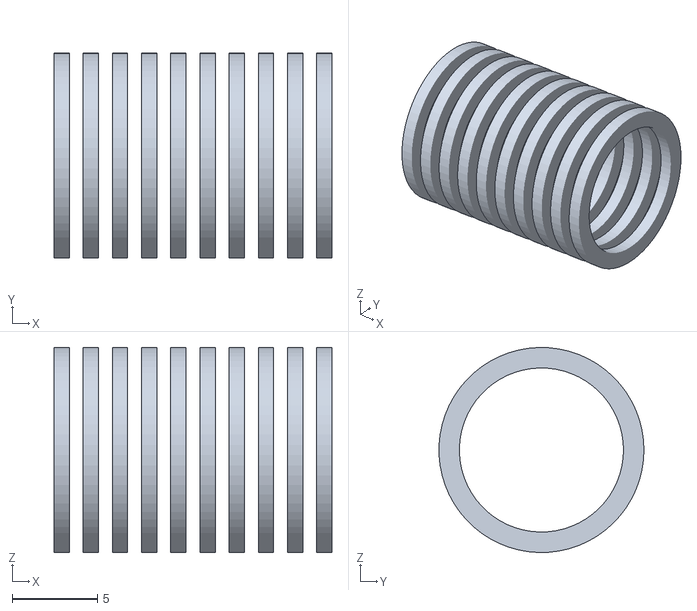
[picture p79: CAD file, 2026-10-03]
cad/stl_tripped/occlusion_trip_spring.stl
16.3 x 12.0 x 12.0
