Senekw/chronoflow/cad/stl_tripped/W4_30T.stl

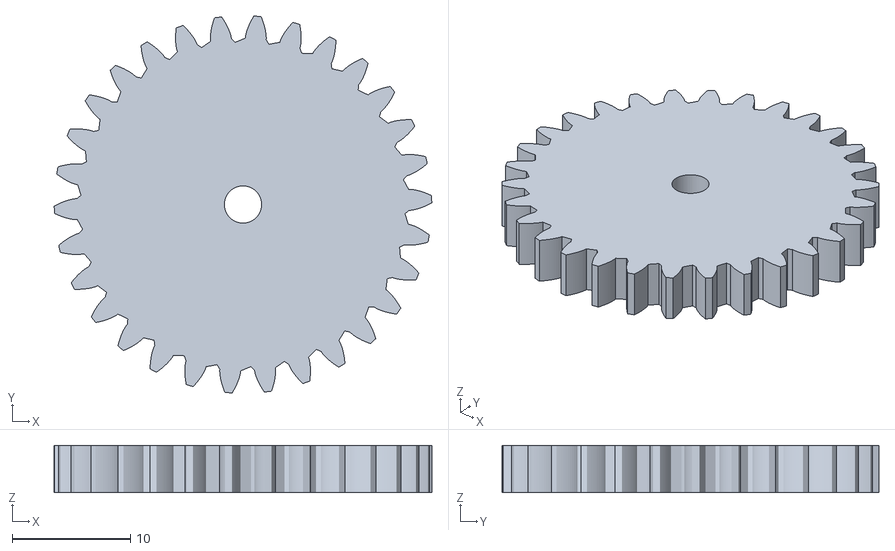
[picture p80: CAD file, 2026-10-03]
cad/stl_tripped/W4_30T.stl
32.0 x 31.9 x 4.00
