Senekw/chronoflow/cad/stl/capture_pin_guide.stl

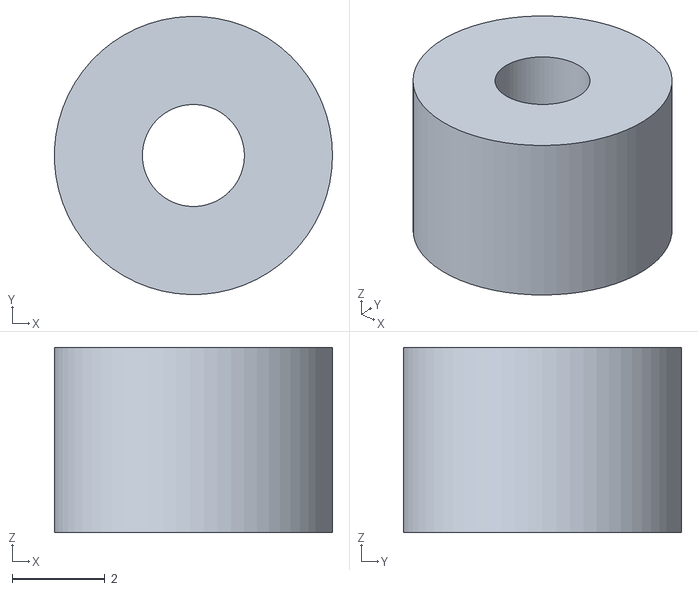
[picture p81: CAD file, 2026-10-03]
cad/stl/capture_pin_guide.stl
6.00 x 6.00 x 4.00
