Senekw/chronoflow/cad/stl_tripped/trip_sear.stl

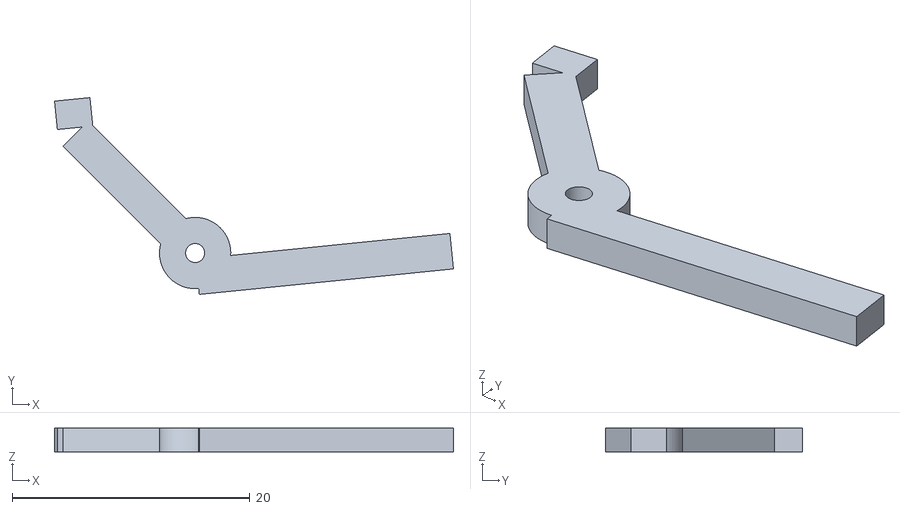
[picture p82: CAD file, 2026-10-03]
cad/stl_tripped/trip_sear.stl
33.6 x 16.6 x 2.00
