Senekw/chronoflow/cad/stl/flag_spring.stl

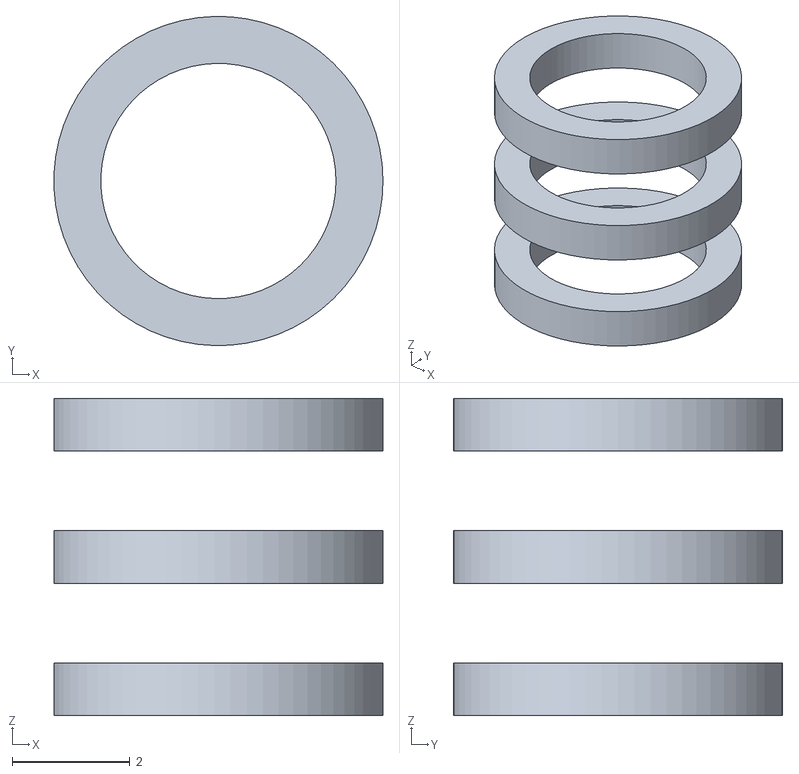
[picture p83: CAD file, 2026-10-03]
cad/stl/flag_spring.stl
5.60 x 5.60 x 5.40
