Senekw/chronoflow/cad/stl_tripped/capture_rocker.stl

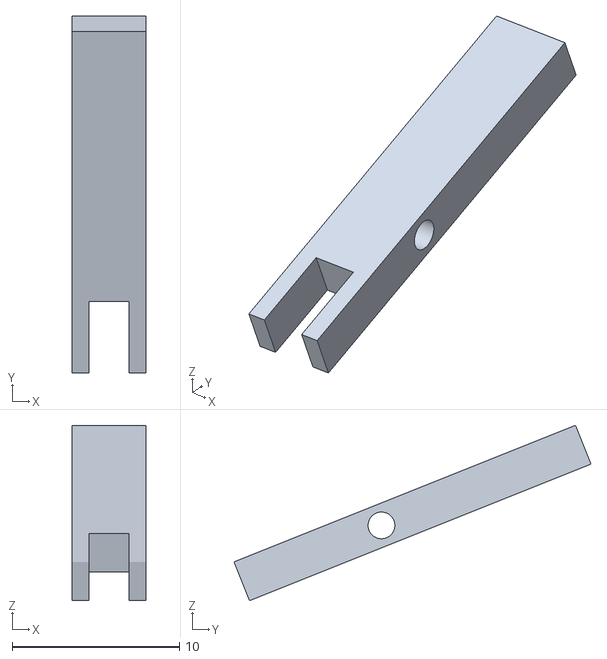
[picture p84: CAD file, 2026-10-03]
cad/stl_tripped/capture_rocker.stl
4.40 x 21.4 x 10.5
