Senekw/chronoflow/cad/stl/capture_rocker.stl

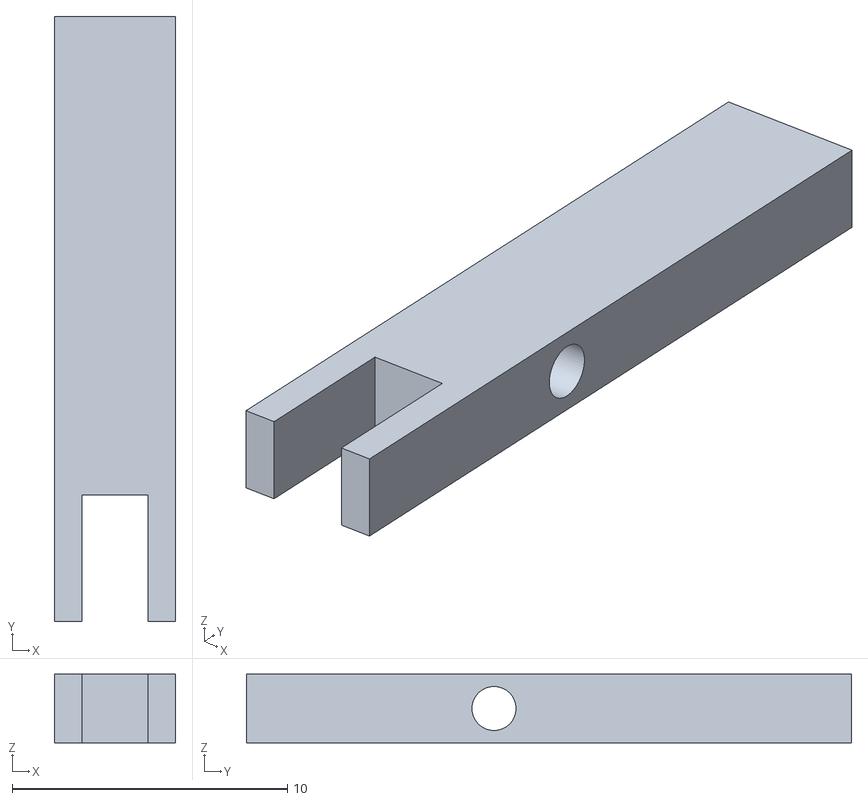
[picture p85: CAD file, 2026-10-03]
cad/stl/capture_rocker.stl
4.40 x 22.0 x 2.50
