Senekw/chronoflow/cad/stl/trip_rail_pivot_pins.stl

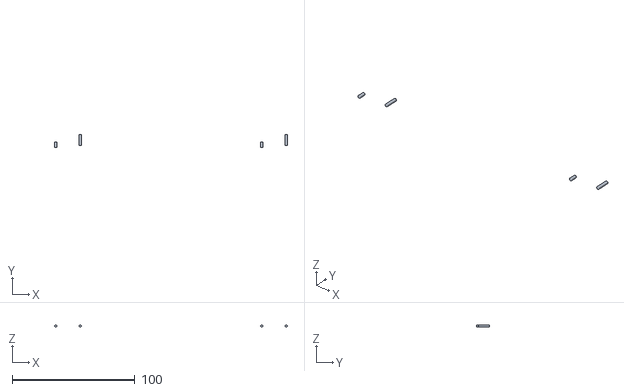
[picture p86: CAD file, 2026-10-03]
cad/stl/trip_rail_pivot_pins.stl
190.0 x 11.0 x 2.00
