Senekw/chronoflow/cad/stl_tripped/plunger_stopper.stl

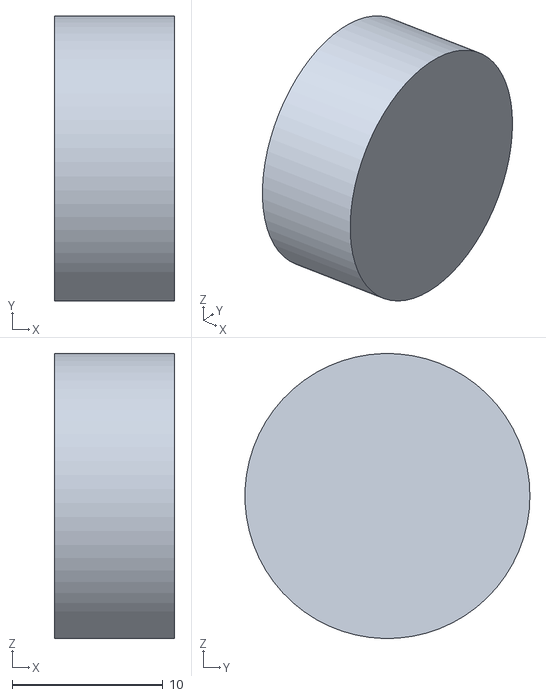
[picture p87: CAD file, 2026-10-03]
cad/stl_tripped/plunger_stopper.stl
8.00 x 18.9 x 18.9
