Senekw/chronoflow/cad/stl_tripped/balance_impulse_pin.stl

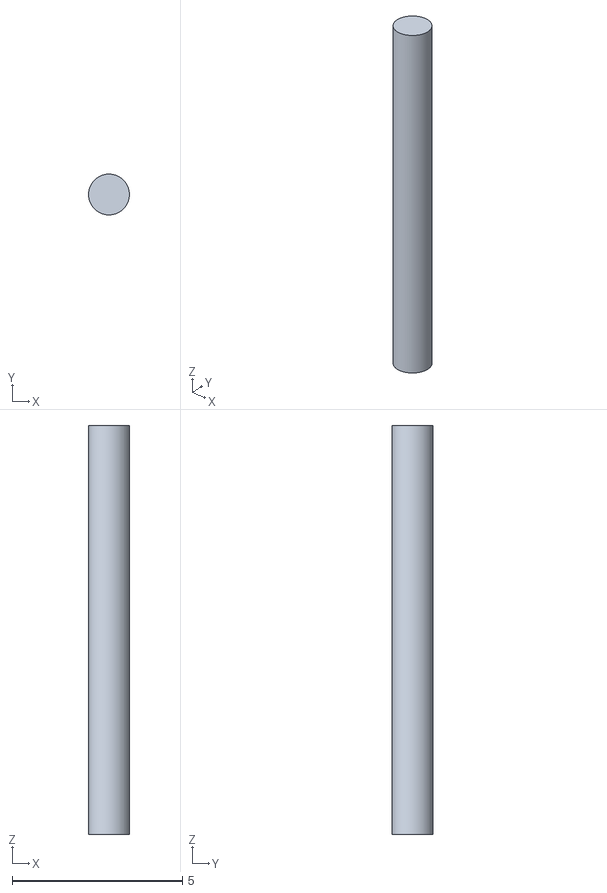
[picture p88: CAD file, 2026-10-03]
cad/stl_tripped/balance_impulse_pin.stl
1.20 x 1.20 x 12.0
