Senekw/chronoflow/cad/stl_tripped/shaft_S6.stl

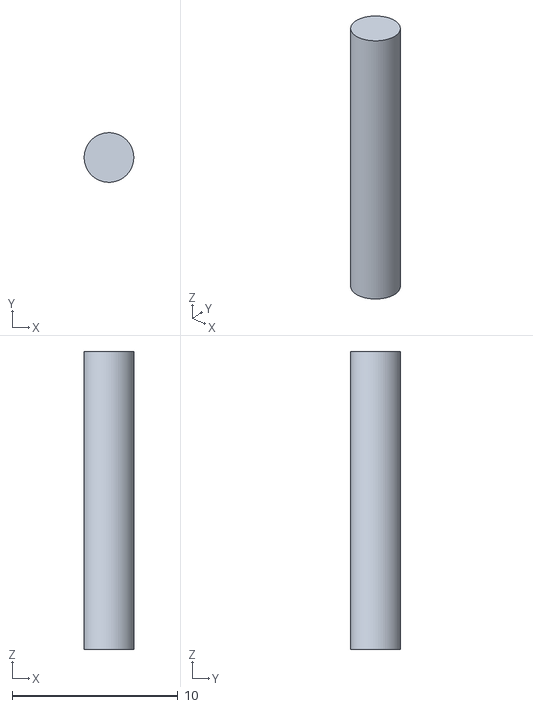
[picture p89: CAD file, 2026-10-03]
cad/stl_tripped/shaft_S6.stl
3.00 x 3.00 x 18.0
