Senekw/chronoflow/cad/stl_tripped/balance_band_lower.stl

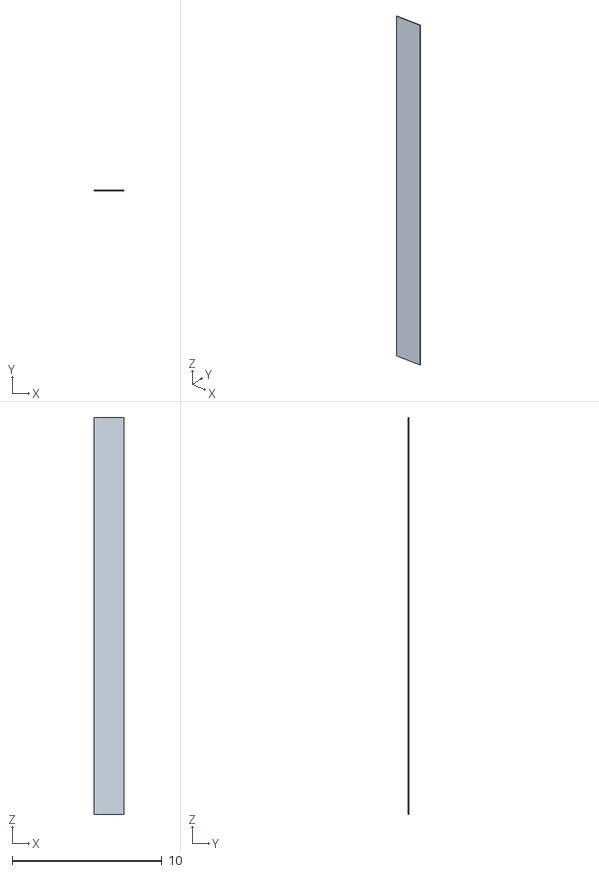
[picture p90: CAD file, 2026-10-03]
cad/stl_tripped/balance_band_lower.stl
2.00 x 0.0381 x 26.5
