Senekw/chronoflow/cad/stl_tripped/rail_posts.stl

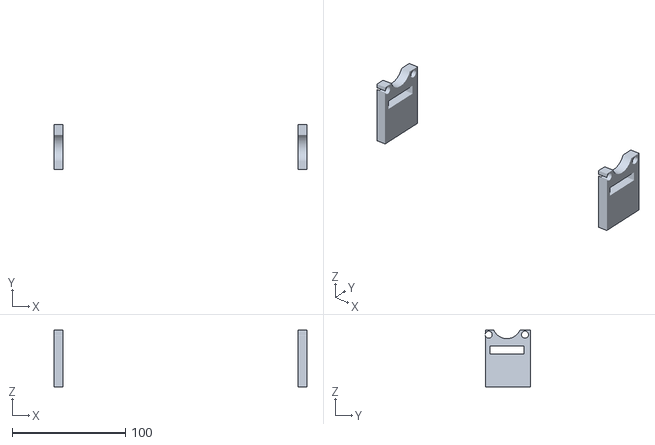
[picture p91: CAD file, 2026-10-03]
cad/stl_tripped/rail_posts.stl
223.0 x 40.0 x 50.0
