Senekw/chronoflow/cad/stl_tripped/drum_bracket.stl

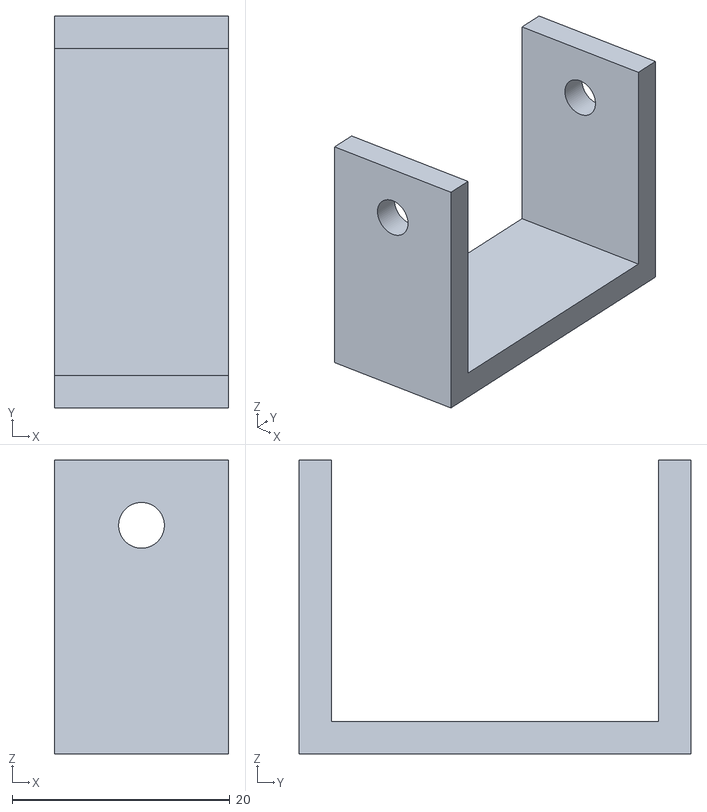
[picture p92: CAD file, 2026-10-03]
cad/stl_tripped/drum_bracket.stl
16.0 x 36.0 x 27.0
