Senekw/chronoflow/cad/stl_tripped/rate_cassette_plate_10_mL_h.stl

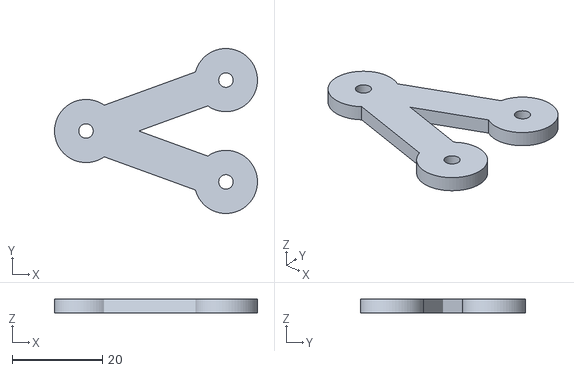
[picture p93: CAD file, 2026-10-03]
cad/stl_tripped/rate_cassette_plate_10_mL_h.stl
45.0 x 36.6 x 3.00
