Senekw/chronoflow/cad/stl_tripped/shaft_S7.stl

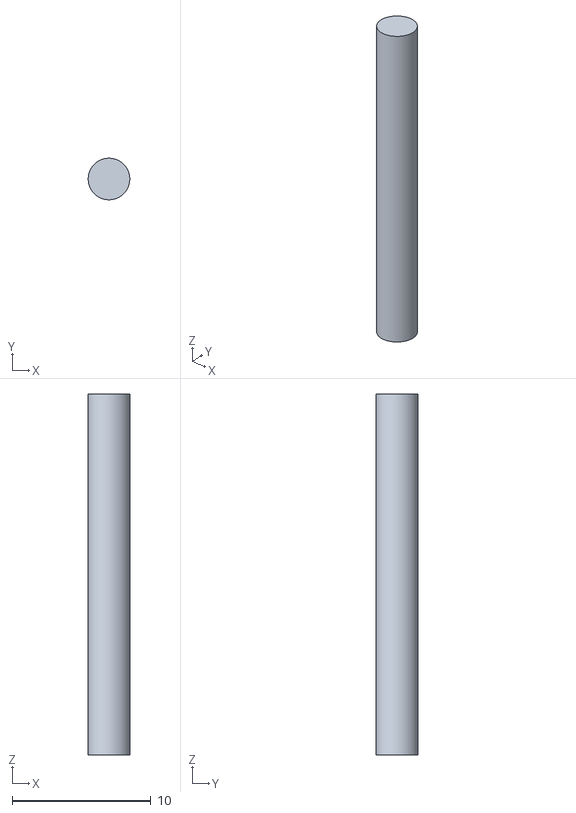
[picture p94: CAD file, 2026-10-03]
cad/stl_tripped/shaft_S7.stl
3.00 x 3.00 x 26.0
