Senekw/chronoflow/cad/stl_tripped/shaft_S4.stl

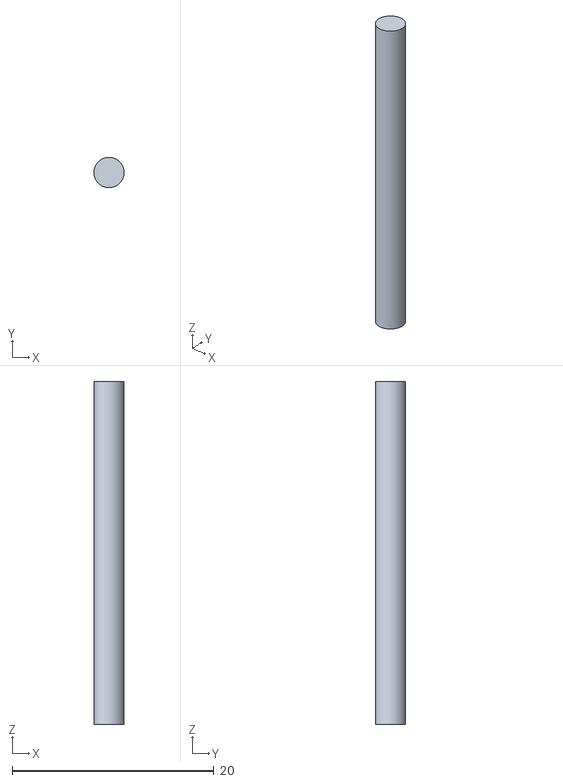
[picture p95: CAD file, 2026-10-03]
cad/stl_tripped/shaft_S4.stl
3.00 x 3.00 x 34.0
