Senekw/chronoflow/cad/stl_tripped/shaft_S5.stl

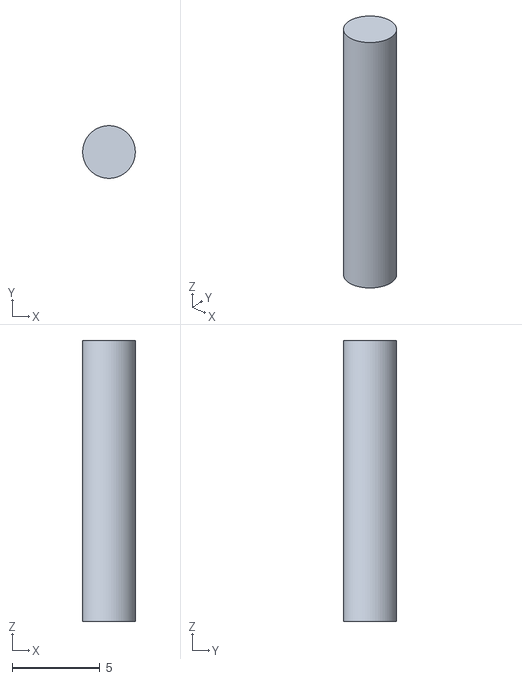
[picture p96: CAD file, 2026-10-03]
cad/stl_tripped/shaft_S5.stl
3.00 x 3.00 x 16.0
