Senekw/chronoflow/cad/stl_tripped/pillars.stl

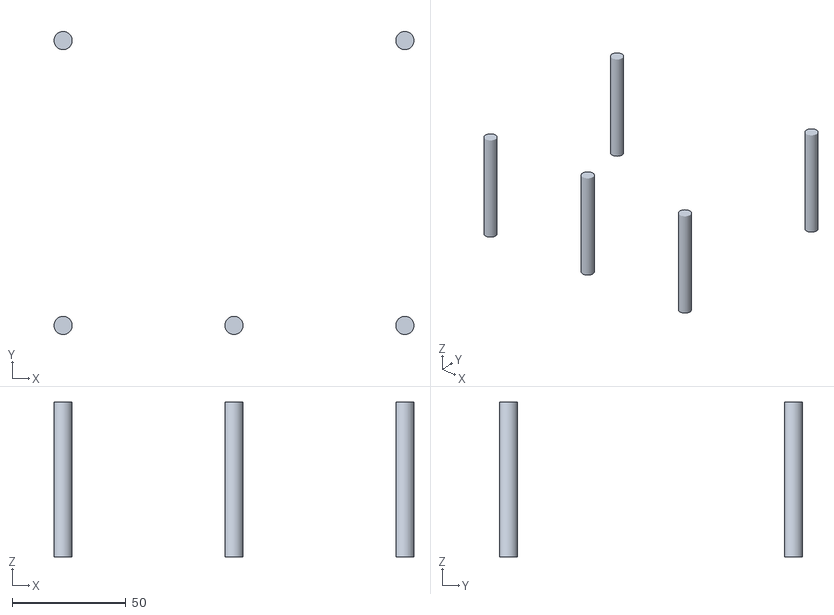
[picture p97: CAD file, 2026-10-03]
cad/stl_tripped/pillars.stl
158.0 x 133.0 x 68.0
