Senekw/chronoflow/cad/stl_tripped/balance_balance.stl

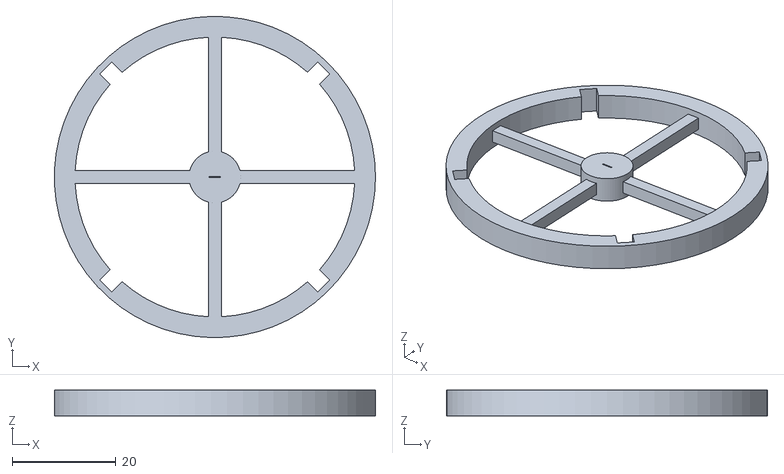
[picture p98: CAD file, 2026-10-03]
cad/stl_tripped/balance_balance.stl
62.0 x 62.0 x 5.00
