Senekw/chronoflow/cad/stl_tripped/balance_trims.stl

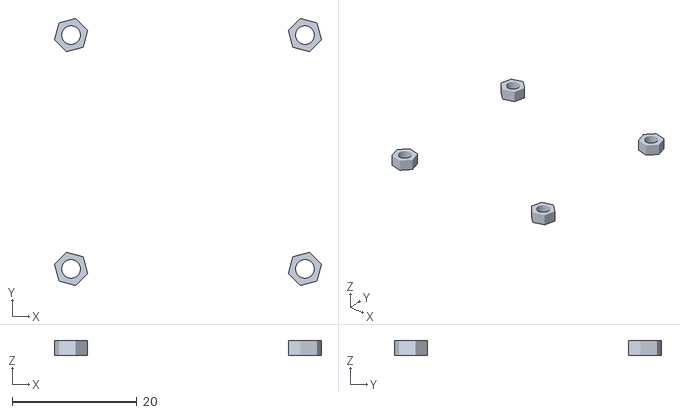
[picture p99: CAD file, 2026-10-03]
cad/stl_tripped/balance_trims.stl
42.8 x 42.8 x 2.40
