Senekw/chronoflow/cad/stl_tripped/barrel_clamp.stl

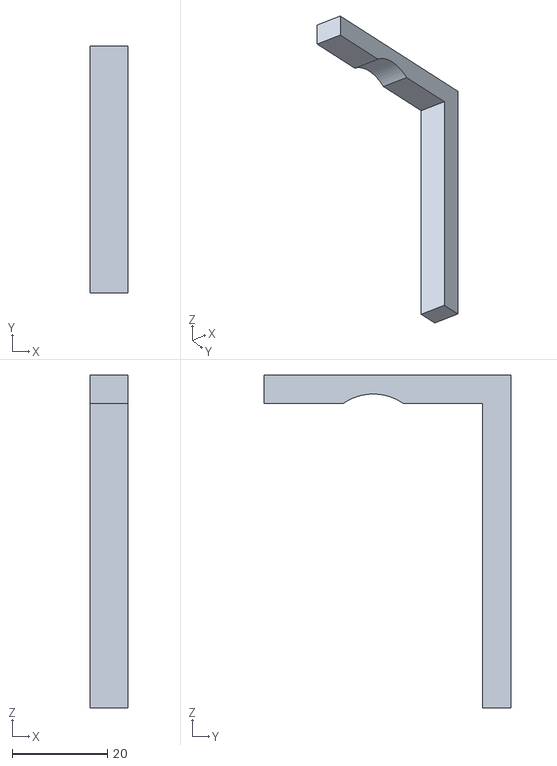
[picture p100: CAD file, 2026-10-03]
cad/stl_tripped/barrel_clamp.stl
8.00 x 52.0 x 70.0
