Senekw/chronoflow/cad/stl_tripped/shaft_S3.stl

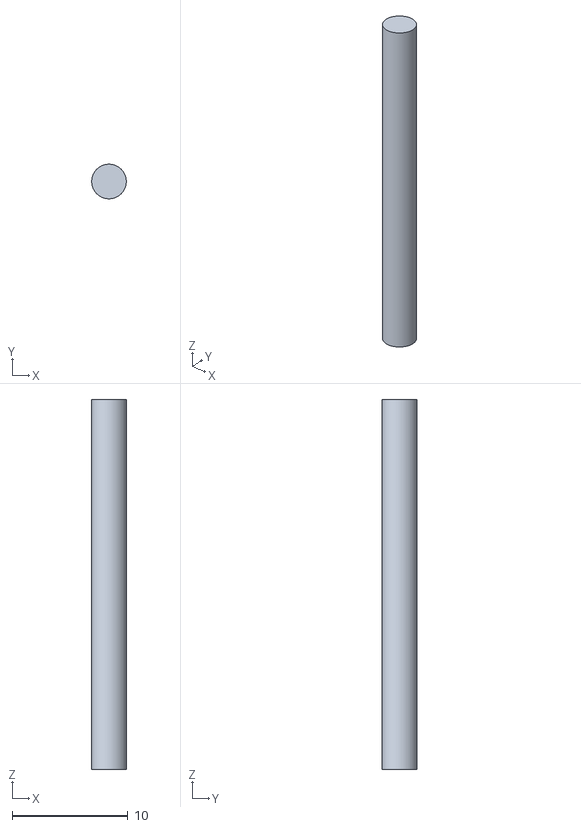
[picture p101: CAD file, 2026-10-03]
cad/stl_tripped/shaft_S3.stl
3.00 x 3.00 x 32.0
