Senekw/chronoflow/cad/stl_tripped/constant_force_spring_coil.stl

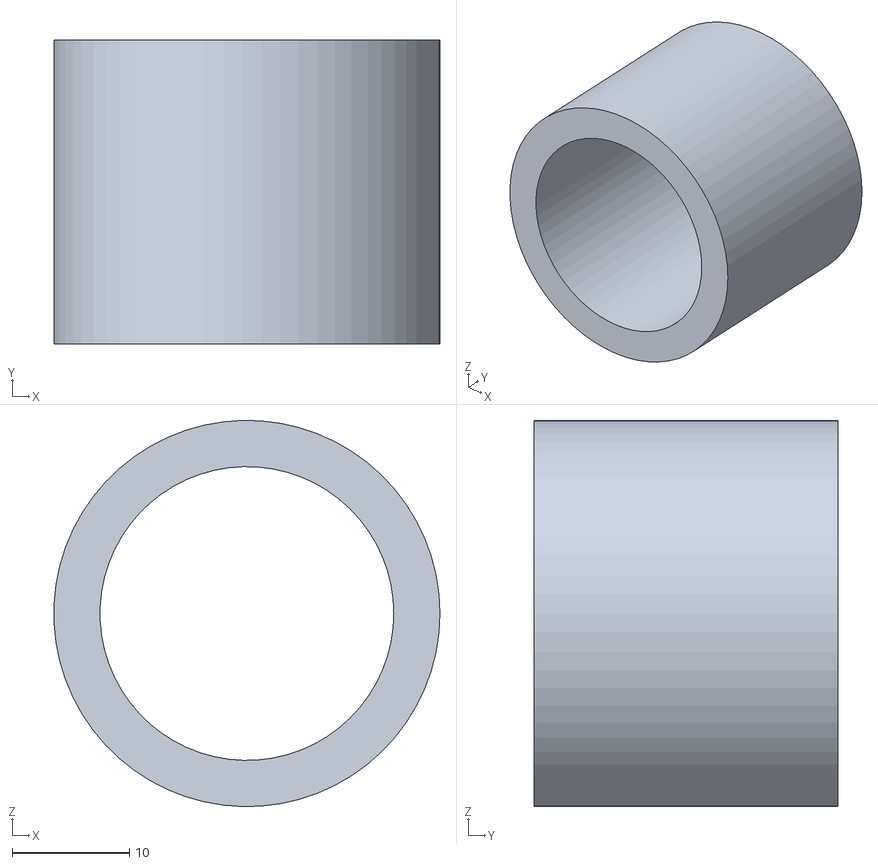
[picture p102: CAD file, 2026-10-03]
cad/stl_tripped/constant_force_spring_coil.stl
33.0 x 26.0 x 33.0
