Senekw/chronoflow/cad/stl_tripped/impulse_arm_B_pivot_pin.stl

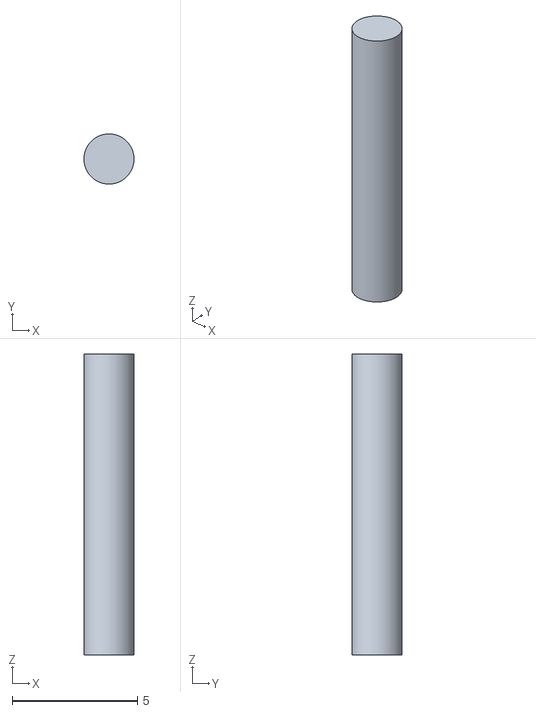
[picture p103: CAD file, 2026-10-03]
cad/stl_tripped/impulse_arm_B_pivot_pin.stl
2.00 x 2.00 x 12.0
