Senekw/chronoflow/cad/stl_tripped/spring_drum.stl

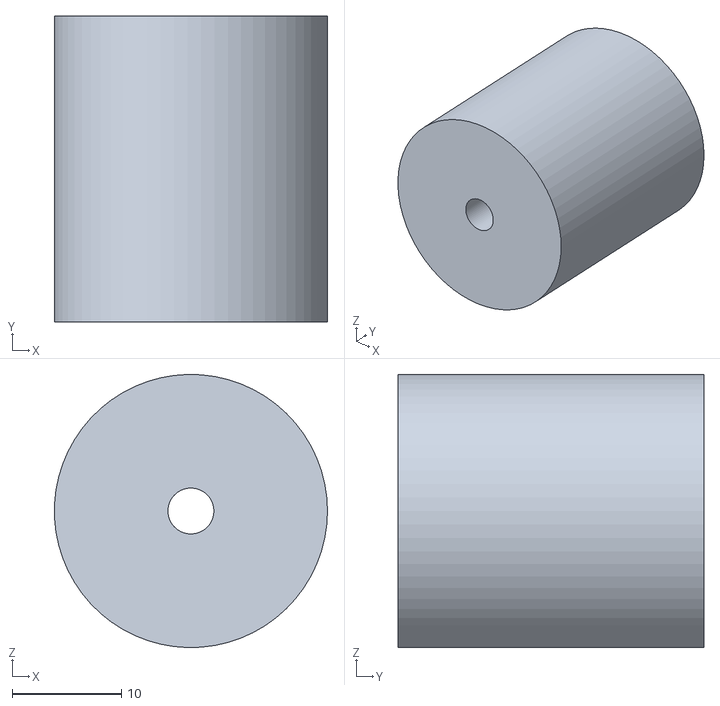
[picture p104: CAD file, 2026-10-03]
cad/stl_tripped/spring_drum.stl
25.0 x 28.0 x 25.0
