Senekw/chronoflow/cad/stl_tripped/syringe_barrel_BD_20_mL.stl

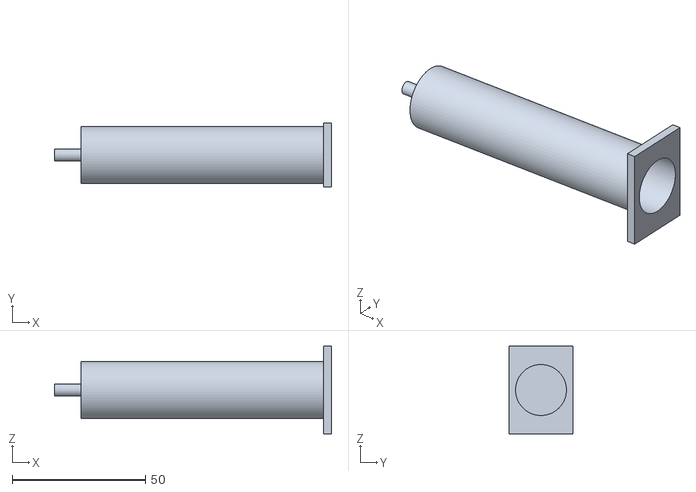
[picture p105: CAD file, 2026-10-03]
cad/stl_tripped/syringe_barrel_BD_20_mL.stl
104.0 x 24.0 x 33.0
