Senekw/chronoflow/cad/stl_tripped/feet.stl

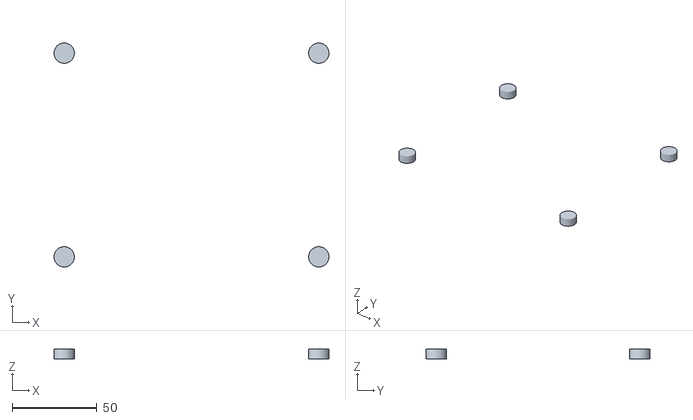
[picture p106: CAD file, 2026-10-03]
cad/stl_tripped/feet.stl
162.0 x 132.0 x 6.00
