Senekw/chronoflow/cad/stl_tripped/winding_ratchet_click.stl

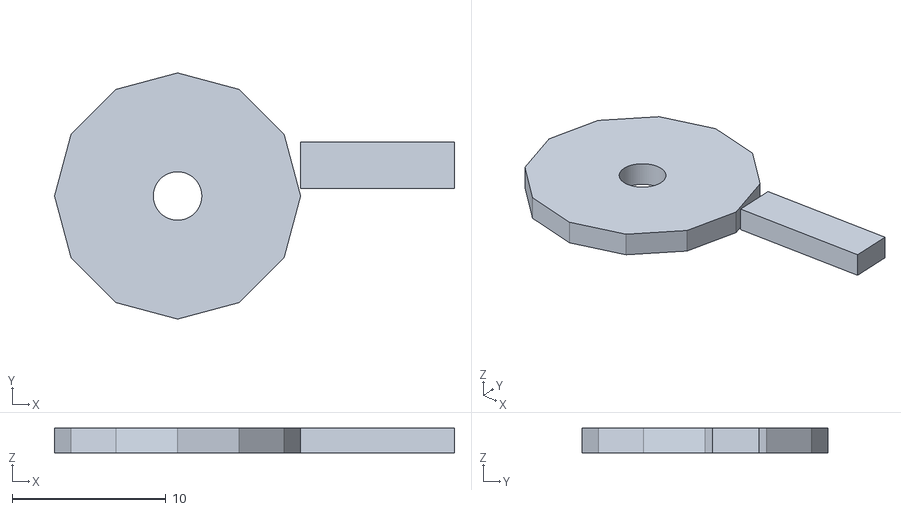
[picture p107: CAD file, 2026-10-03]
cad/stl_tripped/winding_ratchet_click.stl
26.0 x 16.0 x 1.60
