Senekw/chronoflow/cad/stl_tripped/impulse_arm_A_pallet_pin.stl

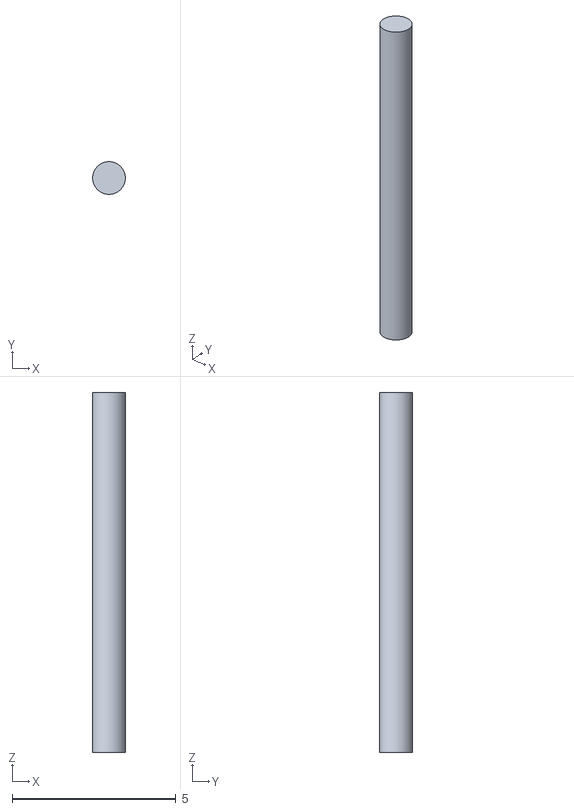
[picture p108: CAD file, 2026-10-03]
cad/stl_tripped/impulse_arm_A_pallet_pin.stl
0.999 x 1 x 11.0
