Senekw/chronoflow/(list of files, cad)

Other CAD files:
cad/chronoflow_assembly.step
cad/stl_tripped/impulse_arm_A_torsion_spring.stl
cad/stl/impulse_arm_A_torsion_spring.stl
cad/stl_tripped/flag_rod_occlusion_flag.stl
cad/stl/cassette_g2_33T.stl
cad/stl/stem_capture_pin.stl
cad/stl/W2_60T.stl
cad/stl/trip_rail.stl
cad/stl_tripped/cassette_g2_33T.stl
cad/stl/P2_12T.stl
cad/stl_tripped/P0_rack_pinion.stl
cad/stl/P0_rack_pinion.stl
cad/stl_tripped/P2_12T.stl
cad/stl_tripped/P4_12T.stl
cad/stl/drop_rod_balance_stop_fork.stl
cad/stl_tripped/cassette_g4_33T.stl
cad/stl_tripped/W2_60T.stl
cad/stl/cassette_g4_33T.stl
cad/stl/cassette_g3_33T.stl
cad/stl/P4_12T.stl
cad/stl_tripped/cassette_g3_33T.stl
cad/stl_tripped/pusher_head_trip_stem.stl
cad/stl_tripped/balance_band_upper.stl
cad/stl_tripped/impulse_arm_A_pivot_pin.stl
cad/stl_tripped/impulse_arm_B_pallet_pin.stl
cad/stl/balance_clamp_screws.stl
cad/stl_tripped/LOAD_RUN_interlock_lever.stl
cad/stl_tripped/balance_clamp_screws.stl
cad/stl_tripped/balance_window.stl
cad/stl_tripped/drum_axle.stl
cad/stl_tripped/latch.stl
cad/stl_tripped/rails_6_mm.stl
cad/stl_tripped/shaft_S1.stl
cad/stl_tripped/shaft_S2.stl
