Senekw/chronoflow/figures/analysis/fig5_operating_map.png

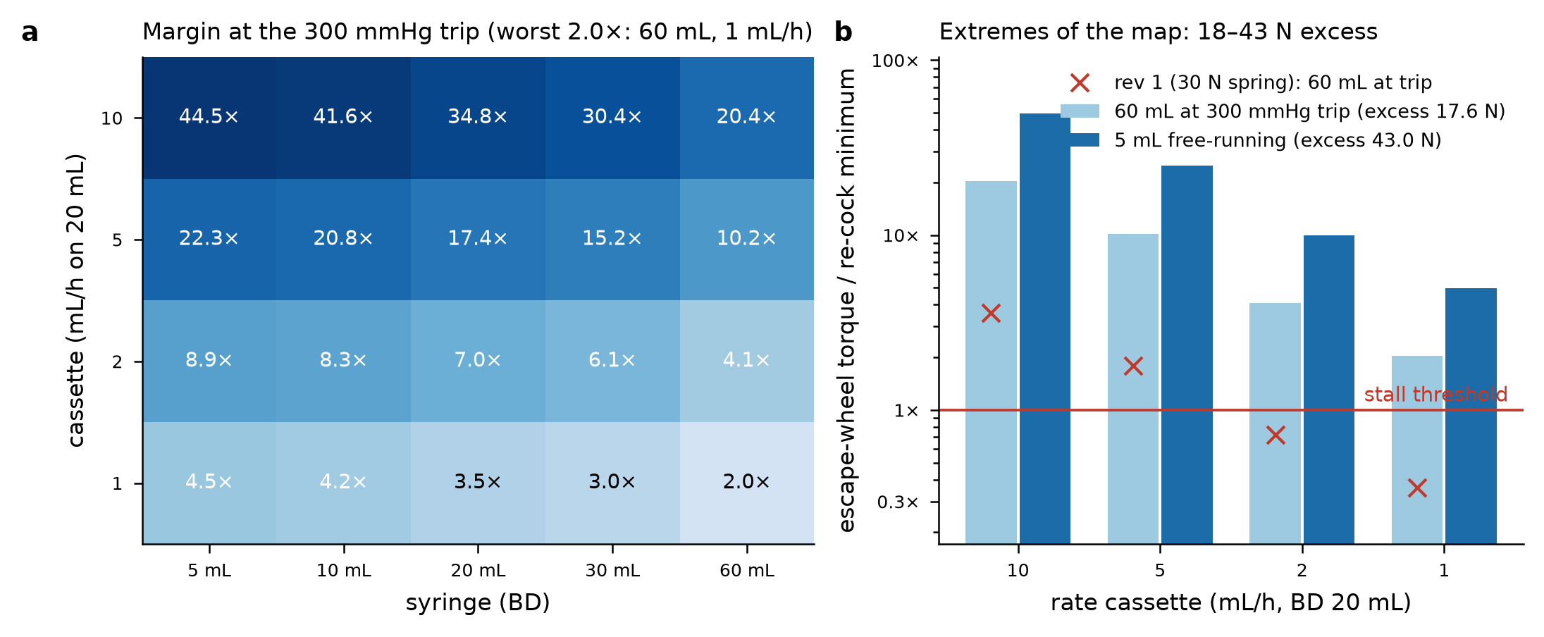
figures/analysis/fig5_operating_map.png
