Senekw/chronoflow/results/escapement_sweep.csv

T_e | model | status | reason | t | T_min | period | freq | period_jitter | amplitude | free_period | rate_error
1e-06 | lever | stall | reversal inside engagement window | 25.392599999967498
1e-06 | arm | stall | T_e 1.00e-06 < T_min 9.55e-06 |  | 9.549296585513721e-06
1.2822089387164721e-06 | lever | stall | reversal inside engagement window | 28.310199999960698
1.2822089387164721e-06 | arm | stall | T_e 1.28e-06 < T_min 9.55e-06 |  | 9.549296585513721e-06
1.6440597625244252e-06 | lever | stall | reversal inside engagement window | 34.1461999999471
1.6440597625244252e-06 | arm | stall | T_e 1.64e-06 < T_min 9.55e-06 |  | 9.549296585513721e-06
2.108028123292898e-06 | lever | stall | reversal inside engagement window | 47.48719999991601
2.108028123292898e-06 | arm | stall | T_e 2.11e-06 < T_min 9.55e-06 |  | 9.549296585513721e-06
2.702932502751869e-06 | lever | ok |  |  |  | 0.8335459907975389 | 1.1996938513772917 | 0.00015198724013279393 | 0.34642725506142535 | 0.8321647928931023 | 0.0016597648881956568
2.702932502751869e-06 | arm | stall | T_e 2.70e-06 < T_min 9.55e-06 |  | 9.549296585513721e-06
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
