Senekw/chronoflow/results/flow_table.csv

cassette | ratio | syringe | flow_mL_h | uL_per_beat
10 mL/h | 1.0 | BD 5 mL | 3.974336868631254 | 0.4593506542944898
10 mL/h | 1.0 | BD 10 mL | 5.745212072787809 | 0.664026984105292
10 mL/h | 1.0 | BD 20 mL | 10.000000000000004 | 1.1557919458716857
10 mL/h | 1.0 | BD 30 mL | 12.86736224948895 | 1.48719936525727
10 mL/h | 1.0 | BD 60 mL | 19.480162827917724 | 2.25150153007763
5 mL/h | 2.0 | BD 5 mL | 1.987168434315627 | 0.2296753271472449
5 mL/h | 2.0 | BD 10 mL | 2.8726060363939045 | 0.332013492052646
5 mL/h | 2.0 | BD 20 mL | 5.000000000000002 | 0.5778959729358428
5 mL/h | 2.0 | BD 30 mL | 6.433681124744475 | 0.743599682628635
5 mL/h | 2.0 | BD 60 mL | 9.740081413958862 | 1.125750765038815
2 mL/h | 5.0 | BD 5 mL | 0.7948673737262508 | 0.09187013085889795
2 mL/h | 5.0 | BD 10 mL | 1.149042414557562 | 0.1328053968210584
2 mL/h | 5.0 | BD 20 mL | 2.000000000000001 | 0.23115838917433718
2 mL/h | 5.0 | BD 30 mL | 2.57347244989779 | 0.297439873051454
2 mL/h | 5.0 | BD 60 mL | 3.896032565583545 | 0.45030030601552595
1 mL/h | 10.0 | BD 5 mL | 0.3974336868631254 | 0.045935065429448974
1 mL/h | 10.0 | BD 10 mL | 0.574521207278781 | 0.0664026984105292
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
