Senekw/chronoflow/results/arm_vs_Q.csv

Q | status | period | freq | period_jitter | amplitude | free_period | rate_error
40 | ok | 0.8359108566879688 | 1.1962998111571157 | 2.0108110219078426e-06 | 0.3065503162487238 | 0.8321647928931023 | 0.004501588900250118
60 | ok | 0.8340946000333725 | 1.1989047764605951 | 1.9925885796671235e-06 | 0.3748686631530072 | 0.8321647928931023 | 0.002319020411283061
100 | ok | 0.8330276073985293 | 1.200440406918698 | 9.76840455934309e-07 | 0.483503511228807 | 0.8321647928931023 | 0.0010368313016792792
150 | ok | 0.832635708370592 | 1.2010054216350243 | 5.149567212912124e-06 | 0.5879933870881331 | 0.8321647928931023 | 0.0005658920943440678
250 | ok | 0.8324075908420033 | 1.2013345517290062 | 1.149139322766747e-05 | 0.7302683167447758 | 0.8321647928931023 | 0.0002917666680621266
400 | ok | 0.8323170575553431 | 1.2014652240063062 | 1.3923910844922764e-05 | 0.8521366137328932 | 0.8321647928931023 | 0.00018297416994952142
800 | ok | 0.8322621622868158 | 1.2015444715788701 | 1.409759642281461e-05 | 0.989325579584851 | 0.8321647928931023 | 0.00011700734583471842
