Senekw/chronoflow/results/montecarlo_summary.csv

 | calibration | temperature | orientation | escapement | syringe | rack | total
count | 20000.0 | 20000.0 | 20000.0 | 20000.0 | 20000.0 | 20000.0 | 20000.0
mean | 0.0012835294002919984 | -0.0008440918905556403 | -0.0007791287472734967 | 1.5543122344752192e-18 | 0.001880099796771038 | -3.356885764233786e-05 | 0.0015068397015915644
std | 0.17348378778804843 | 0.10227181853976579 | 0.10800396066830514 | 0.04585037998451538 | 0.5760675436045236 | 0.11458974493593023 | 0.6354244788578535
min | -0.29994835197187864 | -0.1766331081580909 | -0.18715254839956882 | -0.17868933895668376 | -0.9999311372471065 | -0.19999535185362186 | -1.7147395745975234
25% | -0.1484200141136232 | -0.08963068169904999 | -0.0944213757720003 | -0.008291488119253267 | -0.49834911382734726 | -0.09890846611309917 | -0.4970858484011076
50% | 0.002309955448607037 | -0.0005565861143034109 | -0.001523692179403978 | 0.019492995962304586 | 0.011269877413901841 | 0.0007247327834398077 | 0.008112125514214759
75% | 0.15272637186684818 | 0.08722765457518328 | 0.09233022844171579 | 0.029228034187286034 | 0.4983444320779433 | 0.0981827571112785 | 0.5044968011917068
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
