Senekw/chronoflow/(commit log)

2026-10-03 ChronoFlow: parametric CAD, physics validation, manuscript figures, LaTeX manuscript, viewer
    [LOAD-RUN_interlock_lever.stl, P0_rack_pinion.stl, P1_12T.stl, P2_12T.stl, P3_12T.stl, P4_12T.stl, W1_60T.stl, W2_60T.stl]
2026-10-03 Revision 2 (external review): 44.5 N drive spring (60 mL stalled before trip at 30 N), trip preload keyed to syringe insert with friction-dependent pressure band, 38.1 um ribbon with 22 mm half-band 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
    [LOAD_RUN_interlock_lever.stl, P0_rack_pinion.stl, P1_12T.stl, P2_12T.stl, P3_12T.stl, P4_12T.stl, W1_60T.stl, W2_60T.stl]
2026-10-03 Clarify mesh count: seven meshes total (rack at 0.95 + six printed gear meshes at 0.92)
2026-10-03 Revision 3: snap-action occlusion trip (0.3 mm sensing travel, sear captures stem, sprung flag rod), symmetric two-clamp band regulation, completed bibliography, abstract ribbon spec; new Fig 5 (trip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
    [bom.csv]
2026-10-03 Revision 4 (review round 5): modelled occlusion trip (armed/tripped), slotted band clamps, wheel detent, mechanism-level escapement analysis, explicit-whitelist 12-pose interference check, watertight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
    [LOAD_RUN_interlock_lever.stl, P0_rack_pinion.stl, P1_12T.stl, P2_12T.stl, P3_12T.stl, P4_12T.stl, W1_60T.stl, W2_60T.stl]
2026-10-06 Revision 5 (review round 6): release linkage and reset ramp modelled, forward impulse model, flexure correction, half-period re-cock budget, bolus wording
    [chronoflow_assembly.step, flag_rod_occlusion_flag.stl, impulse_arm_A.stl, impulse_arm_A_flexure.stl, impulse_arm_A_post.stl, impulse_arm_A_torsion_spring.stl, impulse_arm_B.stl, impulse_arm_B_flexure.stl]
